kscalelabs/motor-controller/README.md

# K-Scale Motor Controller

## `archive/`
Old motor driver designs

## `pcb/`
New designs, focused on EtherCAT compatibility

No documentation yet (oops) but will show up soon<sup>TM</sup> once I can get some of the motor functions validated
