kscalelabs/motor-controller/pcb/high-power/EtherCATControllerHP/EtherCATControllerHP.kicad_pcb

## KiCad design pcb/high-power/EtherCATControllerHP/EtherCATControllerHP.kicad_pcb (2024-08-08)

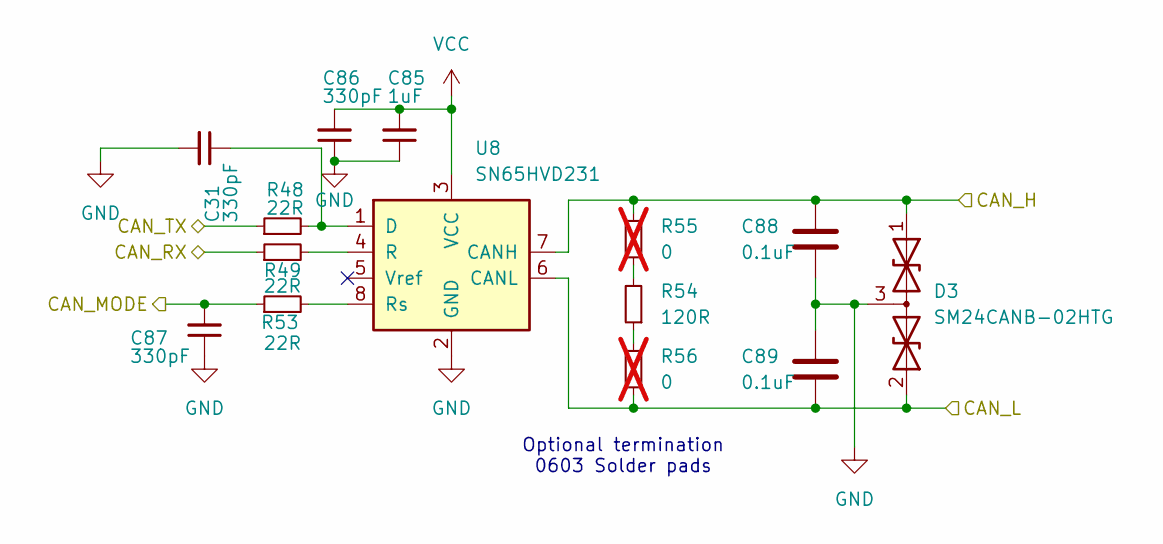
[picture p12: schematic CAN.kicad_sch]

Parts:
C31, C86, C87: 330pF; C_0402_1005Metric; LCSC Part # C526998
C85: 1uF; C_0603_1608Metric; LCSC Part # C106858
C88, C89: 0.1uF; C_0603_1608Metric; TOLERANCE ±10%; VOLTAGE - RATED 50V; MANUFACTURER PART NUMBER GRM188R71H104KA93D; LCSC Part # C77055
D3: SM24CANB-02HTG; SOT-23; LCSC Part # C2937019
R48, R49, R53: 22R; R_0603_1608Metric; LCSC Part # C107701
R54: 120R; R_0402_1005Metric; LCSC Part # C409666
R55, R56: 0; R_0603_1608Metric_Pad0.98x0.95mm_HandSolder; not fitted
U8: SN65HVD231; SOIC-8_3.9x4.9mm_P1.27mm; LCSC Part # C129257

Connections:
/CAN_H: C88.1, D3.1 (A1), R55.1, U8.7 (CANH); also elsewhere on the board
/CAN_L: C89.2, D3.2 (A2), R56.2, U8.6 (CANL); also elsewhere on the board
/CAN_MODE: C87.2, R53.1; also elsewhere on the board
/CAN_RX: R49.1; also elsewhere on the board
/CAN_TX: R48.1; also elsewhere on the board
GND: C31.2, C85.1, C86.1, C87.1, C88.2, C89.1, D3.3 (common), U8.2 (GND); also elsewhere on the board
unnamed: R54.1, R56.1
unnamed: R54.2, R55.2
unnamed: C31.1, R48.2, U8.1 (D)
unnamed: R49.2, U8.4 (R)
unnamed: R53.2, U8.8 (Rs)
VCC: C85.2, C86.2, U8.3 (VCC); also elsewhere on the board

Notes on the sheet:
Optional termination 0603 Solder pads

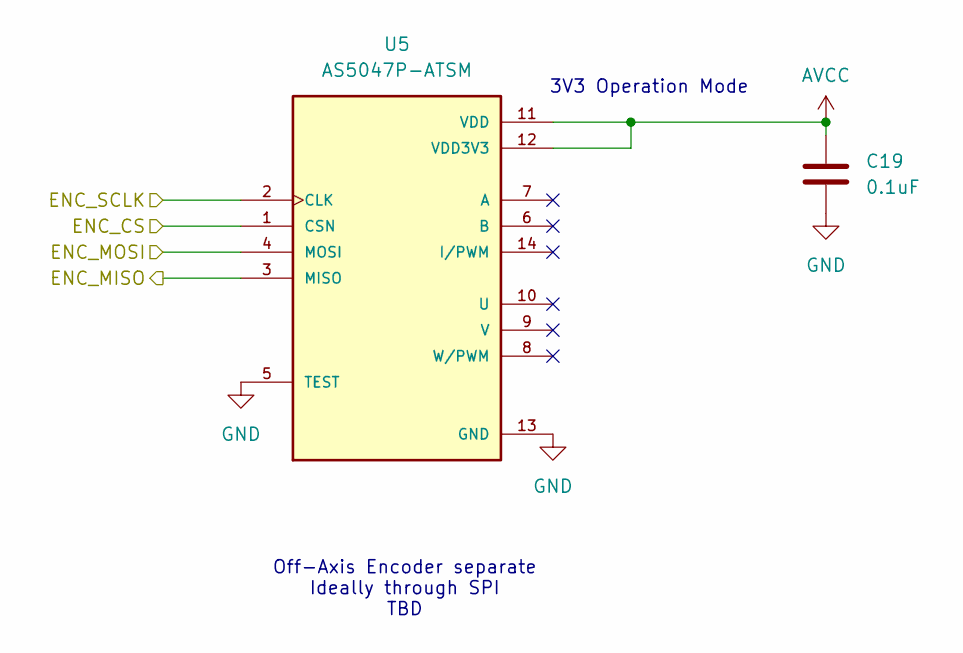
[picture p13: schematic Encoders.kicad_sch]

Parts:
C19: 0.1uF; C_0402_1005Metric; LCSC Part # C77055
U5: AS5047P-ATSM; SOP65P640X120-14N; PARTREV 1-01; LCSC Part # C962063

Connections:
/SPI1_CS: U5.1 (CSN); also elsewhere on the board
/SPI1_MISO: U5.3 (MISO); also elsewhere on the board
/SPI1_MOSI: U5.4 (MOSI); also elsewhere on the board
/SPI1_SCK: U5.2 (CLK); also elsewhere on the board
AVCC: C19.1, U5.11 (VDD), U5.12 (VDD3V3); also elsewhere on the board
GND: C19.2, U5.5 (TEST), U5.13 (GND); also elsewhere on the board

Notes on the sheet:
Off-Axis Encoder separate Ideally through SPI TBD
3V3 Operation Mode

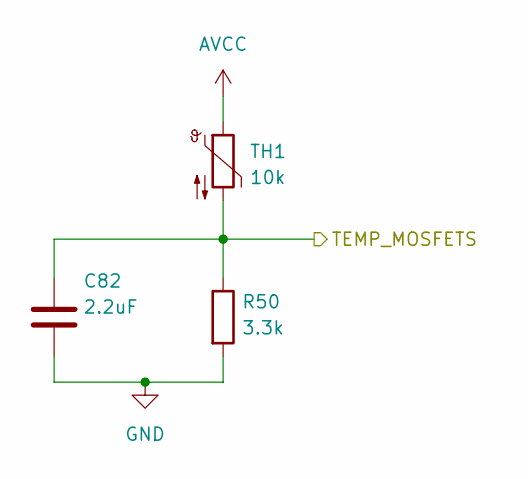
[picture p14: schematic Temperature.kicad_sch]

Parts:
C82: 2.2uF; C_0603_1608Metric; TOLERANCE ±10%; VOLTAGE - RATED 16V; MANUFACTURER PART NUMBER GRM188R61C225KE15D; LCSC Part # C77183
R50: 3.3k; R_0603_1608Metric; TOLERANCE ±1%; MANUFACTURER PART NUMBER RC0603FR-073K3L; LCSC Part # C108078
TH1: 10k; R_0402_1005Metric; LCSC Part # C77131

Connections:
/TEMP_MOSFETS: C82.1, R50.1, TH1.2; also elsewhere on the board
AVCC: TH1.1; also elsewhere on the board
GND: C82.2, R50.2; also elsewhere on the board

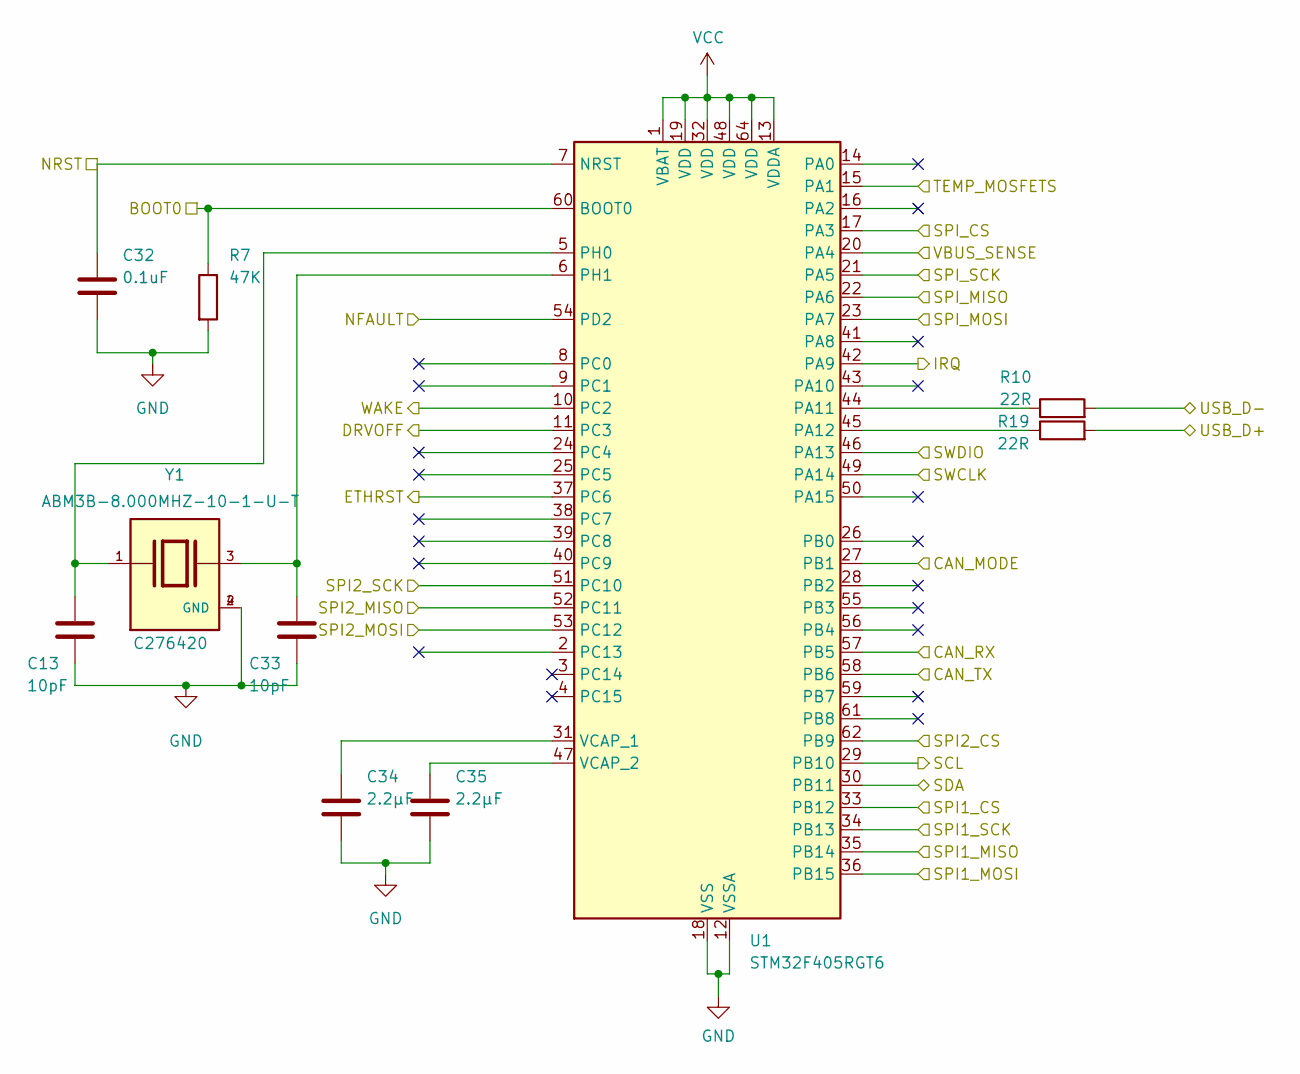
[picture p15: schematic MCU.kicad_sch]

Parts:
C13, C33: 10pF; C_0402_1005Metric; TOLERANCE ±5%; VOLTAGE - RATED 50V; MANUFACTURER PART NUMBER GRM1885C1H100JA01D; LCSC Part # C115606
C32: 0.1uF; C_0603_1608Metric; TOLERANCE ±10%; VOLTAGE - RATED 50V; MANUFACTURER PART NUMBER GRM188R71H104KA93D; LCSC Part # C77055
C34, C35: 2.2µF; C_0603_1608Metric; TOLERANCE ±10%; VOLTAGE - RATED 16V; MANUFACTURER PART NUMBER GRM188R61C225KE15D; LCSC Part # C77183
R7: 47K; R_0603_1608Metric; TOLERANCE ±1%; MANUFACTURER PART NUMBER RC0603FR-0747KL; LCSC Part # C105579
R10, R19: 22R; R_0402_1005Metric; LCSC Part # C107701
U1: STM32F405RGT6; LQFP-64_10x10mm_P0.5mm; LCSC Part # C15742
Y1: ABM3B-8.000MHZ-10-1-U-T; Crystal_SMD_5032-4Pin_5.0x3.2mm; PARTREV 08.25.15; LCSC Part # C276420

Connections:
/BOOT0: R7.1, U1.60 (BOOT0); also elsewhere on the board
/CAN_MODE: U1.27 (PB1); also elsewhere on the board
/CAN_RX: U1.57 (PB5); also elsewhere on the board
/CAN_TX: U1.58 (PB6); also elsewhere on the board
/DRVOFF: U1.11 (PC3); also elsewhere on the board
/ETHRST: U1.37 (PC6); also elsewhere on the board
/I2C_SCL: U1.29 (PB10); also elsewhere on the board
/I2C_SDA: U1.30 (PB11); also elsewhere on the board
/IRQ: U1.42 (PA9); also elsewhere on the board
/NFAULT: U1.54 (PD2); also elsewhere on the board
/NRST: C32.1, U1.7 (NRST)
/SPI1_CS: U1.33 (PB12); also elsewhere on the board
/SPI1_MISO: U1.35 (PB14); also elsewhere on the board
/SPI1_MOSI: U1.36 (PB15); also elsewhere on the board
/SPI1_SCK: U1.34 (PB13); also elsewhere on the board
/SPI2_CS: U1.62 (PB9); also elsewhere on the board
/SPI2_MISO: U1.52 (PC11); also elsewhere on the board
/SPI2_MOSI: U1.53 (PC12); also elsewhere on the board
/SPI2_SCK: U1.51 (PC10); also elsewhere on the board
/SPI_CS: U1.17 (PA3); also elsewhere on the board
/SPI_MISO: U1.22 (PA6); also elsewhere on the board
/SPI_MOSI: U1.23 (PA7); also elsewhere on the board
/SPI_SCK: U1.21 (PA5); also elsewhere on the board
/SWCLK: U1.49 (PA14); also elsewhere on the board
/SWDIO: U1.46 (PA13); also elsewhere on the board
/TEMP_MOSFETS: U1.15 (PA1); also elsewhere on the board
/USB_D+: R19.2; also elsewhere on the board
/USB_D-: R10.2; also elsewhere on the board
/VBUS_SENSE: U1.20 (PA4); also elsewhere on the board
/WAKE: U1.10 (PC2); also elsewhere on the board
GND: C13.2, C32.2, C33.2, C34.2, C35.2, R7.2, U1.12 (VSSA), U1.18 (VSS), U1.63 (VSS), Y1.2 (GND), Y1.4 (GND); also elsewhere on the board
unnamed: R10.1, U1.44 (PA11)
unnamed: R19.1, U1.45 (PA12)
unnamed: C13.1, U1.5 (PH0), Y1.1
unnamed: C33.1, U1.6 (PH1), Y1.3
unnamed: C34.1, U1.31 (VCAP_1)
unnamed: C35.1, U1.47 (VCAP_2)
VCC: U1.1 (VBAT), U1.13 (VDDA), U1.19 (VDD), U1.32 (VDD), U1.48 (VDD), U1.64 (VDD); also elsewhere on the board

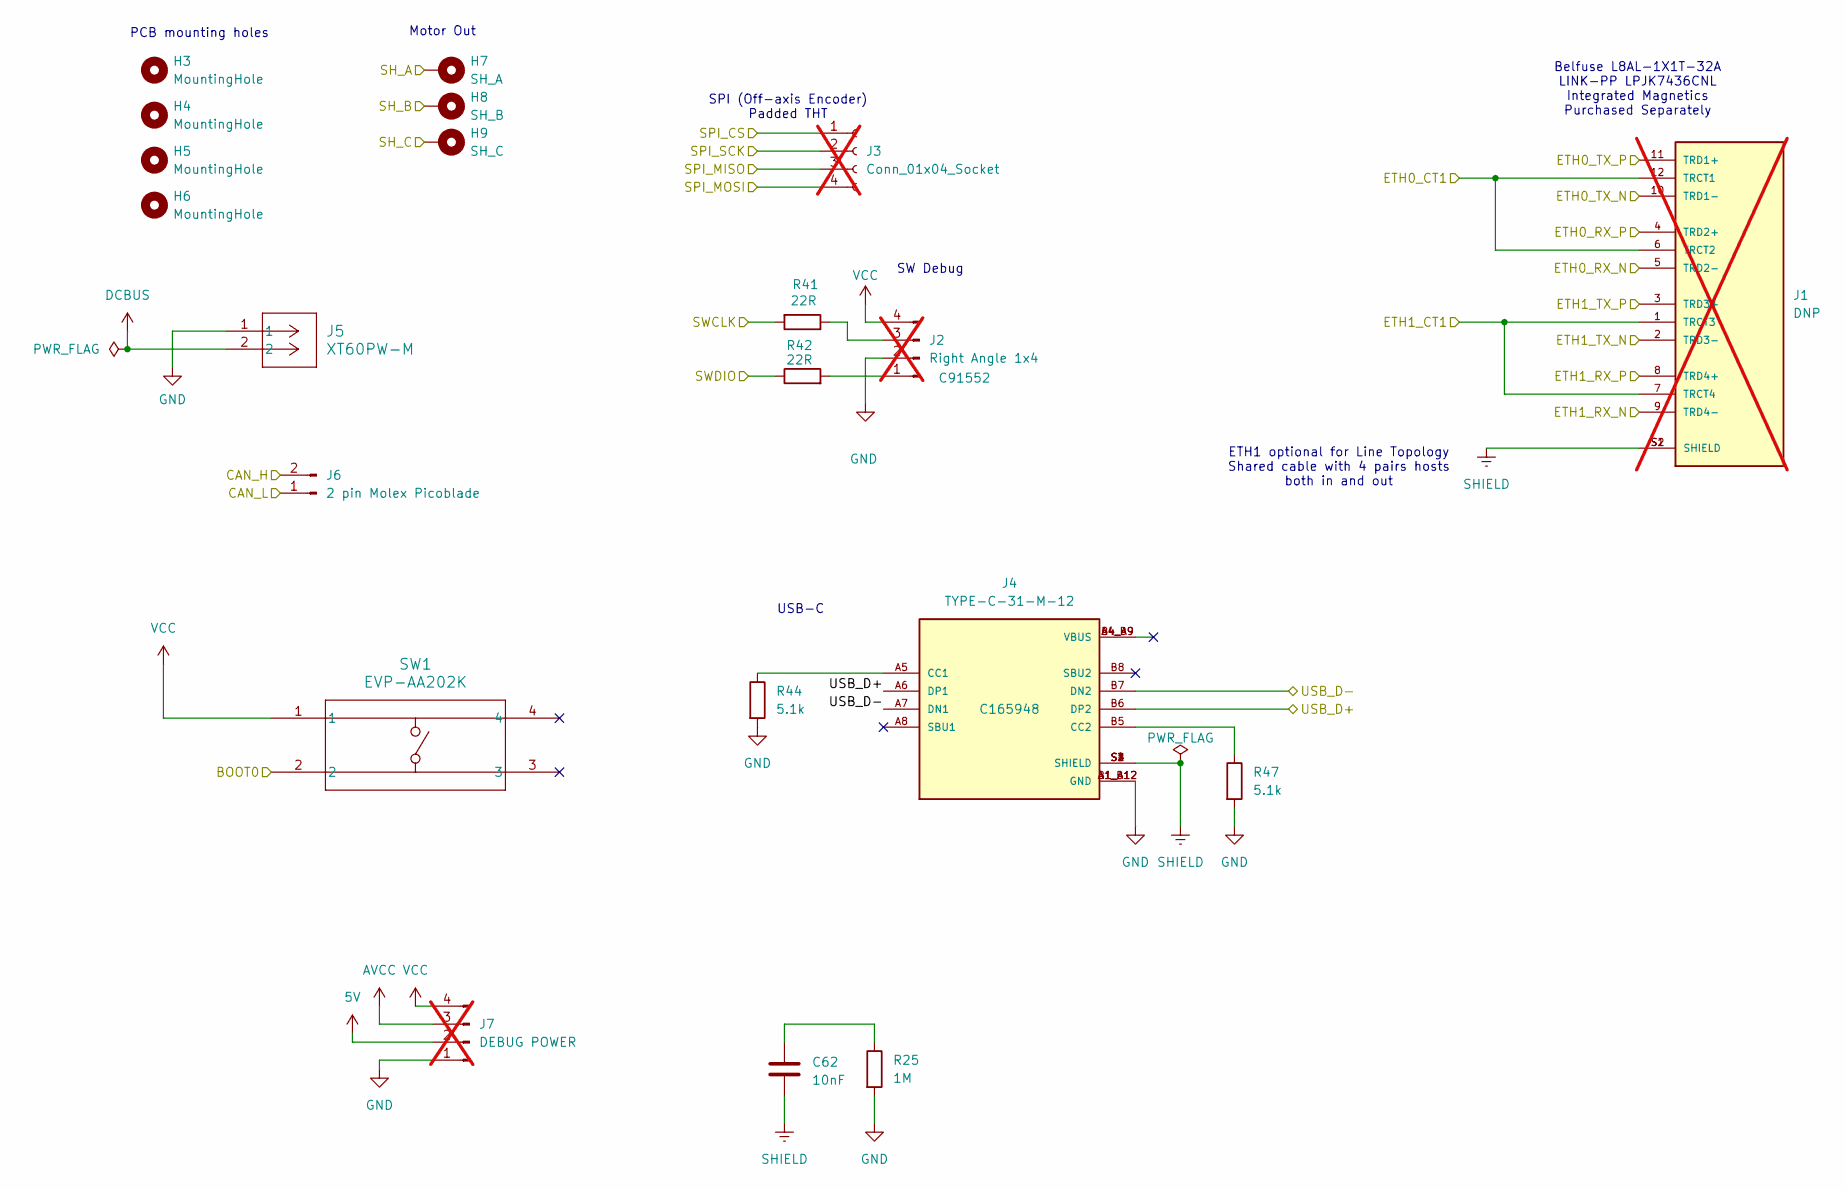
[picture p16: schematic Connectors.kicad_sch]

Parts:
C62: 10nF; C_1812_4532Metric; TOLERANCE ±10%; VOLTAGE - RATED 50V; MANUFACTURER PART NUMBER GRM188R71H104KA93D; LCSC Part # C574051
H3, H4, H5, H6: MountingHole; MountingHole_3.2mm_M3_Pad_Via
H7: SH_A; MountingHole_2.2mm_M2_Pad
H8: SH_B; MountingHole_2.2mm_M2_Pad
H9: SH_C; MountingHole_2.2mm_M2_Pad
J1: DNP; BEL_L8AL-1X1T-32A; PARTREV A; not fitted
J2: Right Angle 1x4; PinHeader_1x04_P1.00mm_Vertical; LCSC Part # C91552; not fitted
J3: Conn_01x04_Socket; PinHeader_1x04_P1.00mm_Vertical; not fitted
J4: TYPE-C-31-M-12; HRO_TYPE-C-31-M-12; PARTREV 2020.12.08; LCSC Part # C165948
J5: XT60PW-M; AMASS_XT60PW-M_1x02_P7.20mm_Horizontal; LCSC Part # C98732
J6: 2 pin Molex Picoblade; Molex_PicoBlade_53048-0210_1x02_P1.25mm_Horizontal; LCSC Part # C505099
J7: DEBUG POWER; PinHeader_1x04_P1.00mm_Vertical; not fitted
R25: 1M; R_0402_1005Metric; LCSC Part # C279988
R41, R42: 22R; R_0603_1608Metric; TOLERANCE ±1%; MANUFACTURER PART NUMBER RC0603FR-0722RL; LCSC Part # C107701
R44, R47: 5.1k; R_0603_1608Metric; LCSC Part # C706184
SW1: EVP-AA202K; SW_EVP-AA102K_PAN; LCSC Part # C79147

Connections:
5V: J7.2; also elsewhere on the board
/BOOT0: SW1.2; also elsewhere on the board
/CAN_H: J6.2; also elsewhere on the board
/CAN_L: J6.1; also elsewhere on the board
/ETH0_CT1: J1.6 (TRCT2), J1.12 (TRCT1); also elsewhere on the board
/ETH0_RXN: J1.5 (TRD2-); also elsewhere on the board
/ETH0_RXP: J1.4 (TRD2+); also elsewhere on the board
/ETH0_TXN: J1.10 (TRD1-); also elsewhere on the board
/ETH0_TXP: J1.11 (TRD1+); also elsewhere on the board
/ETH1_CT1: J1.1 (TRCT3), J1.7 (TRCT4); also elsewhere on the board
/ETH1_RXN: J1.9 (TRD4-); also elsewhere on the board
/ETH1_RXP: J1.8 (TRD4+); also elsewhere on the board
/ETH1_TXN: J1.2 (TRD3-); also elsewhere on the board
/ETH1_TXP: J1.3 (TRD3+); also elsewhere on the board
/SPI_CS: J3.1; also elsewhere on the board
/SPI_MISO: J3.3; also elsewhere on the board
/SPI_MOSI: J3.4; also elsewhere on the board
/SPI_SCK: J3.2; also elsewhere on the board
/SWCLK: R41.2; also elsewhere on the board
/SWDIO: R42.1; also elsewhere on the board
/USB_D+: J4.A6 (DP1), J4.B6 (DP2); also elsewhere on the board
/USB_D-: J4.A7 (DN1), J4.B7 (DN2); also elsewhere on the board
AVCC: J7.3; also elsewhere on the board
DCBUS: J5.2; also elsewhere on the board
GND: J2.2, J4.A1_B12 (GND), J4.B1_A12 (GND), J5.1, J7.1, R25.2, R44.2, R47.2; also elsewhere on the board
unnamed: C62.1, R25.1
unnamed: J2.1, R42.2
unnamed: J2.3, R41.1
unnamed: J4.A5 (CC1), R44.1
unnamed: J4.B5 (CC2), R47.1
SHIELD: C62.2, J1.S1 (SHIELD), J1.S2 (SHIELD), J4.S1 (SHIELD), J4.S2 (SHIELD), J4.S3 (SHIELD), J4.S4 (SHIELD)
VCC: J2.4, J7.4, SW1.1; also elsewhere on the board

Notes on the sheet:
SPI (Off-axis Encoder) Padded THT
Motor Out
Belfuse L8AL-1X1T-32A LINK-PP LPJK7436CNL Integrated Magnetics Purchased Separately
ETH1 optional for Line Topology Shared cable with 4 pairs hosts both in and out
USB-C
PCB mounting holes
SW Debug

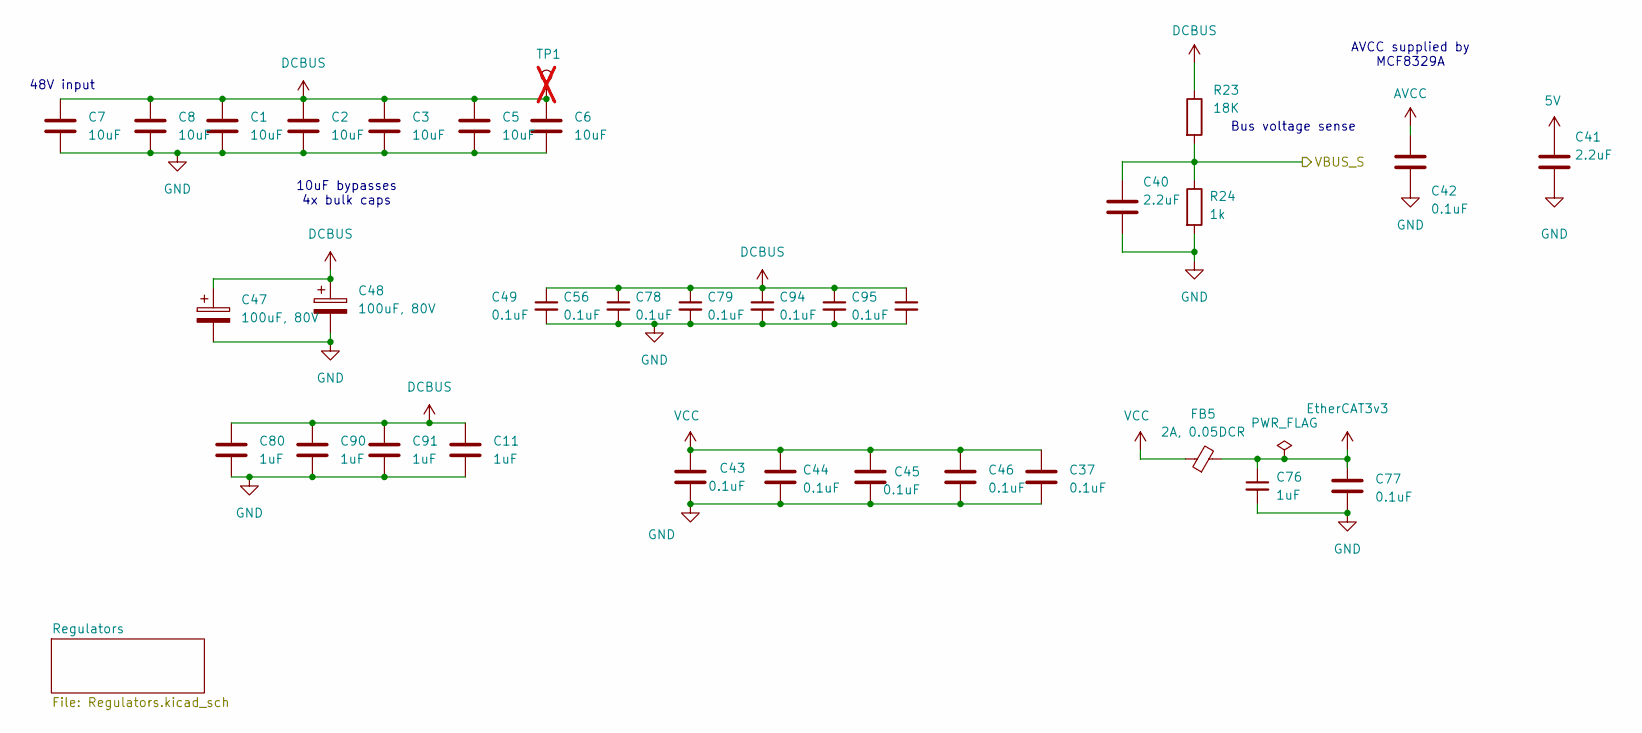
[picture p17: schematic Power.kicad_sch]

Parts:
C1, C2, C3, C5, C6, C7, C8: 10uF; C_1210_3225Metric; LCSC Part # C5156756
C11, C80, C90, C91: 1uF; C_1206_3216Metric; LCSC Part # C13832
C37, C43, C44, C45, C46, C77: 0.1uF; C_0603_1608Metric; TOLERANCE ±10%; VOLTAGE - RATED 50V; MANUFACTURER PART NUMBER GRM188R71H104KA93D; LCSC Part # C77055
C40, C41: 2.2uF; C_0603_1608Metric; TOLERANCE ±10%; VOLTAGE - RATED 16V; MANUFACTURER PART NUMBER GRM188R61C225KE15D; LCSC Part # C77183
C42: 0.1uF; C_0603_1608Metric; TOLERANCE ±10%; VOLTAGE - RATED 50V; MANUFACTURER PART NUMBER GRM188R71H104KA93D; LCSC Part # C14663
C47, C48: 100uF, 80V; CP_Elec_10x10; LCSC Part # C487410
C49, C56, C78, C79, C94, C95: 0.1uF; C_0805_2012Metric; LCSC Part # C28233
C76: 1uF; C_0603_1608Metric; LCSC Part # C106858
FB5: 2A, 0.05DCR; L_1206_3216Metric; LCSC Part # C380287
R23: 18K; R_0603_1608Metric; TOLERANCE ±1%; MANUFACTURER PART NUMBER RC0603FR-0710KL; LCSC Part # C98220
R24: 1k; R_0603_1608Metric; TOLERANCE ±1%; MANUFACTURER PART NUMBER RC0603FR-071KL; LCSC Part # C22548
TP1: TESTPOINT; TestPoint_Pad_1.0x1.0mm; not fitted

Connections:
5V: C41.1; also elsewhere on the board
/VBUS_SENSE: C40.1, R23.2, R24.1; also elsewhere on the board
AVCC: C42.1; also elsewhere on the board
DCBUS: C1.1, C2.1, C3.1, C5.1, C6.1, C7.1, C8.1, C11.1, C47.1, C48.1, C49.1, C56.1, C78.1, C79.1, C80.1, C90.1, C91.1, C94.1, C95.1, R23.1, TP1.1; also elsewhere on the board
EtherCAT3v3: C76.1, C77.1, FB5.2; also elsewhere on the board
GND: C1.2, C2.2, C3.2, C5.2, C6.2, C7.2, C8.2, C11.2, C37.2, C40.2, C41.2, C42.2, C43.2, C44.2, C45.2, C46.2, C47.2, C48.2, C49.2, C56.2, C76.2, C77.2, C78.2, C79.2, C80.2, C90.2, C91.2, C94.2, C95.2, R24.2; also elsewhere on the board
VCC: C37.1, C43.1, C44.1, C45.1, C46.1, FB5.1; also elsewhere on the board

Notes on the sheet:
10uF bypasses 4x bulk caps
48V input
Bus voltage sense
AVCC supplied by MCF8329A

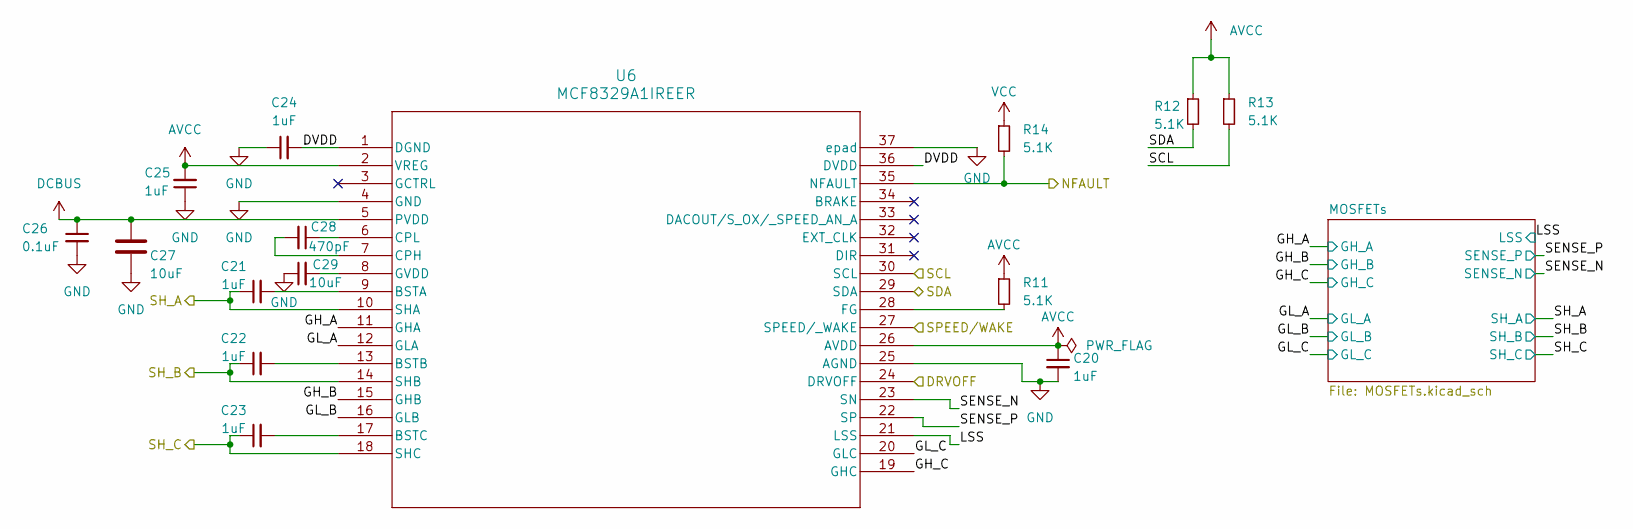
[picture p18: schematic Motor.kicad_sch]

Parts:
C20, C24, C25: 1uF; C_0603_1608Metric; LCSC Part # C106858
C21, C22, C23: 1uF; C_0603_1608Metric; LCSC Part # C105174
C26: 0.1uF; C_0805_2012Metric; LCSC Part # C28233
C27: 10uF; C_1210_3225Metric; LCSC Part # C5156756
C28: 470pF; C_0603_1608Metric; LCSC Part # C107062
C29: 10uF; C_0603_1608Metric; LCSC Part # C194427
R11, R12, R13, R14: 5.1K; R_0402_1005Metric; LCSC Part # C105872
U6: MCF8329A1IREER; WQFN36_REE_TEX; LCSC Part # C22399784

Connections:
/DRVOFF: U6.24 (DRVOFF); also elsewhere on the board
/I2C_SCL: R13.2, U6.30 (SCL); also elsewhere on the board
/I2C_SDA: R12.2, U6.29 (SDA); also elsewhere on the board
/Motor/DVDD: C24.2, U6.1 (DGND), U6.36 (DVDD)
/Motor/GH_A: U6.11 (GHA); also elsewhere on the board
/Motor/GH_B: U6.15 (GHB); also elsewhere on the board
/Motor/GH_C: U6.19 (GHC); also elsewhere on the board
/Motor/GL_A: U6.12 (GLA); also elsewhere on the board
/Motor/GL_B: U6.16 (GLB); also elsewhere on the board
/Motor/GL_C: U6.20 (GLC); also elsewhere on the board
/Motor/LSS: U6.21 (LSS); also elsewhere on the board
/Motor/SENSE_N: U6.23 (SN); also elsewhere on the board
/Motor/SENSE_P: U6.22 (SP); also elsewhere on the board
/NFAULT: R14.2, U6.35 (NFAULT); also elsewhere on the board
/SH_A: C21.1, U6.10 (SHA); also elsewhere on the board
/SH_B: C22.1, U6.14 (SHB); also elsewhere on the board
/SH_C: C23.1, U6.18 (SHC); also elsewhere on the board
/WAKE: U6.27 (SPEED/_WAKE); also elsewhere on the board
AVCC: C20.1, C25.2, R11.1, R12.1, R13.1, U6.2 (VREG), U6.26 (AVDD); also elsewhere on the board
DCBUS: C26.1, C27.1, U6.5 (PVDD); also elsewhere on the board
GND: C20.2, C24.1, C25.1, C26.2, C27.2, C29.1, U6.4 (GND), U6.25 (AGND), U6.37 (epad); also elsewhere on the board
unnamed: C21.2, U6.9 (BSTA)
unnamed: C22.2, U6.13 (BSTB)
unnamed: C23.2, U6.17 (BSTC)
unnamed: C28.2, U6.7 (CPH)
unnamed: C28.1, U6.6 (CPL)
unnamed: R11.2, U6.28 (FG)
unnamed: C29.2, U6.8 (GVDD)
VCC: R14.1; also elsewhere on the board

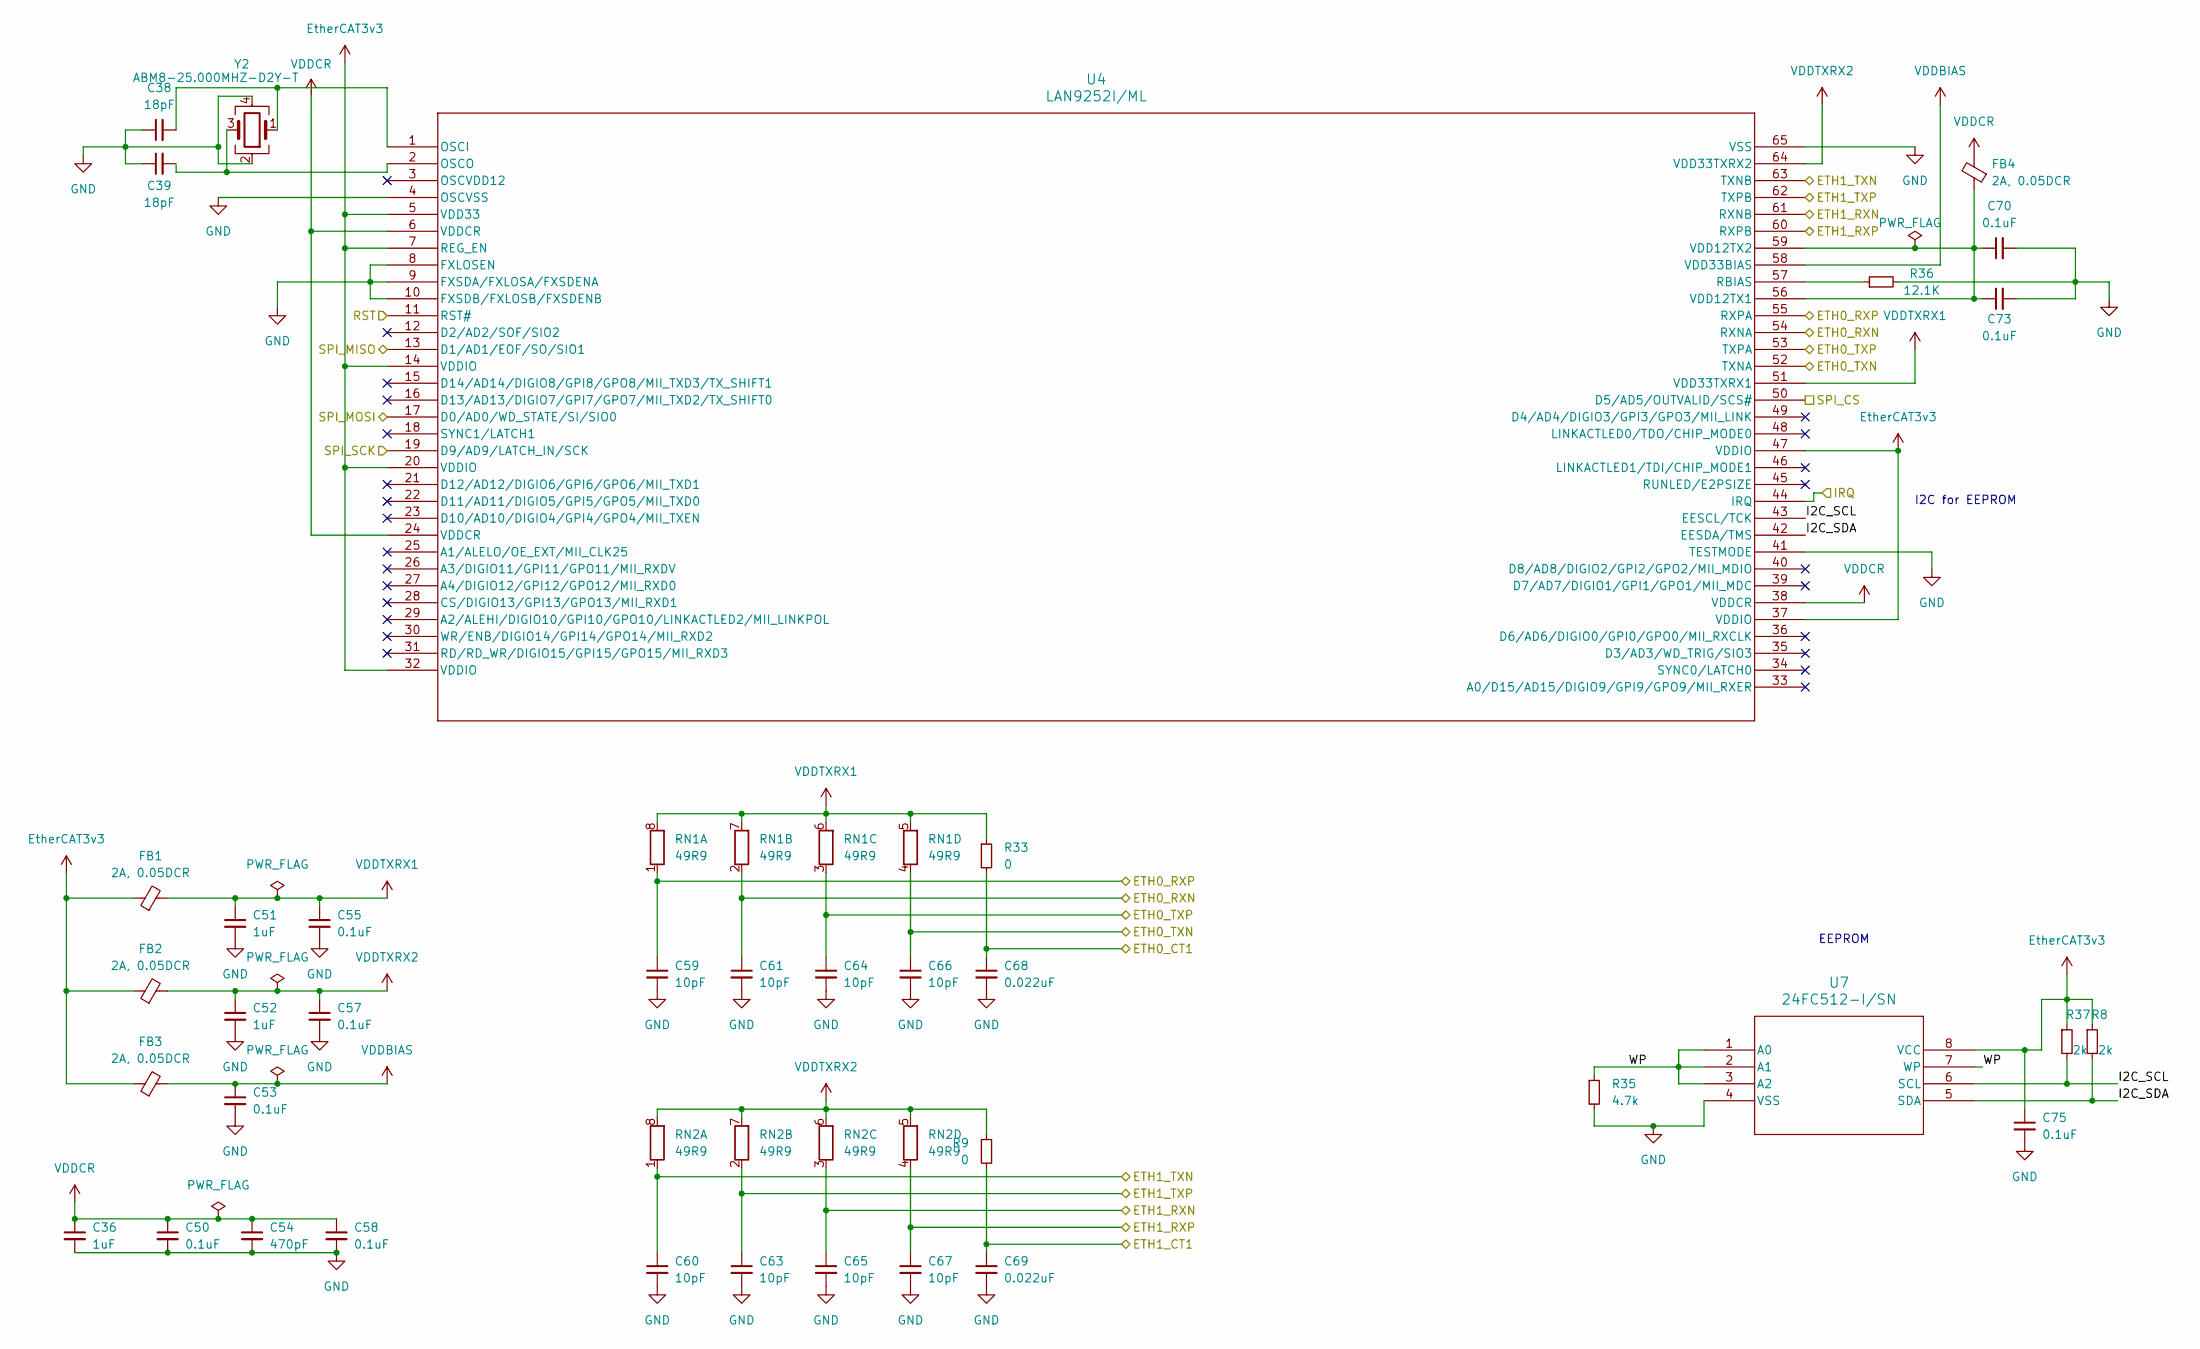
[picture p19: schematic EtherCAT.kicad_sch]

Parts:
C36, C51, C52: 1uF; C_0603_1608Metric; LCSC Part # C106858
C38, C39: 18pF; C_0402_1005Metric; LCSC Part # C76701
C50, C53, C55, C57, C58, C70, C73, C75: 0.1uF; C_0603_1608Metric; LCSC Part # C77055
C54: 470pF; C_0402_1005Metric; LCSC Part # C106207
C59, C60, C61, C63, C64, C65, C66, C67: 10pF; C_0402_1005Metric; LCSC Part # C115606
C68, C69: 0.022uF; C_0402_1005Metric; LCSC Part # C147616
FB1, FB2, FB3, FB4: 2A, 0.05DCR; L_1206_3216Metric; LCSC Part # C380287
R8, R37: 2k; R_0402_1005Metric; LCSC Part # C144035
R9, R33: 0; R_0402_1005Metric; LCSC Part # C106231
R35: 4.7k; R_0402_1005Metric; LCSC Part # C105871
R36: 12.1K; R_0402_1005Metric; LCSC Part # C281773
RN1, RN2: 49R9; R_Array_Convex_4x0402; LCSC Part # C136850
U4: LAN9252I/ML; QFN64_ML_MCH; LCSC Part # C2758355
U7: 24FC512-I/SN; SOP-8_3.9x4.9mm_P1.27mm; LCSC Part # C615159
Y2: ABM8-25.000MHZ-D2Y-T; Crystal_SMD_3225-4Pin_3.2x2.5mm; LCSC Part # C179643

Connections:
/ETH0_CT1: C68.1, R33.2; also elsewhere on the board
/ETH0_RXN: C61.1, RN1.2 (R2.1), U4.54 (RXNA); also elsewhere on the board
/ETH0_RXP: C59.1, RN1.1 (R1.1), U4.55 (RXPA); also elsewhere on the board
/ETH0_TXN: C66.1, RN1.4 (R4.1), U4.52 (TXNA); also elsewhere on the board
/ETH0_TXP: C64.1, RN1.3 (R3.1), U4.53 (TXPA); also elsewhere on the board
/ETH1_CT1: C69.1, R9.2; also elsewhere on the board
/ETH1_RXN: C65.1, RN2.3 (R3.1), U4.61 (RXNB); also elsewhere on the board
/ETH1_RXP: C67.1, RN2.4 (R4.1), U4.60 (RXPB); also elsewhere on the board
/ETH1_TXN: C60.1, RN2.1 (R1.1), U4.63 (TXNB); also elsewhere on the board
/ETH1_TXP: C63.1, RN2.2 (R2.1), U4.62 (TXPB); also elsewhere on the board
/ETHRST: U4.11 (RST#); also elsewhere on the board
/EtherCAT/I2C_SCL: R37.2, U4.43 (EESCL/TCK), U7.6 (SCL)
/EtherCAT/I2C_SDA: R8.2, U4.42 (EESDA/TMS), U7.5 (SDA)
/EtherCAT/WP: R35.1, U7.1 (A0), U7.2 (A1), U7.3 (A2), U7.7 (WP)
/IRQ: U4.44 (IRQ); also elsewhere on the board
/SPI2_CS: U4.50 (D5/AD5/OUTVALID/SCS#); also elsewhere on the board
/SPI2_MISO: U4.13 (D1/AD1/EOF/SO/SIO1); also elsewhere on the board
/SPI2_MOSI: U4.17 (D0/AD0/WD_STATE/SI/SIO0); also elsewhere on the board
/SPI2_SCK: U4.19 (D9/AD9/LATCH_IN/SCK); also elsewhere on the board
EtherCAT3v3: C75.1, FB1.1, FB2.1, FB3.1, R8.1, R37.1, U4.5 (VDD33), U4.7 (REG_EN), U4.14 (VDDIO), U4.20 (VDDIO), U4.32 (VDDIO), U4.37 (VDDIO), U4.47 (VDDIO), U7.8 (VCC); also elsewhere on the board
GND: C36.2, C38.1, C39.1, C50.2, C51.2, C52.2, C53.2, C54.2, C55.2, C57.2, C58.2, C59.2, C60.2, C61.2, C63.2, C64.2, C65.2, C66.2, C67.2, C68.2, C69.2, C70.2, C73.2, C75.2, R35.2, R36.2, U4.4 (OSCVSS), U4.8 (FXLOSEN), U4.9 (FXSDA/FXLOSA/FXSDENA), U4.10 (FXSDB/FXLOSB/FXSDENB), U4.41 (TESTMODE), U4.65 (VSS), U7.4 (VSS), Y2.2, Y2.4; also elsewhere on the board
unnamed: C38.2, U4.1 (OSCI), Y2.1
unnamed: C39.2, U4.2 (OSCO), Y2.3
unnamed: R36.1, U4.57 (RBIAS)
unnamed: C70.1, C73.1, FB4.1, U4.56 (VDD12TX1), U4.59 (VDD12TX2)
VDDBIAS: C53.1, FB3.2, U4.58 (VDD33BIAS)
VDDCR: C36.1, C50.1, C54.1, C58.1, FB4.2, U4.6 (VDDCR), U4.24 (VDDCR), U4.38 (VDDCR)
VDDTXRX1: C51.1, C55.1, FB1.2, R33.1, RN1.5 (R4.2), RN1.6 (R3.2), RN1.7 (R2.2), RN1.8 (R1.2), U4.51 (VDD33TXRX1)
VDDTXRX2: C52.1, C57.1, FB2.2, R9.1, RN2.5 (R4.2), RN2.6 (R3.2), RN2.7 (R2.2), RN2.8 (R1.2), U4.64 (VDD33TXRX2)

Notes on the sheet:
EEPROM
I2C for EEPROM

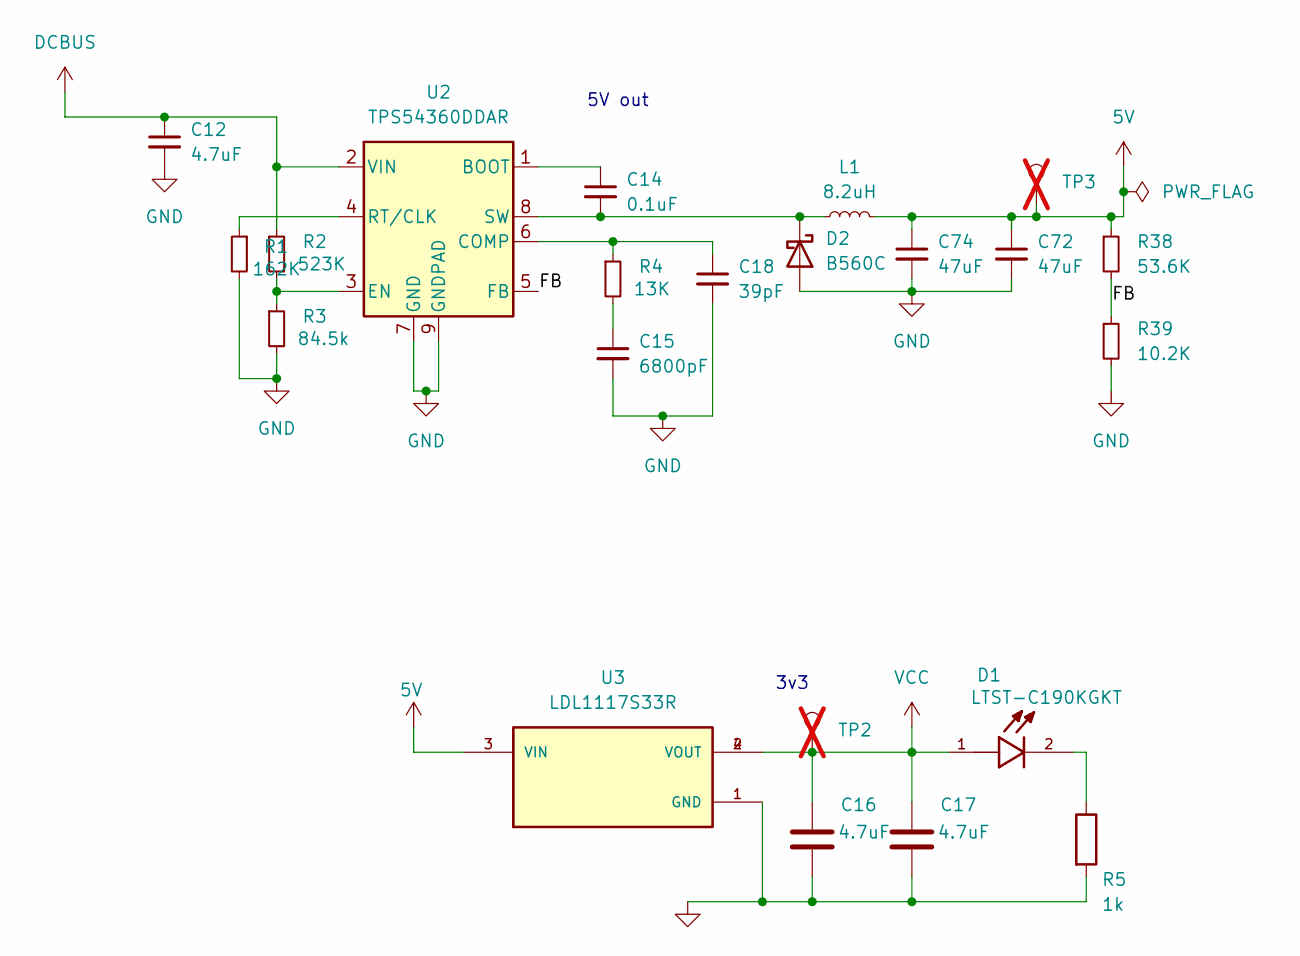
[picture p20: schematic Regulators.kicad_sch]

Parts:
C12: 4.7uF; C_1210_3225Metric; LCSC Part # C6120033
C14: 0.1uF; C_0402_1005Metric; LCSC Part # C105883
C15: 6800pF; C_0402_1005Metric; LCSC Part # C93654
C16, C17: 4.7uF; C_0805_2012Metric; TOLERANCE ±10%; VOLTAGE - RATED 35V; PART STATUS Active; LCSC Part # C913498
C18: 39pF; C_0402_1005Metric; LCSC Part # C147447
C72, C74: 47uF; C_0805_2012Metric; LCSC Part # C178332
D1: LTST-C190KGKT; D_0603_1608Metric; LCSC Part # C125094
D2: B560C; D_SMC; LCSC Part # C85100
L1: 8.2uH; L_Sunlord_MWSA0603S; LCSC Part # C408450
R1: 162K; R_0603_1608Metric; LCSC Part # C227450
R2: 523K; R_0603_1608Metric_Pad0.98x0.95mm_HandSolder; LCSC Part # C23076
R3: 84.5k; R_0603_1608Metric; LCSC Part # C706195
R4: 13K; R_0402_1005Metric; LCSC Part # C310197
R5: 1k; R_0603_1608Metric; TOLERANCE ±1%; MANUFACTURER PART NUMBER RC0603FR-071KL; LCSC Part # C22548
R38: 53.6K; R_0603_1608Metric; LCSC Part # C177851
R39: 10.2K; R_0402_1005Metric; LCSC Part # C321256
TP2, TP3: TESTPOINT; TestPoint_Pad_1.0x1.0mm; not fitted
U2: TPS54360DDAR; TI_SO-PowerPAD-8_ThermalVias; LCSC Part # C524806
U3: LDL1117S33R; SOT-223; PARTREV 7; LCSC Part # C435835

Connections:
5V: C72.1, C74.1, L1.2, R38.1, TP3.1, U3.3 (VIN); also elsewhere on the board
/Power/Regulators/FB: R38.2, R39.1, U2.5 (FB)
DCBUS: C12.1, R2.1, U2.2 (VIN); also elsewhere on the board
GND: C12.2, C15.2, C16.2, C17.2, C18.2, C72.2, C74.2, D2.2 (A), R1.2, R3.2, R5.2, R39.2, U2.7 (GND), U2.9 (GNDPAD), U3.1 (GND); also elsewhere on the board
unnamed: C15.1, R4.2
unnamed: D1.2, R5.1
unnamed: C14.2, D2.1 (K), L1.1, U2.8 (SW)
unnamed: C14.1, U2.1 (BOOT)
unnamed: C18.1, R4.1, U2.6 (COMP)
unnamed: R2.2, R3.1, U2.3 (EN)
unnamed: R1.1, U2.4 (RT/CLK)
VCC: C16.1, C17.1, D1.1, TP2.1, U3.2 (VOUT), U3.4 (VOUT); also elsewhere on the board

Notes on the sheet:
3v3
5V out
