kscalelabs/motor-controller/pcb/high-power/EtherCATControllerHP/EtherCATControllerHP.kicad_pcb

## KiCad design pcb/high-power/EtherCATControllerHP/EtherCATControllerHP.kicad_pcb (continued)

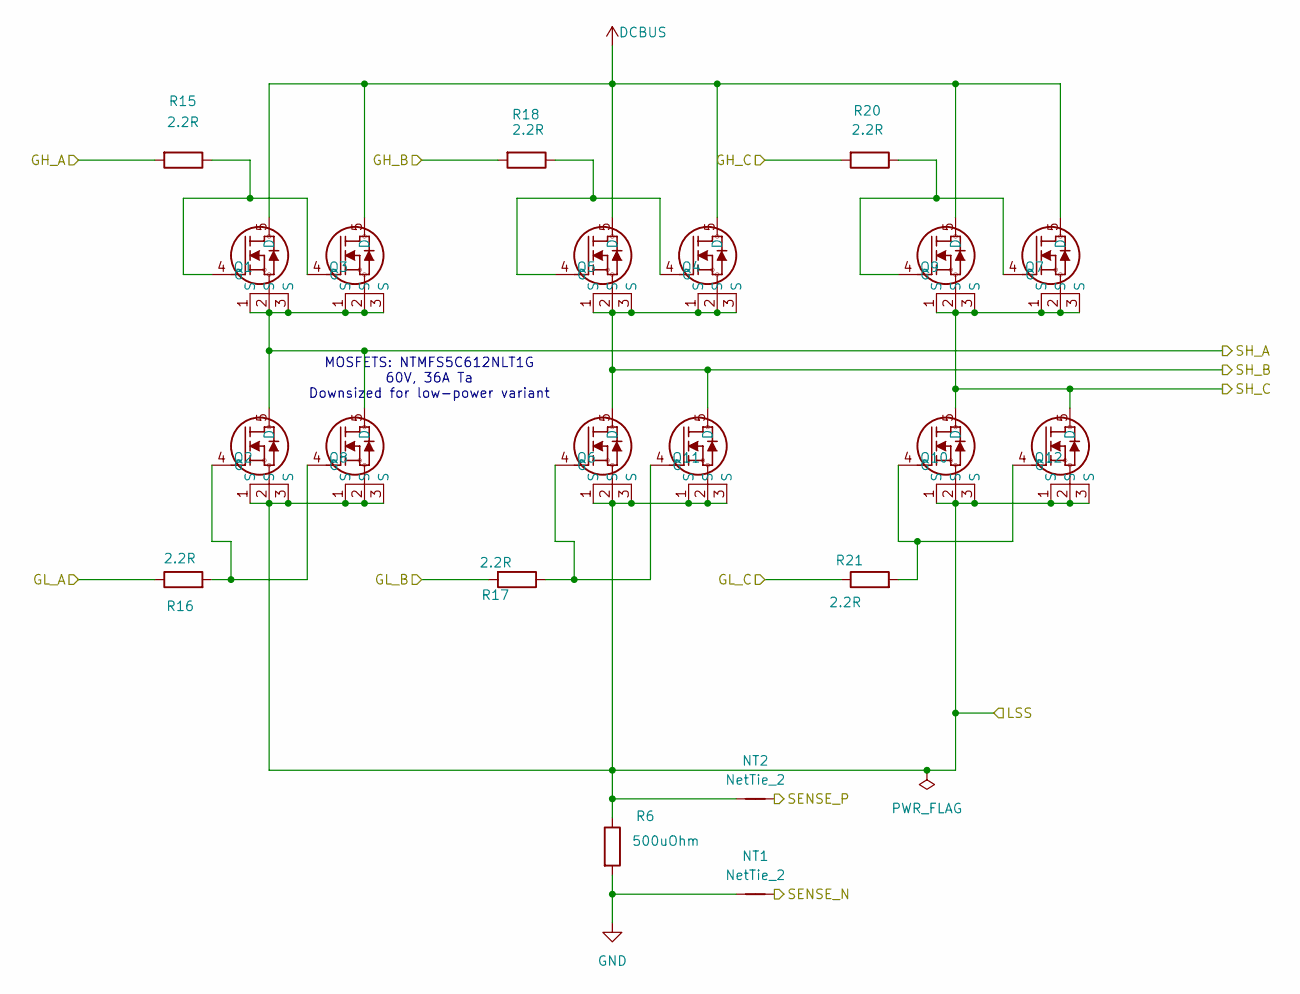
[picture p21: schematic MOSFETs.kicad_sch]

Parts:
NT1, NT2: NetTie_2; NetTie-2_SMD_Pad2.0mm
Q1, Q2, Q3, Q4, Q5, Q6, Q7, Q8, Q9, Q10, Q11, Q12: ONSemi_SO-8FL_488AA; DRIVE VOLTAGE (MAX RDS 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 4.5V, 10V; PART STATUS Active; LCSC Part # C348543
R6: 500uOhm; R_2512_6332Metric; TOLERANCE ±1%; PART STATUS Active; LCSC Part # C500733
R15, R16, R17, R18, R20, R21: 2.2R; R_0603_1608Metric; TOLERANCE ±1%; MANUFACTURER PART NUMBER RC0603FR-072R2L; LCSC Part # C112307

Connections:
/Motor/GH_A: R15.2; also elsewhere on the board
/Motor/GH_B: R18.2; also elsewhere on the board
/Motor/GH_C: R20.2; also elsewhere on the board
/Motor/GL_A: R16.1; also elsewhere on the board
/Motor/GL_B: R17.2; also elsewhere on the board
/Motor/GL_C: R21.1; also elsewhere on the board
/Motor/LSS: NT2.1, Q2.1 (S), Q2.2 (S), Q2.3 (S), Q6.1 (S), Q6.2 (S), Q6.3 (S), Q8.1 (S), Q8.2 (S), Q8.3 (S), Q10.1 (S), Q10.2 (S), Q10.3 (S), Q11.1 (S), Q11.2 (S), Q11.3 (S), Q12.1 (S), Q12.2 (S), Q12.3 (S), R6.1; also elsewhere on the board
/Motor/SENSE_N: NT1.2; also elsewhere on the board
/Motor/SENSE_P: NT2.2; also elsewhere on the board
/SH_A: Q1.1 (S), Q1.2 (S), Q1.3 (S), Q2.5 (D), Q3.1 (S), Q3.2 (S), Q3.3 (S), Q8.5 (D); also elsewhere on the board
/SH_B: Q4.1 (S), Q4.2 (S), Q4.3 (S), Q5.1 (S), Q5.2 (S), Q5.3 (S), Q6.5 (D), Q11.5 (D); also elsewhere on the board
/SH_C: Q7.1 (S), Q7.2 (S), Q7.3 (S), Q9.1 (S), Q9.2 (S), Q9.3 (S), Q10.5 (D), Q12.5 (D); also elsewhere on the board
DCBUS: Q1.5 (D), Q3.5 (D), Q4.5 (D), Q5.5 (D), Q7.5 (D), Q9.5 (D); also elsewhere on the board
GND: NT1.1, R6.2; also elsewhere on the board
unnamed: Q1.4 (G), Q3.4 (G), R15.1
unnamed: Q2.4 (G), Q8.4 (G), R16.2
unnamed: Q4.4 (G), Q5.4 (G), R18.1
unnamed: Q7.4 (G), Q9.4 (G), R20.1
unnamed: Q10.4 (G), Q12.4 (G), R21.2
unnamed: Q6.4 (G), Q11.4 (G), R17.1

Notes on the sheet:
MOSFETS: NTMFS5C612NLT1G 60V, 36A Ta Downsized for low-power variant

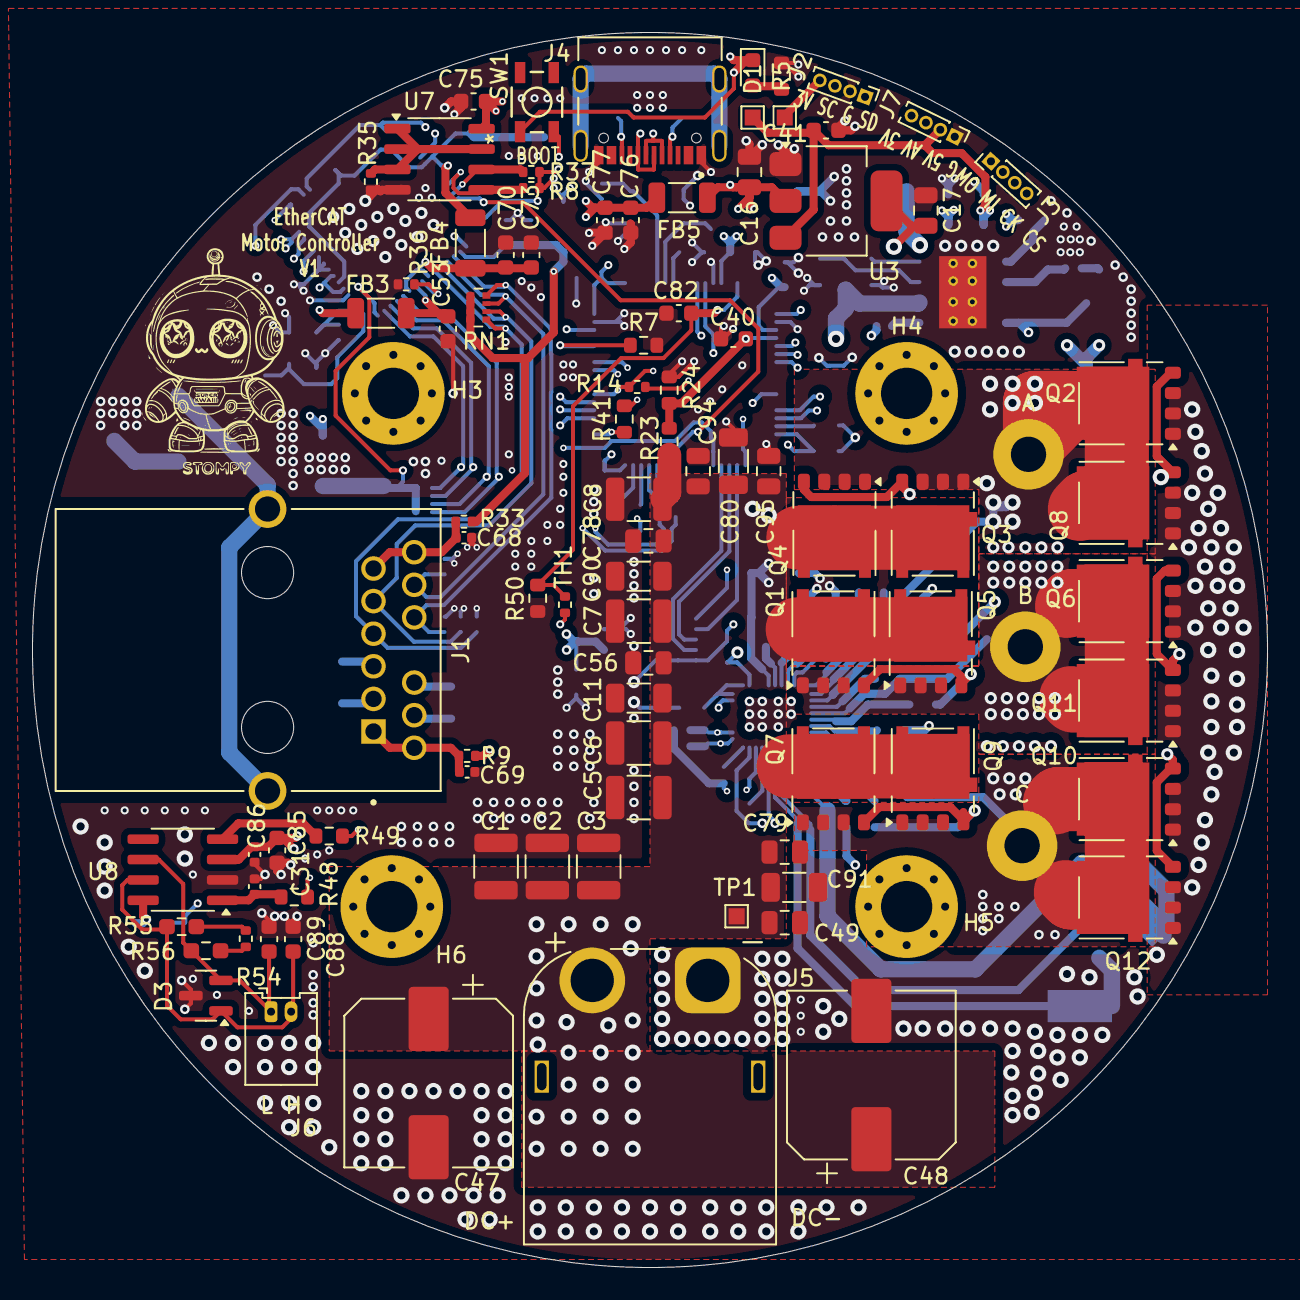
[picture p22: board EtherCATControllerHP.kicad_pcb from above]

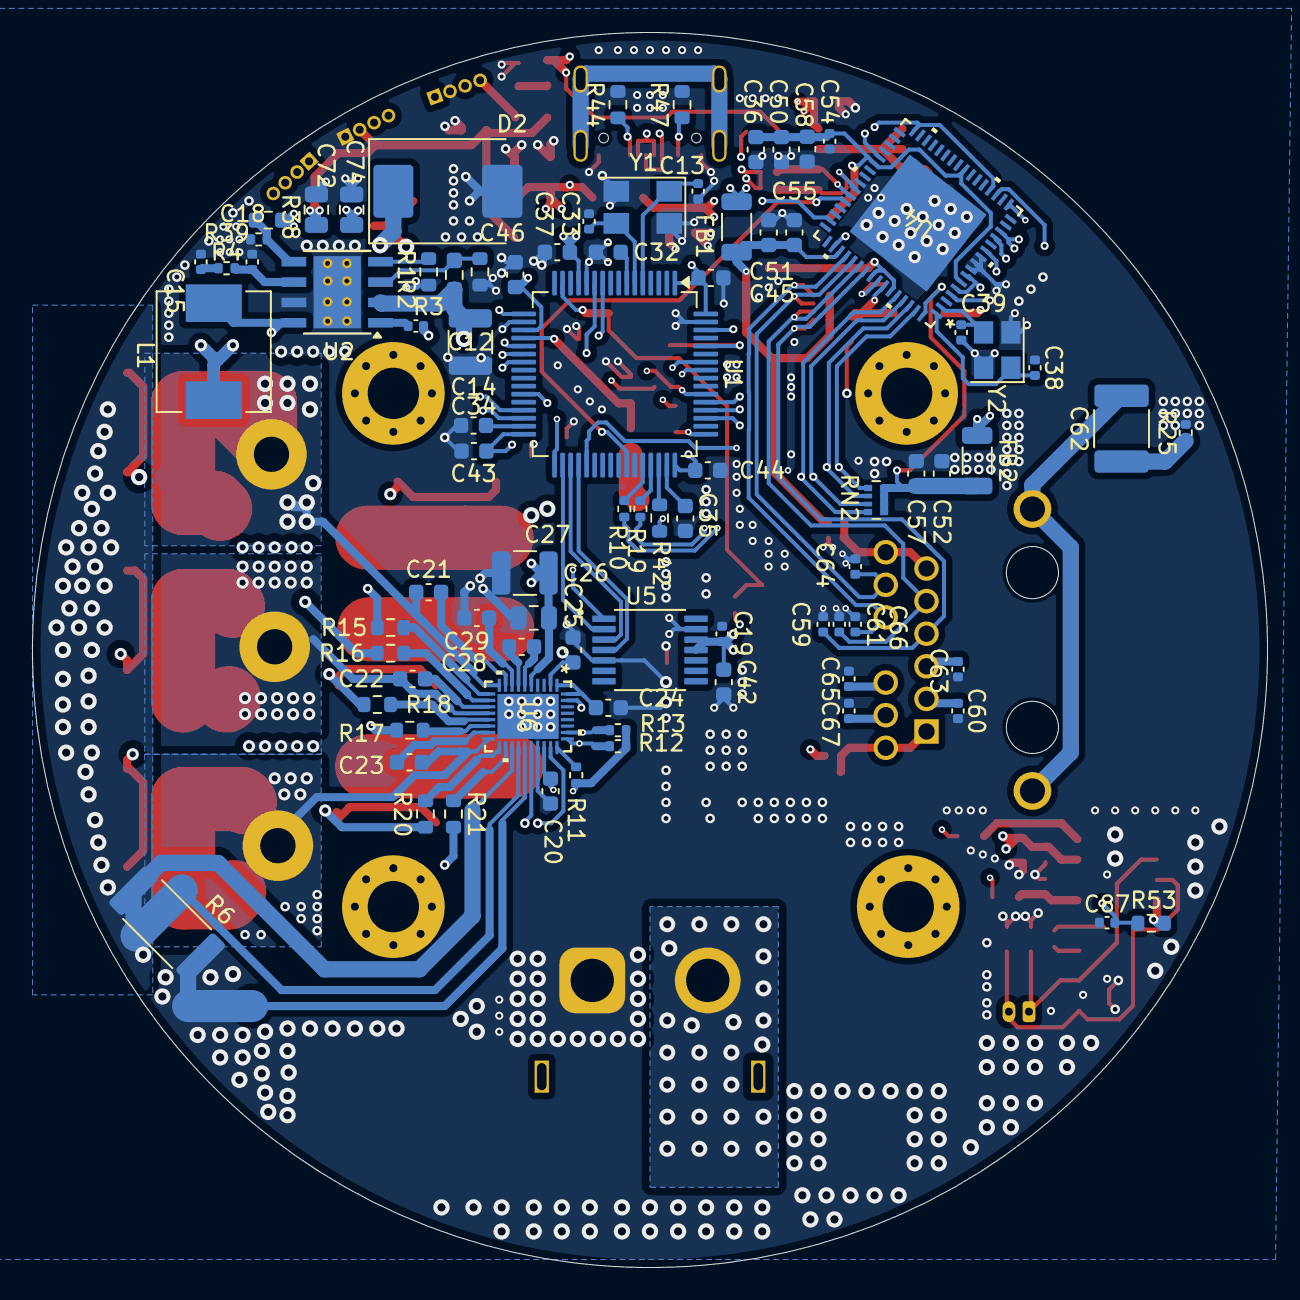
[picture p23: board EtherCATControllerHP.kicad_pcb from below]

Board: 6 copper layers, 77.0 x 77.0 mm, 180 parts (85 on the bottom side), 110 nets.

Other parts of the board:
A: SH_A; MountingHole_2.2mm_M2_Pad
B: SH_B; MountingHole_2.2mm_M2_Pad
C: SH_C; MountingHole_2.2mm_M2_Pad

Their connections:
/SH_A: A.1; also elsewhere on the board
/SH_B: B.1; also elsewhere on the board
/SH_C: C.1; also elsewhere on the board
