kscalelabs/motor-controller/pcb/low-power/IOBoard/IOBoard.kicad_pcb

## KiCad design pcb/low-power/IOBoard/IOBoard.kicad_pcb (2024-08-02)

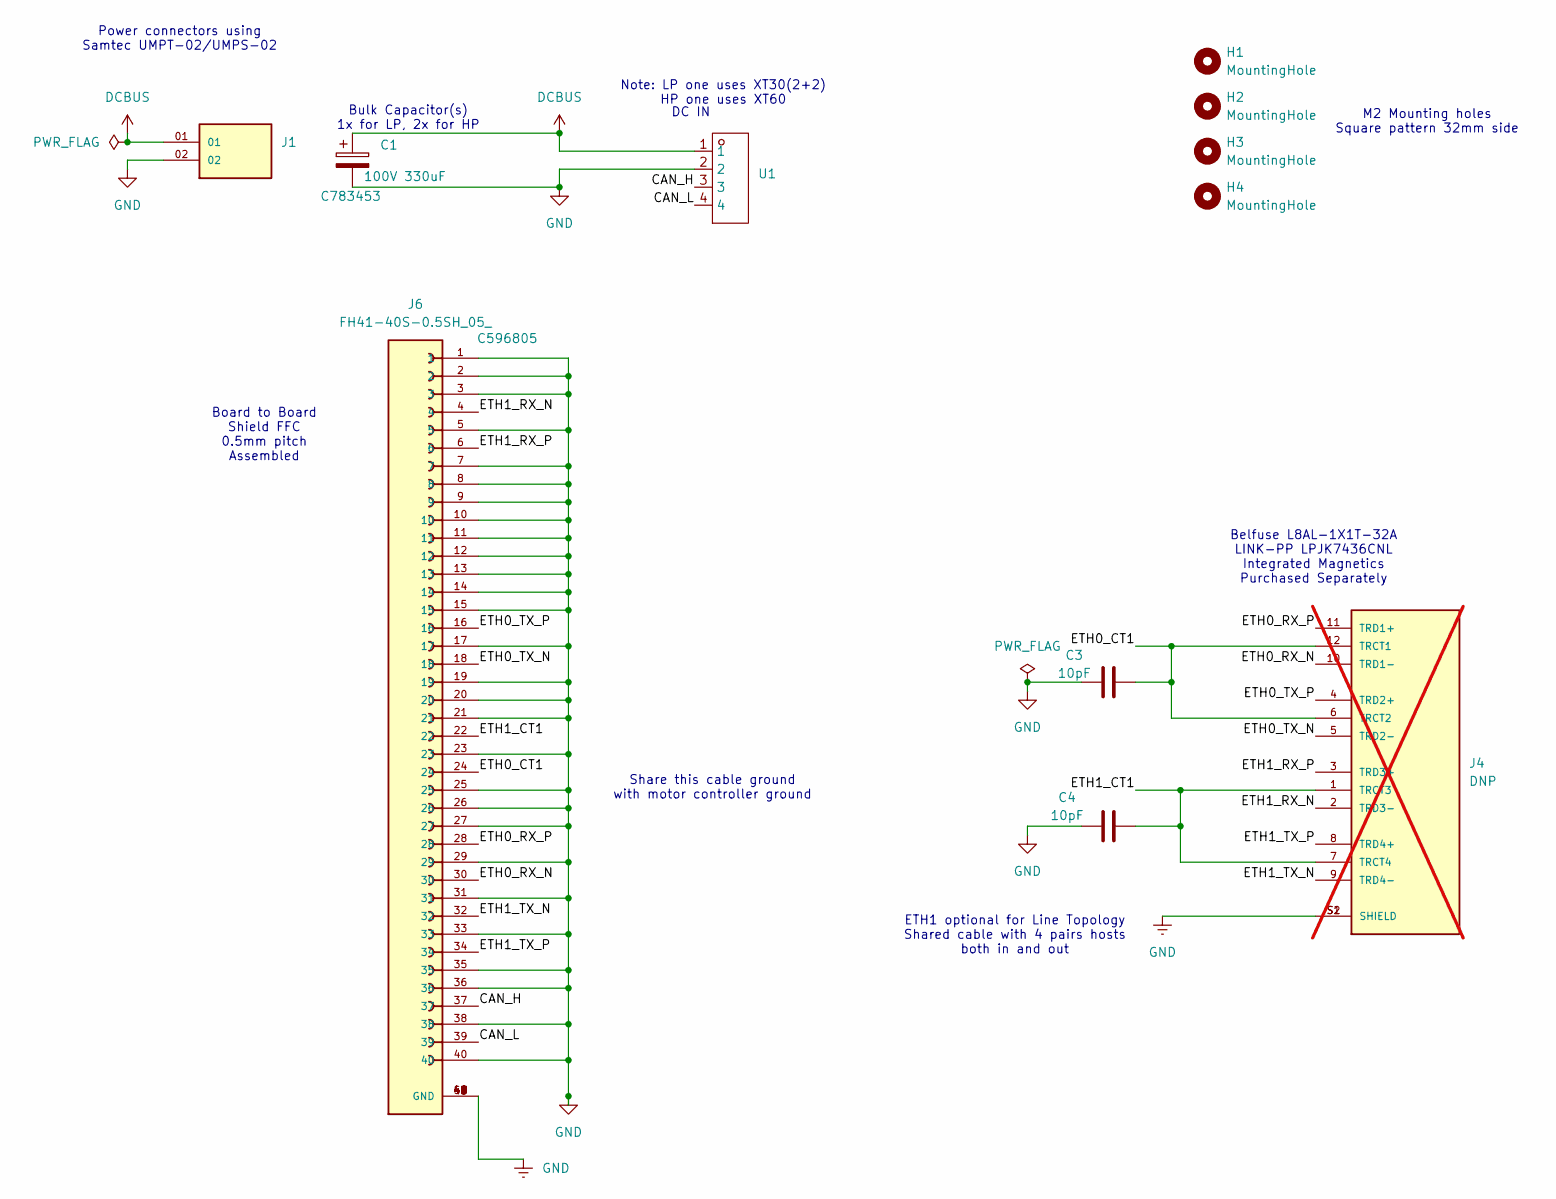
[picture p24: schematic IOBoard.kicad_sch]

Parts:
C1: 100V 330uF; CP_Radial_D13.0mm_P5.00mm-Horizontal; LCSC Part # C783453
C3, C4: 10pF; C_0402_1005Metric; LCSC Part # C650948
H1, H2, H3, H4: MountingHole; MountingHole_2.2mm_M2
J1: UMPS-02-03.5-G-V-S-W-TR; SAMTEC_UMPS-02-03.5-G-V-S-W-TR; PARTREV F
J4: DNP; BEL_L8AL-1X1T-32A; PARTREV A; not fitted
J6: FH41-40S-0.5SH_05_; HRS_FH41-40S-0.5SH_05_; PARTREV 18.03.19; LCSC Part # C596805
U1: CONN-TH_4P-XT30PW-M; Manufacturer Part XT30(2+2)PW-M.G.B; LCSC Part Name XT30PW(2+2)功率数据混合插头公金黑PCB弯插

Connections:
/CAN_H: J6.37, U1.3
/CAN_L: J6.39, U1.4
/ETH0_CT1: C3.2, J4.6 (TRCT2), J4.12 (TRCT1), J6.24
/ETH0_RX_N: J4.10 (TRD1-), J6.30
/ETH0_RX_P: J4.11 (TRD1+), J6.28
/ETH0_TX_N: J4.5 (TRD2-), J6.18
/ETH0_TX_P: J4.4 (TRD2+), J6.16
/ETH1_CT1: C4.2, J4.1 (TRCT3), J4.7 (TRCT4), J6.22
/ETH1_RX_N: J4.2 (TRD3-), J6.4
/ETH1_RX_P: J4.3 (TRD3+), J6.6
/ETH1_TX_N: J4.9 (TRD4-), J6.32
/ETH1_TX_P: J4.8 (TRD4+), J6.34
DCBUS: C1.1, J1.01, U1.1
GND: C1.2, C3.1, C4.1, J1.02, J4.S1 (SHIELD), J4.S2 (SHIELD), J6.1, J6.2, J6.3, J6.5, J6.7, J6.8, J6.9, J6.10, J6.11, J6.12, J6.13, J6.14, J6.15, J6.17, J6.19, J6.20, J6.21, J6.23, J6.25, J6.26, J6.27, J6.29, J6.31, J6.33, J6.35, J6.36, J6.38, J6.40, J6.41 (GND), J6.42 (GND), J6.43 (GND), J6.44 (GND), J6.45 (GND), J6.46 (GND), J6.47 (GND), J6.48 (GND), J6.49 (GND), J6.50 (GND), U1.2

Notes on the sheet:
Belfuse L8AL-1X1T-32A LINK-PP LPJK7436CNL Integrated Magnetics Purchased Separately
ETH1 optional for Line Topology Shared cable with 4 pairs hosts both in and out
M2 Mounting holes Square pattern 32mm side
Board to Board Shield FFC 0.5mm pitch Assembled
Share this cable ground with motor controller ground
DC IN
Power connectors using Samtec UMPT-02/UMPS-02
Note: LP one uses XT30(2+2) HP one uses XT60
Bulk Capacitor(s) 1x for LP, 2x for HP

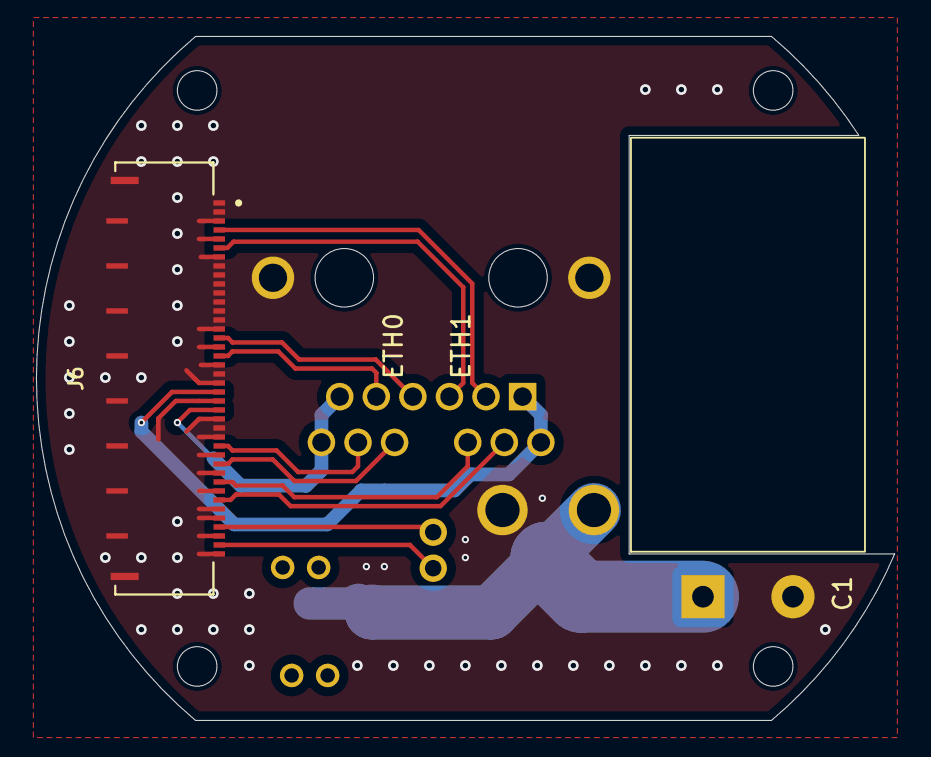
[picture p25: board IOBoard.kicad_pcb from above]

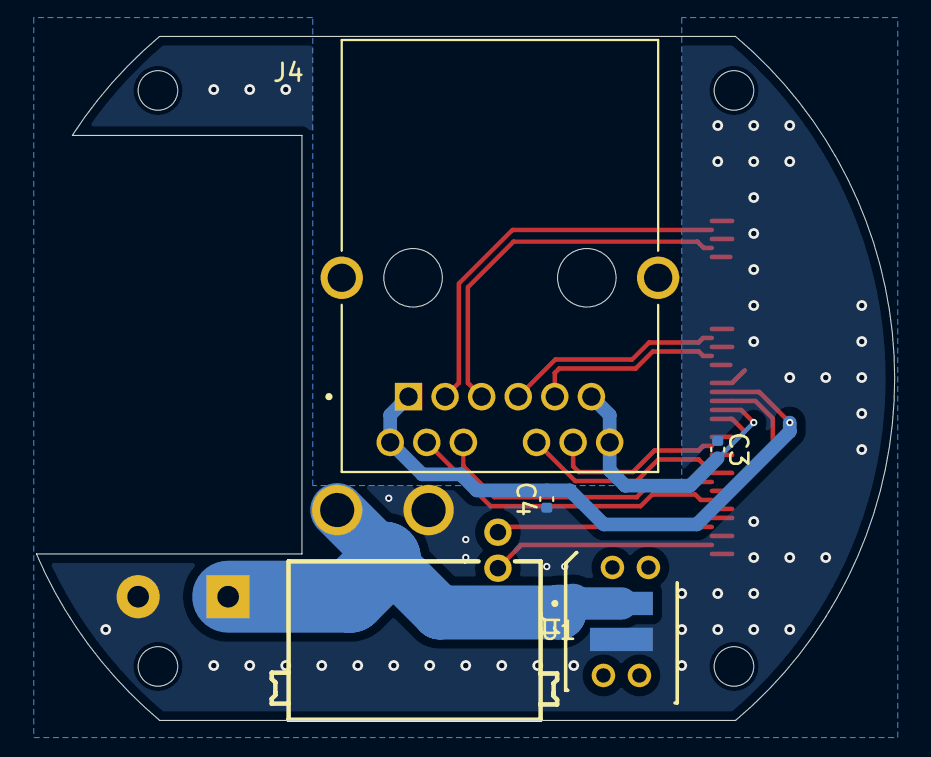
[picture p26: board IOBoard.kicad_pcb from below]

Board: 2 copper layers, 47.7 x 38.0 mm, 11 parts (5 on the bottom side), 14 nets.
