kscalelabs/motor-controller/pcb/low-power/EtherCATControllerLP/EtherCATControllerLP.kicad_pcb

## KiCad design pcb/low-power/EtherCATControllerLP/EtherCATControllerLP.kicad_pcb (2024-08-02)

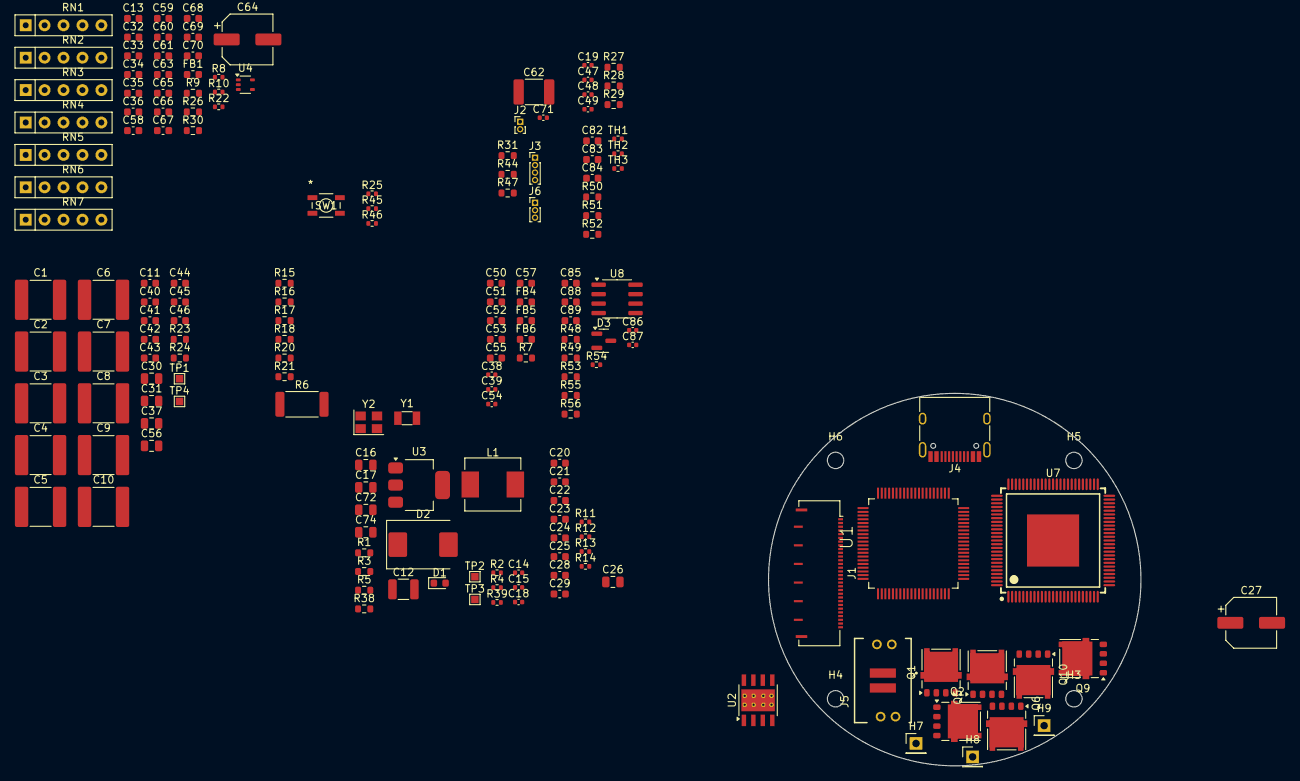
[picture p27: board EtherCATControllerLP.kicad_pcb from above]

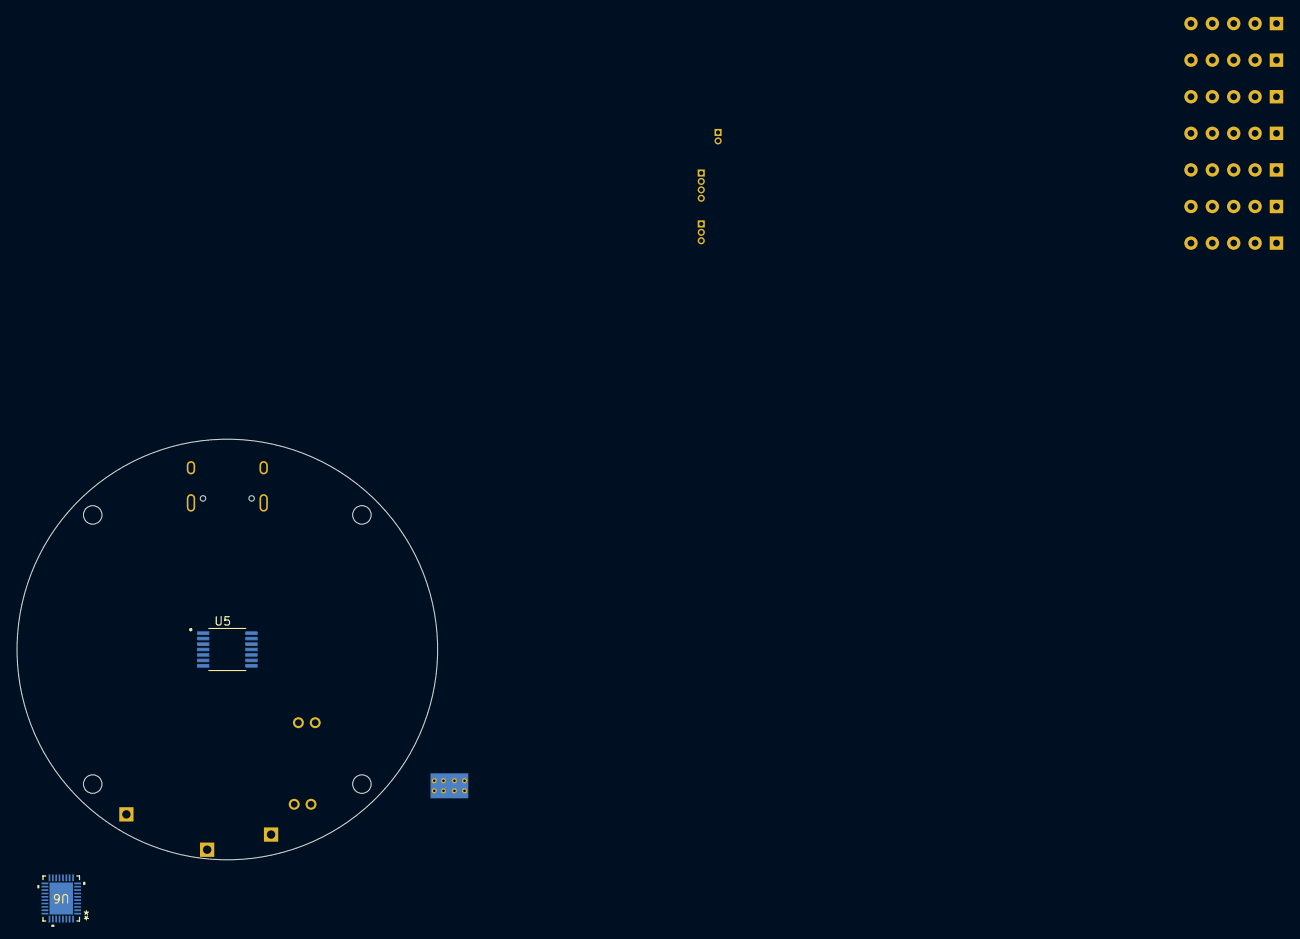
[picture p28: board EtherCATControllerLP.kicad_pcb from below]

Board: 6 copper layers, 178 parts (2 on the bottom side), 144 nets, no tracks yet.

Parts:
C1, C2, C3, C4, C5, C6, C9, C10: 10uF; C_2220_5750Metric
C7, C8: 22uF; C_2220_5750Metric
C11, C13, C32, C33, C34, C35, C36, C42, C43, C44, C45, C46, C50, C51, C52, C53, C55, C57, C58, C59, C60, C61, C63, C65, C66, C67, C68, C69, C70, C88, C89: 0.1uF; C_0603_1608Metric
C12: 4.7uF; C_1210_3225Metric
C14, C19: 0.1uF; C_0402_1005Metric
C15: 6800pF; C_0402_1005Metric
C16, C17: 4.7uF; C_0805_2012Metric
C18: 39pF; C_0402_1005Metric
C20, C21, C22, C23, C24, C25, C85: 1uF; C_0603_1608Metric
C26: 0.1uF; C_0805_2012Metric
C27, C64: 10uF; CP_Elec_6.3x5.4
C28: 470pF; C_0603_1608Metric
C29: 10uF; C_0603_1608Metric
C30, C31, C37, C56: 10uF; C_0805_2012Metric
C38, C39: 15pF; C_0402_1005Metric
C40, C41, C82, C83, C84: 2.2uF; C_0603_1608Metric
C47, C48, C49: 22nF; C_0402_1005Metric
C54: 10uF; C_0402_1005Metric
C62: 10nF; C_1812_4532Metric
C71: 10nF; C_0402_1005Metric
C72, C74: 47uF; C_0805_2012Metric
C86, C87: 330pF; C_0402_1005Metric
D1: LTST-C190KGKT; D_0603_1608Metric
D2: B560C; D_SMC
D3: SM24CANB-02HTG; SOT-23
FB1, FB4, FB5, FB6: BLM18PG600; L_0603_1608Metric
H3, H4, H5, H6: MountingHole; MountingHole_2.2mm_M2
H7: SH_A; PinHeader_1x01_P2.54mm_Vertical
H8: SH_B; PinHeader_1x01_P2.54mm_Vertical
H9: SH_C; PinHeader_1x01_P2.54mm_Vertical
J1: FH41-40S-0.5SH_05_; Hirose_FH41-30S-0.5SH_1x30_1MP_1SH_P0.5mm_Horizontal
J2: Conn_01x02_Socket; PinHeader_1x02_P1.00mm_Vertical
J3: Conn_01x04_Socket; PinHeader_1x04_P1.00mm_Vertical
J4: TYPE-C-31-M-12; USB_C_Receptacle_HRO_TYPE-C-31-M-12
J5: Mounting holes; SAMTEC_UMPT-02-12.5-X-V-S-W-X
J6: Conn_01x03_Pin; PinHeader_1x03_P1.00mm_Vertical
L1: 8.2uH; L_Sunlord_MWSA0603S
Q1, Q2, Q5, Q6, Q9, Q10: ONSemi_SO-8FL_488AA
R1: 162K; R_0603_1608Metric
R2: 523K; R_0402_1005Metric
R3: 84R5; R_0603_1608Metric
R4: 13K; R_0402_1005Metric
R5, R24: 1k; R_0603_1608Metric
R6: 500uOhm; R_2512_6332Metric
R7: 510R; R_0603_1608Metric
R8: 1.5K; R_0402_1005Metric
R9: 4.87k, 1%; R_0603_1608Metric
R10, R22: 2.2K; R_0402_1005Metric
R11, R12, R13, R14: 5.1K; R_0402_1005Metric
R15, R16, R17, R18, R20, R21: 2.2R; R_0603_1608Metric
R23: 18K; R_0603_1608Metric
R25: 1M; R_0402_1005Metric
R26, R30, R31: 10k; R_0603_1608Metric
R27, R28, R29, R50, R51, R52: 3.3k; R_0603_1608Metric
R38: 53.6K; R_0603_1608Metric
R39: 10.2K; R_0402_1005Metric
R44, R47: 5.1k; R_0603_1608Metric
R45, R46: 22R; R_0402_1005Metric
R48, R49, R53: 22R; R_0603_1608Metric
R54: 120R; R_0402_1005Metric
R55, R56: 0; R_0603_1608Metric
RN1, RN2, RN3, RN4, RN5, RN6, RN7: 49R9; R_Array_SIP5
SW1: EVP-AA202K; SW_EVP-AA102K_PAN
TH1, TH2, TH3: 10k; R_0402_1005Metric
TP1, TP2, TP3, TP4: TESTPOINT; TestPoint_Pad_1.0x1.0mm
U1: DP83849IFVS_NOPB; QFP50P1400X1400X120-80N
U2: TPS54360DDAR; TI_SO-PowerPAD-8_ThermalVias
U3: LDL1117S33R; SOT-223
U4: NC7SZ125P5X; SOT-353_SC-70-5
U5: AS5047P-ATSM; SOP65P640X120-14N
U6: MCF8329A1IREER; WQFN36_REE_TEX
U7: LQFP-100-XMC4800
U8: SN65HVD231; SOIC-8_3.9x4.9mm_P1.27mm
Y1: 32.768 KHZ; Crystal_SMD_3215-2Pin_3.2x1.5mm
Y2: 12 MHz; Crystal_SMD_3225-4Pin_3.2x2.5mm

Connections:
5V: C41.1, C72.1, C74.1, L1.2, R38.1, TP3.1, U3.3 (VIN)
/BRAKE: U6.34 (BRAKE), U7.89 (P0.7)
/CAN_H: C88.1, D3.1 (A1), R55.1, U8.7 (CANH)
/CAN_L: C89.2, D3.2 (A2), R56.2, U8.6 (CANL)
/CAN_MODE: C87.2, R53.1, U7.69 (P1.14)
/CAN_RX: R49.1, U7.70 (P1.13)
/CAN_TX: R48.1, U7.71 (P1.12)
/DIR: U6.31 (DIR), U7.88 (P0.8)
/DRVOFF: U6.24 (DRVOFF), U7.72 (P1.11)
/ECAT0.P0_RXD3: RN3.5 (R4.2), U7.55 (P5.7)
/ECAT0.P0_RXDO: R10.2, U7.58 (P5.0)
/ECAT0.P0_TXD3: RN1.5 (R4.2), U7.77 (P1.2)
/ECAT0.P0_TX_ENA: U1.13 (TX_EN_A), U7.76 (P1.3)
/ECAT0.P1_RXD3: RN4.5 (R4.2), U7.21 (P14.14)
/ECAT0.P1_RX_DVA: U1.62 (RX_DV_B/MII_MODE_B), U7.20 (P14.15)
/ECAT0.P1_RX_ERRB: U1.60 (RX_ER_B/MDIX_EN_B), U7.19 (P15.2)
/ECAT0.P1_TXD1: RN2.5 (R4.2), U7.5 (P3.2)
/ECAT0.P1_TX_ENA: U1.49 (TX_EN_B), U7.7 (P3.0)
/ECAT0.PO_RX_DVA: U1.80 (RX_DV_A/MII_MODE_A), U7.80 (P1.9)
/ECAT0.PO__RX_CLK: RN5.5 (R4.2), U7.78 (P1.1)
/ECAT0_P0_RX_ERRB: U1.2 (RX_ER_A/MDIX_EN_A), U7.54 (P2.6)
/ECAT_RST: R26.1, U4.2 (A), U7.2 (P0.0)
/ETH0_CT1: C69.1, J1.24
/ETH0_RXN: J1.30, U1.23 (TPRDM_A)
/ETH0_RXP: J1.28, RN7.2 (R2.1), U1.24 (TPRDP_A)
/ETH0_TXN: J1.18, RN6.3 (R3.1), U1.26 (TPTDM_A), U1.36 (TPTDM_B)
/ETH0_TXP: J1.16, RN7.5 (R4.2), U1.27 (TPTDP_A)
/ETH1_CT1: C70.1, J1.22
/ETH1_RXN: J1.4, RN6.1 (R1.1), U1.39 (TPRDM_B)
/ETH1_RXP: J1.6, U1.38 (TPRDP_B)
/ETH1_TXP: RN6.4 (R4.1), U1.35 (TPTDP_B)
/ETH_PHY_CLK: U1.70 (X1), U7.85 (P4.0)
/Encoders/ENC_A: C47.1, R27.2
/Encoders/ENC_B: C48.1, R28.2
/Encoders/ENC_Z: C49.1, R29.2
/EtherCAT/COL_PHYAD0_A: R22.1, U1.3 (COL_A)
/EtherCAT/PFBOUT: C58.1, C59.1, C60.1, C61.1, C63.1, C64.1, U1.7 (PFBIN1), U1.28 (PFBIN2), U1.31 (PFBOUT), U1.34 (PFBIN3), U1.54 (PFBIN4)
/EtherCAT/PHY_RST: R30.1, U1.71 (RESET_N), U4.4 (Y)
/EtherCAT/VCCTXRX: C66.1, C67.1, C68.1, FB1.1, RN6.2 (R2.1), RN6.5 (R4.2), RN7.1 (R1.1), RN7.3 (R3.1), RN7.4 (R4.1)
/I2C_SCL: R13.2, U6.30 (SCL), U7.48 (P2.4)
/I2C_SDA: R12.2, U6.29 (SDA), U7.47 (P2.5)
/MCU/RTC_XTAL1: C39.1, U7.16 (RTC_XTAL1), Y1.2
/MCU/RTC_XTAL2: C38.1, U7.15 (RTC_XTAL2), Y1.1
/MCU/VAREF: C57.1, FB5.1, U7.33 (VAREF)
/MCU/VDDA: C55.1, FB6.1, U7.35 (VDDA)
/MCU/XTAL1: U7.61 (XTAL1), Y2.1
/MCU/XTAL2: R7.2, U7.62 (XTAL2)
/MDC: U1.67 (MDC), U7.93 (P3.3)
/MDIO: R8.2, U1.66 (MDIO), U7.94 (P0.12)
/Motor/DVDD: C24.2, U6.1 (DGND), U6.36 (DVDD)
/Motor/GH_A: R15.2, U6.11 (GHA)
/Motor/GH_B: R18.2, U6.15 (GHB)
/Motor/GH_C: R20.2, U6.19 (GHC)
/Motor/GL_A: R16.1, U6.12 (GLA)
/Motor/GL_B: R17.2, U6.16 (GLB)
/Motor/GL_C: R21.1, U6.20 (GLC)
/Motor/SENSE_P: Q2.1 (S), Q2.2 (S), Q2.3 (S), Q6.1 (S), Q6.2 (S), Q6.3 (S), Q10.1 (S), Q10.2 (S), Q10.3 (S), R6.1, U6.21 (LSS), U6.22 (SP)
/NFAULT: R14.2, U6.35 (NFAULT), U7.30 (P14.1)
/POWERDOWN_A: U1.18 (PWRDOWN_INT_A), U7.46 (P2.8)
/POWERDOWN_B: U1.44 (PWRDOWN_INT_B), U7.45 (P2.9)
/Power/Regulators/FB: R38.2, R39.1, U2.5 (FB)
/RESET: C71.1, R31.2, SW1.1, U7.65 (PORST#)
/SH_A: C21.1, H7.1, Q1.1 (S), Q1.2 (S), Q1.3 (S), Q2.5 (D), U6.10 (SHA)
/SH_B: C22.1, H9.1, Q5.1 (S), Q5.2 (S), Q5.3 (S), Q6.5 (D), U6.14 (SHB)
/SH_C: C23.1, H8.1, Q9.1 (S), Q9.2 (S), Q9.3 (S), Q10.5 (D), U6.18 (SHC)
/SPI1_CS: U5.1 (CSN), U7.84 (P4.1)
/SPI1_MISO: U5.3 (MISO), U7.92 (P3.4)
/SPI1_MOSI: U5.4 (MOSI), U7.91 (P3.5)
/SPI1_SCK: U5.2 (CLK), U7.90 (P3.6)
/SPI_CS: J3.1, U7.96 (P0.6)
/SPI_MISO: J3.3, U7.98 (P0.4)
/SPI_MOSI: J3.4, U7.97 (P0.5)
/SPI_SCK: J3.2, U7.95 (P0.11)
/SWV: J6.3, U7.51 (P2.1)
/TCK: J6.2, U7.67 (TCK)
/TEMP_BACKSIDE: C84.1, R52.1, TH3.2, U7.28 (P14.3)
/TEMP_ICS: C83.1, R51.1, TH2.2, U7.27 (P14.4)
/TEMP_MOSFETS: C82.1, R50.1, TH1.2, U7.29 (P14.2)
/TMS: J6.1, U7.66 (TMS)
/UART_RX: J2.2, U7.40 (P2.15)
/UART_TX: J2.1, U7.41 (P2.14)
/USB_D+: J4.A6 (DP1), R46.2, U7.9 (USB_DP)
/USB_D-: J4.A7 (DN1), R45.2, U7.8 (USB_DM)
/VBUS_SENSE: C40.1, R23.2, R24.1, TP4.1, U7.31 (P14.0)
/WAKE: U6.27 (SPEED/_WAKE), U7.73 (P1.10)
AVCC: C19.1, C20.1, C25.2, C42.1, R11.1, R12.1, R13.1, R14.1, R27.1, R28.1, R29.1, TH1.1, TH2.1, TH3.1, U5.11 (VDD), U5.12 (VDD3V3), U6.2 (VREG), U6.26 (AVDD)
DCBUS: C1.1, C2.1, C3.1, C4.1, C5.1, C6.1, C7.1, C8.1, C9.1, C10.1, C12.1, C26.1, C27.1, Q1.5 (D), Q5.5 (D), Q9.5 (D), R2.1, R23.1, TP1.1, U2.2 (VIN), U6.5 (PVDD)
GND: C1.2, C2.2, C3.2, C4.2, C5.2, C6.2, C7.2, C8.2, C9.2, C10.2, C11.2, C12.2, C13.2, C15.2, C16.2, C17.2, C18.2, C19.2, C20.2, C24.1, C25.1, C26.2, C27.2, C29.1, C30.2, C31.2, C32.2, C33.2, C34.2, C35.2, C36.2, C37.2, C38.2, C39.2, C40.2, C41.2, C42.2, C43.2, C44.2, C45.2, C46.2, C47.2, C48.2, C49.2, C50.2, C51.2, C52.2, C53.2, C54.2, C55.2, C56.2, C57.2, C58.2, C59.2, C60.2, C61.2, C63.2, C64.2, C65.2, C66.2, C67.2, C68.2, C69.2, C70.2, C71.2, C72.2, C74.2, C82.2, C83.2, C84.2, C85.1, C86.1, C87.1, C88.2, C89.1, D2.2 (A), D3.3 (common), J1.1, J1.2, J1.3, J1.5, J1.7, J1.8, J1.9, J1.10, J1.11, J1.12, J1.13, J1.14, J1.15, J1.17, J1.19, J1.20, J1.21, J1.23, J1.25, J1.26, J1.27, J1.29, R1.2, R3.2, R5.2, R6.2, R9.1, R22.2, R24.2, R25.2, R26.2, R30.2, R39.2, R44.2, R47.2, R50.2, R51.2, R52.2, SW1.3, U1.6 (COREGND1), U1.10 (IOGND1), U1.22 (ANAGND1), U1.25 (CDGND1), U1.29 (ANAGND2), U1.33 (ANAGND3), U1.37 (CDGND2), U1.40 (ANAGND4), U1.52 (IOGND2), U1.55 (COREGND2), U1.64 (IOGND3), U1.77 (IOGND4), U2.3 (EN), U2.7 (GND), U2.9 (GNDPAD), U3.1 (GND), U4.1 (~OE), U4.3 (GND), U5.5 (TEST), U5.13 (GND), U6.4 (GND), U6.23 (SN), U6.25 (AGND), U6.37 (epad), U7.32 (VAGND), U7.34 (VSSA), U7.59 (VSS), U7.63 (VSSO), U7.101 (EP), U8.2 (GND), Y2.2, Y2.4
unnamed: C15.1, R4.2
unnamed: C62.1, R25.1
unnamed: D1.2, R5.1, TP2.1
unnamed: C14.2, D2.1 (K), L1.1, U2.8 (SW)
unnamed: J4.A5 (CC1), R44.1
unnamed: J4.B5 (CC2), R47.1
unnamed: J4.B7 (DN2), R45.1
unnamed: J4.B6 (DP2), R46.1
unnamed: Q1.4 (G), R15.1
unnamed: Q2.4 (G), R16.2
unnamed: Q5.4 (G), R18.1
unnamed: Q6.4 (G), R17.1
unnamed: Q9.4 (G), R20.1
unnamed: Q10.4 (G), R21.2
unnamed: R2.2, R3.1
unnamed: R7.1, Y2.3
unnamed: R54.1, R56.1
unnamed: R54.2, R55.2
unnamed: RN1.1 (R1.1), U1.14 (TXD0_A)
unnamed: RN1.2 (R2.1), U1.15 (TXD1_A)
unnamed: RN1.3 (R3.1), U1.16 (TXD2_A)
unnamed: RN1.4 (R4.1), U1.17 (TXD3_A/SNI_MODE_A)
unnamed: RN2.1 (R1.1), U1.45 (TXD3_B/SNI_MODE_B)
unnamed: RN2.2 (R2.1), U1.46 (TXD2_B)
unnamed: RN2.3 (R3.1), U1.48 (TXD0_B)
unnamed: RN2.4 (R4.1), U1.47 (TXD1_B)
unnamed: RN3.1 (R1.1), U1.4 (RXD0_A/PHYAD1)
unnamed: RN3.2 (R2.1), U1.5 (RXD1_A/PHYAD2)
unnamed: RN3.3 (R3.1), U1.8 (RXD2_A/CLK2MAC_DIS)
unnamed: RN3.4 (R4.1), U1.9 (RXD3_A/ED_EN_A)
unnamed: RN4.1 (R1.1), U1.58 (RXD0_B/PHYAD3)
unnamed: RN4.2 (R2.1), U1.57 (RXD1_B/PHYAD4)
unnamed: RN4.3 (R3.1), U1.56 (RXD2_B)
unnamed: RN4.4 (R4.1), U1.53 (RXD3_B/ED_EN_B)
unnamed: RN5.1 (R1.1), U1.12 (TX_CLK_A)
unnamed: RN5.2 (R2.1), U1.50 (TX_CLK_B)
unnamed: RN5.3 (R3.1), U1.63 (RX_CLK_B)
unnamed: RN5.4 (R4.1), U1.79 (RX_CLK_A)
unnamed: R9.2, U1.32 (RBIAS)
unnamed: C14.1, U2.1 (BOOT)
unnamed: C18.1, R4.1, U2.6 (COMP)
unnamed: R1.1, U2.4 (RT/CLK)
unnamed: C21.2, U6.9 (BSTA)
unnamed: C22.2, U6.13 (BSTB)
unnamed: C23.2, U6.17 (BSTC)
unnamed: C28.2, U6.7 (CPH)
unnamed: C28.1, U6.6 (CPL)
unnamed: R11.2, U6.28 (FG)
unnamed: C29.2, U6.8 (GVDD)
unnamed: FB4.2, U7.10 (VBUS)
unnamed: R48.2, U8.1 (D)
unnamed: R49.2, U8.4 (R)
unnamed: R53.2, U8.8 (Rs)
SHIELD: C62.2, J4.S1 (SHIELD)
VCC: C11.1, C13.1, C16.1, C17.1, C30.1, C31.1, C32.1, C33.1, C34.1, C35.1, C36.1, C37.1, C43.1, C44.1, C45.1, C46.1, C56.1, C65.1, C85.2, C86.2, D1.1, FB1.2, FB5.2, FB6.2, R8.1, R10.1, R31.1, U1.11 (IOVDD1), U1.30 (ANA33VDD), U1.51 (IOVDD2), U1.65 (IOVDD3), U1.78 (IOVDD4), U3.2 (VOUT), U3.4 (VOUT), U4.5 (VCC), U7.11 (VDDP), U7.12 (VDDC), U7.17 (VBAT), U7.43 (VDDP), U7.60 (VDDP), U7.87 (VDDP), U8.3 (VCC)
VDDC: C50.1, C51.1, C52.1, C53.1, C54.1, U7.42 (VDDC), U7.64 (VDDC), U7.86 (VDDC)
