kscalelabs/motor-controller/ControllerV4/ControllerV4.kicad_pcb

## KiCad design ControllerV4/ControllerV4.kicad_pcb (2024-06-26)

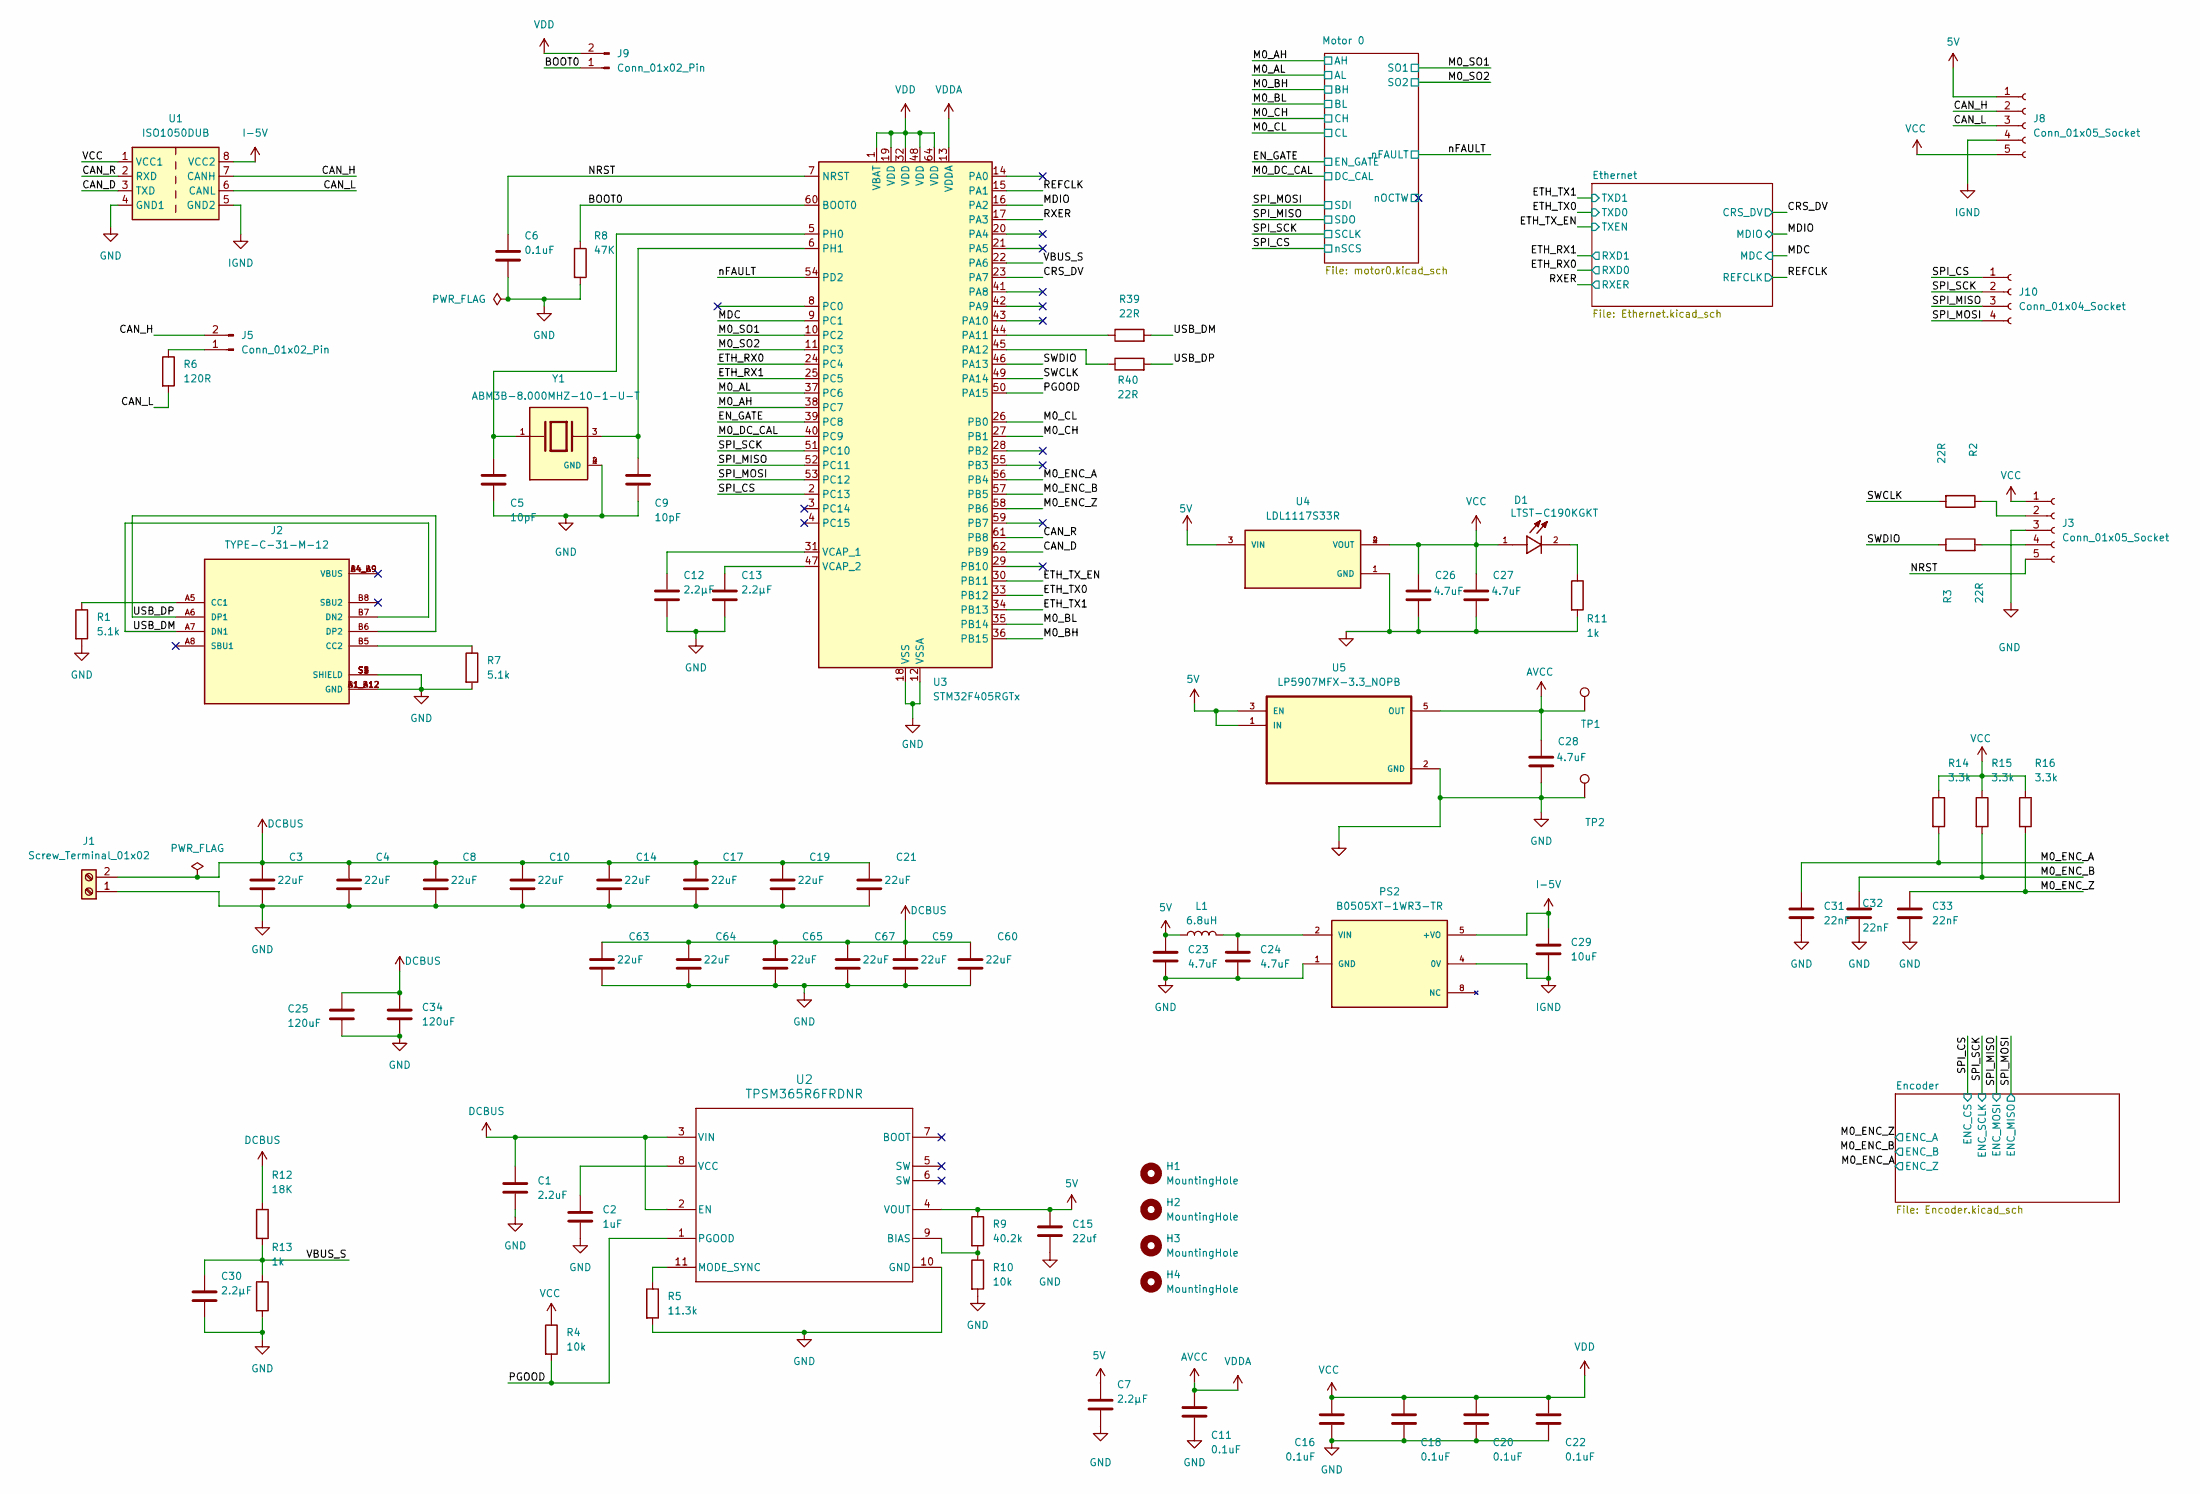
[picture p29: schematic ControllerV4.kicad_sch]

Parts:
C1: 2.2uF; C_1210_3225Metric
C2: 1uF; C_0603_1608Metric
C3, C4, C8, C10, C14, C17, C19, C21, C59, C60, C63, C64, C65, C67: 470uF; C_2220_5750Metric; TOLERANCE ±20%; PART STATUS Active
C5, C9: 10pF; C_0603_1608Metric; TOLERANCE ±5%; VOLTAGE - RATED 50V; MANUFACTURER PART NUMBER GRM1885C1H100JA01D
C6, C11, C16, C18, C20, C22: 0.1uF; C_0603_1608Metric; TOLERANCE ±10%; VOLTAGE - RATED 50V; MANUFACTURER PART NUMBER GRM188R71H104KA93D
C7, C12, C13, C30: 2.2µF; C_0603_1608Metric; TOLERANCE ±10%; VOLTAGE - RATED 16V; MANUFACTURER PART NUMBER GRM188R61C225KE15D
C15: 22uf; C_2225_5664Metric
C23, C24: 4.7uF; C_0402_1005Metric
C25, C34: 120uF; CP_Elec_10x10.5
C26, C27, C28: 4.7uF; C_0805_2012Metric; TOLERANCE ±10%; VOLTAGE - RATED 35V; PART STATUS Active
C29: 10uF; C_0402_1005Metric
C31, C32, C33: 22nF; C_0402_1005Metric
D1: LTST-C190KGKT; D_0603_1608Metric
H1, H2, H3, H4: MountingHole; MountingHole_2.2mm_M2
J1: Screw_Terminal_01x02; Two-Hole
J2: TYPE-C-31-M-12; HRO_TYPE-C-31-M-12; PARTREV 2020.12.08
J3, J8: Conn_01x05_Socket; Five-Hole
J5, J9: Conn_01x02_Pin; PinHeader_1x02_P2.54mm_Vertical
J10: Conn_01x04_Socket; Nine-Hole
L1: 6.8uH; L_0805_2012Metric
PS2: B0505XT-1WR3-TR; CONV_B0505XT-1WR3-TR; PARTREV 2019.10.18-A/4
R1, R7: 5.1k; R_0603_1608Metric
R2, R3: 22R; R_0603_1608Metric; TOLERANCE ±1%; MANUFACTURER PART NUMBER RC0603FR-0722RL
R4, R10: 10k; R_0603_1608Metric
R5: 11.3k; R_0603_1608Metric
R6: 120R; R_0603_1608Metric
R8: 47K; R_0603_1608Metric; TOLERANCE ±1%; MANUFACTURER PART NUMBER RC0603FR-0747KL
R9: 40.2k; R_0603_1608Metric
R11, R13: 1k; R_0603_1608Metric; TOLERANCE ±1%; MANUFACTURER PART NUMBER RC0603FR-071KL
R12: 18K; R_0603_1608Metric; TOLERANCE ±1%; MANUFACTURER PART NUMBER RC0603FR-0710KL
R14, R15, R16: 3.3k; R_0603_1608Metric; TOLERANCE ±1%; MANUFACTURER PART NUMBER RC0603FR-073K3L
R39, R40: 22R; R_0402_1005Metric
TP1, TP2: TESTPOINT; TestPoint_Pad_1.0x1.0mm
U1: ISO1050DUB; SOP-8_6.62x9.15mm_P2.54mm
U2: TPSM365R6FRDNR; RDN0011A-MFG
U3: STM32F405RGTx; LQFP-64_10x10mm_P0.5mm
U4: LDL1117S33R; SOT-223; PARTREV 7
U5: LP5907MFX-3.3_NOPB; SOT-23-5
Y1: ABM3B-8.000MHZ-10-1-U-T; Crystal_SMD_5032-4Pin_5.0x3.2mm; PARTREV 08.25.15

Connections:
5V: C7.1, C15.1, C23.1, J8.1, L1.1, R9.1, U2.4 (VOUT), U4.3 (VIN), U5.1 (IN), U5.3 (EN); also elsewhere on the board
/BOOT0: J9.1, R8.1, U3.60 (BOOT0)
/CAN_D: U1.3 (TXD), U3.62 (PB9)
/CAN_H: J5.2, J8.2, U1.7 (CANH)
/CAN_L: J8.3, R6.2, U1.6 (CANL)
/CAN_R: U1.2 (RXD), U3.61 (PB8)
/CRS_DV: U3.23 (PA7); also elsewhere on the board
/EN_GATE: U3.39 (PC8); also elsewhere on the board
/ETH_RX0: U3.24 (PC4); also elsewhere on the board
/ETH_RX1: U3.25 (PC5); also elsewhere on the board
/ETH_TX0: U3.33 (PB12); also elsewhere on the board
/ETH_TX1: U3.34 (PB13); also elsewhere on the board
/ETH_TX_EN: U3.30 (PB11); also elsewhere on the board
/M0_AH: U3.38 (PC7); also elsewhere on the board
/M0_AL: U3.37 (PC6); also elsewhere on the board
/M0_BH: U3.36 (PB15); also elsewhere on the board
/M0_BL: U3.35 (PB14); also elsewhere on the board
/M0_CH: U3.27 (PB1); also elsewhere on the board
/M0_CL: U3.26 (PB0); also elsewhere on the board
/M0_DC_CAL: U3.40 (PC9); also elsewhere on the board
/M0_ENC_A: C31.1, R14.2, U3.56 (PB4); also elsewhere on the board
/M0_ENC_B: C32.1, R15.2, U3.57 (PB5); also elsewhere on the board
/M0_ENC_Z: C33.1, R16.2, U3.58 (PB6); also elsewhere on the board
/M0_SO1: U3.10 (PC2); also elsewhere on the board
/M0_SO2: U3.11 (PC3); also elsewhere on the board
/MDC: U3.9 (PC1); also elsewhere on the board
/MDIO: U3.16 (PA2); also elsewhere on the board
/NRST: C6.1, J3.5, U3.7 (NRST)
/PGOOD: R4.2, U2.1 (PGOOD), U3.50 (PA15)
/REFCLK: U3.15 (PA1); also elsewhere on the board
/RXER: U3.17 (PA3); also elsewhere on the board
/SPI_CS: J10.1, U3.2 (PC13); also elsewhere on the board
/SPI_MISO: J10.3, U3.52 (PC11); also elsewhere on the board
/SPI_MOSI: J10.4, U3.53 (PC12); also elsewhere on the board
/SPI_SCK: J10.2, U3.51 (PC10); also elsewhere on the board
/SWCLK: R2.2, U3.49 (PA14)
/SWDIO: R3.1, U3.46 (PA13)
/USB_DM: J2.A7 (DN1), J2.B7 (DN2), R39.2
/USB_DP: J2.A6 (DP1), J2.B6 (DP2), R40.2
/VBUS_S: C30.1, R12.2, R13.1, U3.22 (PA6)
/nFAULT: U3.54 (PD2); also elsewhere on the board
AVCC: C11.1, C28.1, TP1.1, U3.13 (VDDA), U5.5 (OUT); also elsewhere on the board
DCBUS: C1.1, C3.1, C4.1, C8.1, C10.1, C14.1, C17.1, C19.1, C21.1, C25.1, C34.1, C59.1, C60.1, C63.1, C64.1, C65.1, C67.1, J1.2, R12.1, U2.2 (EN), U2.3 (VIN); also elsewhere on the board
GND: C1.2, C2.2, C3.2, C4.2, C5.2, C6.2, C7.2, C8.2, C9.2, C10.2, C11.2, C12.2, C13.2, C14.2, C15.2, C16.2, C17.2, C18.2, C19.2, C20.2, C21.2, C22.2, C23.2, C24.2, C25.2, C26.2, C27.2, C28.2, C30.2, C31.2, C32.2, C33.2, C34.2, C59.2, C60.2, C63.2, C64.2, C65.2, C67.2, J1.1, J2.A1_B12 (GND), J2.B1_A12 (GND), J2.S1 (SHIELD), J2.S2 (SHIELD), J2.S3 (SHIELD), J2.S4 (SHIELD), J3.3, PS2.1 (GND), R1.2, R5.2, R7.2, R8.2, R10.2, R11.2, R13.2, TP2.1, U1.4 (GND1), U2.10 (GND), U3.12 (VSSA), U3.18 (VSS), U3.63 (VSS), U4.1 (GND), U5.2 (GND), Y1.2 (GND), Y1.4 (GND); also elsewhere on the board
I-5V: C29.1, PS2.5 (+VO), U1.8 (VCC2)
IGND: C29.2, J8.4, PS2.4 (0V), U1.5 (GND2)
unnamed: D1.2, R11.1
unnamed: J2.A5 (CC1), R1.1
unnamed: J2.B5 (CC2), R7.1
unnamed: J3.2, R2.1
unnamed: J3.4, R3.2
unnamed: J5.1, R6.1
unnamed: C24.1, L1.2, PS2.2 (VIN)
unnamed: R9.2, R10.1, U2.9 (BIAS)
unnamed: R5.1, U2.11 (MODE_SYNC)
unnamed: C2.1, U2.8 (VCC)
unnamed: R39.1, U3.44 (PA11)
unnamed: R40.1, U3.45 (PA12)
unnamed: C5.1, U3.5 (PH0), Y1.1
unnamed: C9.1, U3.6 (PH1), Y1.3
unnamed: C12.1, U3.31 (VCAP_1)
unnamed: C13.1, U3.47 (VCAP_2)
VCC: C16.1, C18.1, C20.1, C22.1, C26.1, C27.1, D1.1, J3.1, J8.5, J9.2, R4.1, R14.1, R15.1, R16.1, U1.1 (VCC1), U3.1 (VBAT), U3.19 (VDD), U3.32 (VDD), U3.48 (VDD), U3.64 (VDD), U4.2 (VOUT), U4.4 (VOUT); also elsewhere on the board

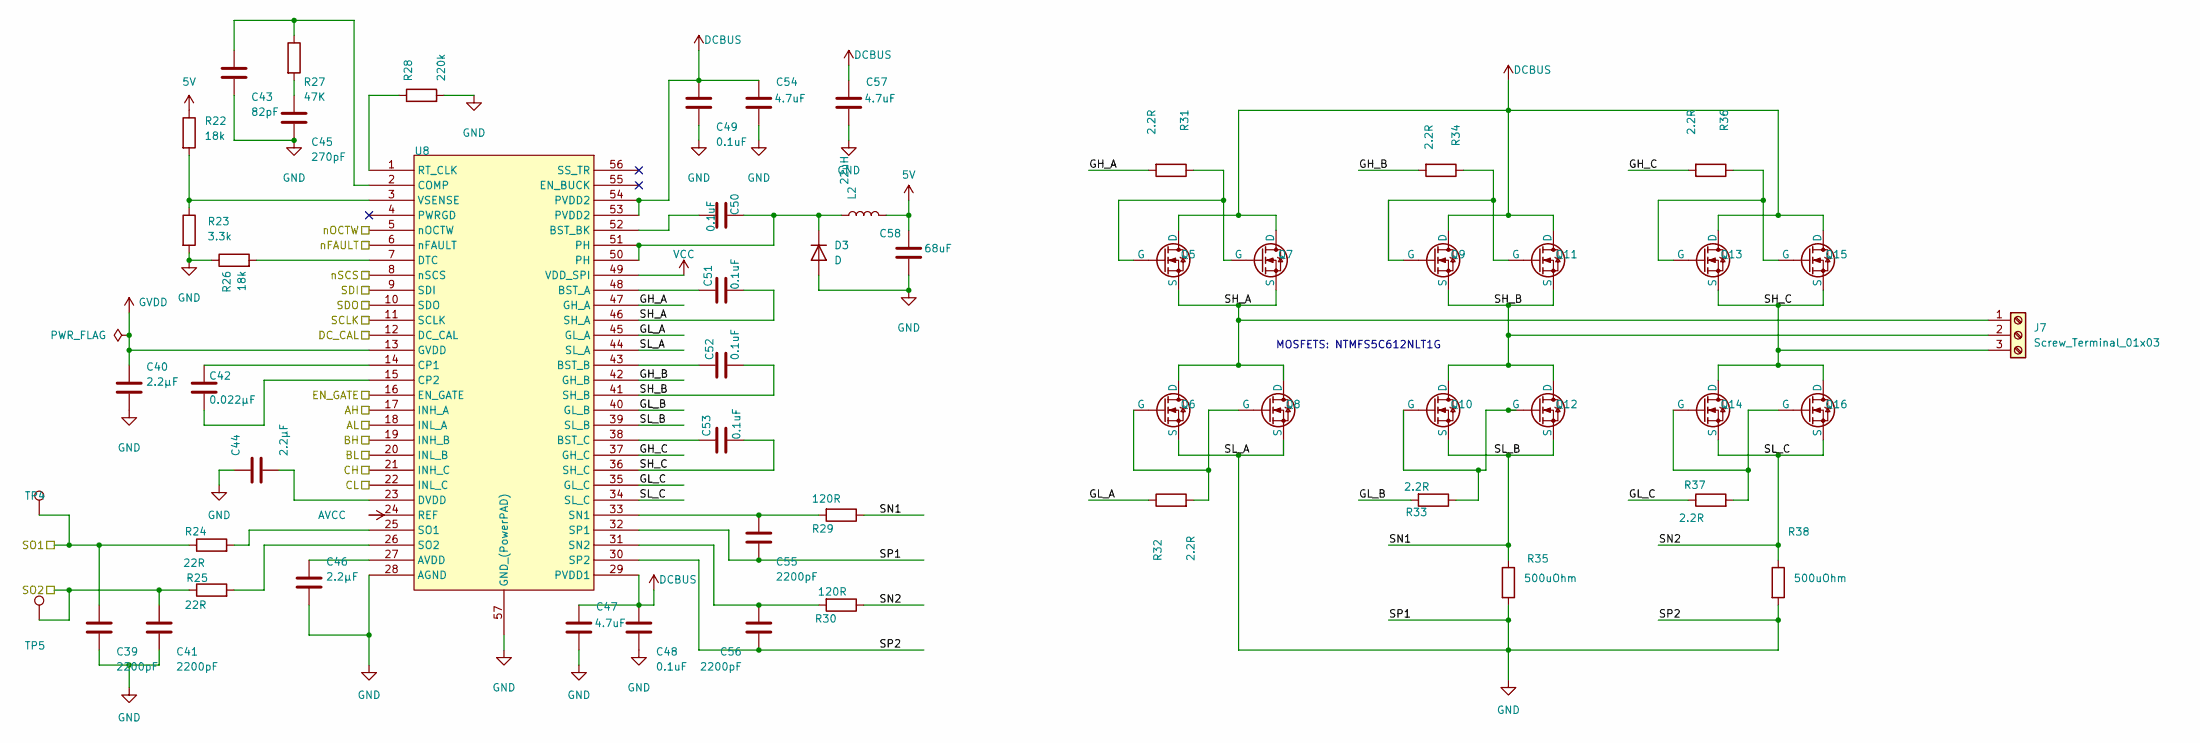
[picture p30: schematic motor0.kicad_sch]

Parts:
C39, C41, C55, C56: 2200pF; C_0603_1608Metric; TOLERANCE ±5%; VOLTAGE - RATED 50V; PART STATUS Active
C40, C44, C46: 2.2µF; C_0603_1608Metric; TOLERANCE ±10%; VOLTAGE - RATED 16V; MANUFACTURER PART NUMBER GRM188R61C225KE15D
C42: 0.022µF; C_0603_1608Metric; TOLERANCE ±10%; VOLTAGE - RATED 50V; MANUFACTURER PART NUMBER GRM188R71H223KA01D
C43: 82pF; C_0603_1608Metric; TOLERANCE ±5%; VOLTAGE - RATED 100V; MANUFACTURER PART NUMBER GRM1885C2A820JA01D
C45: 270pF; C_0603_1608Metric; TOLERANCE ±5%; VOLTAGE - RATED 50V; MANUFACTURER PART NUMBER GRM1885C1H271JA01D
C47, C54, C57: 4.7uF; C_0805_2012Metric; TOLERANCE ±10%; VOLTAGE - RATED 35V; PART STATUS Active
C48, C49, C50, C51, C52, C53: 0.1uF; C_0603_1608Metric; TOLERANCE ±10%; VOLTAGE - RATED 50V; MANUFACTURER PART NUMBER GRM188R71H104KA93D
C58: 68uF; CP_EIA-6032-28_Kemet-C; TOLERANCE ±20%; PART STATUS Active
D3: D; D_SOD-123F
J7: Screw_Terminal_01x03; Three-Hole
L2: 22uH; L_Taiyo-Yuden_NR-60xx
Q5, Q6, Q7, Q8, Q9, Q10, Q11, Q12, Q13, Q14, Q15, Q16: ONSemi_SO-8FL_488AA; DRIVE VOLTAGE (MAX RDS 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 4.5V, 10V; PART STATUS Active
R22, R26: 18k; R_0603_1608Metric; TOLERANCE ±1%; MANUFACTURER PART NUMBER RC0603FR-0718KL
R23: 3.3k; R_0603_1608Metric; TOLERANCE ±1%; MANUFACTURER PART NUMBER RC0603FR-073K3L
R24, R25: 22R; R_0603_1608Metric; TOLERANCE ±1%; MANUFACTURER PART NUMBER RC0603FR-0722RL
R27: 47K; R_0603_1608Metric; TOLERANCE ±1%; MANUFACTURER PART NUMBER RC0603FR-0747KL
R28: 220k; R_0603_1608Metric; TOLERANCE ±1%; MANUFACTURER PART NUMBER RC0603FR-07220KL
R29, R30: 120R; R_0603_1608Metric; TOLERANCE ±1%; MANUFACTURER PART NUMBER RC0603FR-07120RL
R31, R32, R33, R34, R36, R37: 2.2R; R_0603_1608Metric; TOLERANCE ±1%; MANUFACTURER PART NUMBER RC0603FR-072R2L
R35, R38: 500uOhm; R_2512_6332Metric; TOLERANCE ±1%; PART STATUS Active
TP4, TP5: TESTPOINT; TestPoint_Pad_1.0x1.0mm
U8: HTSSOP-56-1EP_6.1x14mm_P0.5mm_EP3.61x6.35mm

Connections:
5V: C58.1, L2.2, R22.1; also elsewhere on the board
/EN_GATE: U8.16 (EN_GATE); also elsewhere on the board
/M0_AH: U8.17 (INH_A); also elsewhere on the board
/M0_AL: U8.18 (INL_A); also elsewhere on the board
/M0_BH: U8.19 (INH_B); also elsewhere on the board
/M0_BL: U8.20 (INL_B); also elsewhere on the board
/M0_CH: U8.21 (INH_C); also elsewhere on the board
/M0_CL: U8.22 (INL_C); also elsewhere on the board
/M0_DC_CAL: U8.12 (DC_CAL); also elsewhere on the board
/M0_SO1: C39.1, R24.1, TP4.1; also elsewhere on the board
/M0_SO2: C41.1, R25.1, TP5.1; also elsewhere on the board
/Motor 0/GH_A: R31.2, U8.47 (GH_A)
/Motor 0/GH_B: R34.2, U8.42 (GH_B)
/Motor 0/GH_C: R36.2, U8.37 (GH_C)
/Motor 0/GL_A: R32.1, U8.45 (GL_A)
/Motor 0/GL_B: R33.2, U8.40 (GL_B)
/Motor 0/GL_C: R37.1, U8.35 (GL_C)
/Motor 0/SH_A: C51.2, J7.1, Q5.1 (S), Q6.5 (D), Q7.1 (S), Q8.5 (D), U8.46 (SH_A)
/Motor 0/SH_B: C52.2, J7.2, Q9.1 (S), Q10.5 (D), Q11.1 (S), Q12.5 (D), U8.41 (SH_B)
/Motor 0/SH_C: C53.2, J7.3, Q13.1 (S), Q14.5 (D), Q15.1 (S), Q16.5 (D), U8.36 (SH_C)
/Motor 0/SL_B: Q10.1 (S), Q12.1 (S), R29.1, R35.1, U8.39 (SL_B)
/Motor 0/SL_C: Q14.1 (S), Q16.1 (S), R30.1, R38.1, U8.34 (SL_C)
/Motor 0/nOCTW: U8.5 (nOCTW)
/SPI_CS: U8.8 (nSCS); also elsewhere on the board
/SPI_MISO: U8.10 (SDO); also elsewhere on the board
/SPI_MOSI: U8.9 (SDI); also elsewhere on the board
/SPI_SCK: U8.11 (SCLK); also elsewhere on the board
/nFAULT: U8.6 (nFAULT); also elsewhere on the board
AVCC: U8.24 (REF); also elsewhere on the board
DCBUS: C47.1, C48.1, C49.1, C54.1, C57.1, Q5.5 (D), Q7.5 (D), Q9.5 (D), Q11.5 (D), Q13.5 (D), Q15.5 (D), U8.29 (PVDD1), U8.53 (PVDD2), U8.54 (PVDD2); also elsewhere on the board
GND: C39.2, C40.2, C41.2, C43.2, C44.1, C45.2, C46.2, C47.2, C48.2, C49.2, C54.2, C55.2, C56.2, C57.2, C58.2, D3.2 (A), Q6.1 (S), Q8.1 (S), R23.2, R26.1, R28.2, R35.2, R38.2, U8.28 (AGND), U8.30 (SP2), U8.32 (SP1), U8.44 (SL_A), U8.57 (GND_(PowerPAD)); also elsewhere on the board
GVDD: C40.1, U8.13 (GVDD)
unnamed: C45.1, R27.2
unnamed: C50.1, D3.1 (K), L2.1, U8.50 (PH), U8.51 (PH)
unnamed: Q5.4 (G), Q7.4 (G), R31.1
unnamed: Q6.4 (G), Q8.4 (G), R32.2
unnamed: Q10.4 (G), Q12.4 (G), R33.1
unnamed: Q9.4 (G), Q11.4 (G), R34.1
unnamed: Q13.4 (G), Q15.4 (G), R36.1
unnamed: Q14.4 (G), Q16.4 (G), R37.2
unnamed: C46.1, U8.27 (AVDD)
unnamed: C51.1, U8.48 (BST_A)
unnamed: C52.1, U8.43 (BST_B)
unnamed: C50.2, U8.52 (BST_BK)
unnamed: C53.1, U8.38 (BST_C)
unnamed: C43.1, R27.1, U8.2 (COMP)
unnamed: C42.1, U8.14 (CP1)
unnamed: C42.2, U8.15 (CP2)
unnamed: R26.2, U8.7 (DTC)
unnamed: C44.2, U8.23 (DVDD)
unnamed: R28.1, U8.1 (RT_CLK)
unnamed: C55.1, R29.2, U8.33 (SN1)
unnamed: C56.1, R30.2, U8.31 (SN2)
unnamed: R24.2, U8.25 (SO1)
unnamed: R25.2, U8.26 (SO2)
unnamed: R22.2, R23.1, U8.3 (VSENSE)
VCC: U8.49 (VDD_SPI); also elsewhere on the board

Notes on the sheet:
MOSFETS: NTMFS5C612NLT1G

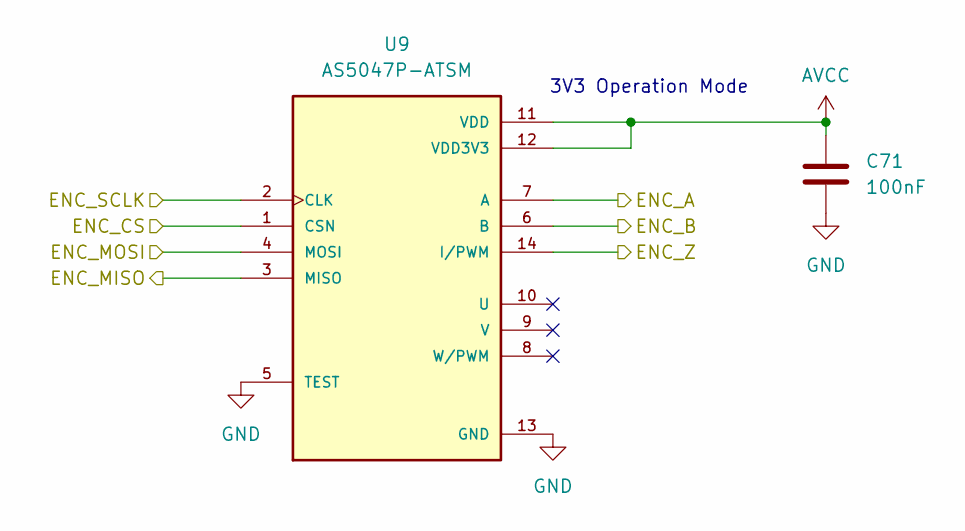
[picture p31: schematic Encoder.kicad_sch]

Parts:
C71: 100nF; C_0402_1005Metric
U9: AS5047P-ATSM; SOP65P640X120-14N; PARTREV 1-01

Connections:
/M0_ENC_A: U9.14 (I/PWM); also elsewhere on the board
/M0_ENC_B: U9.6 (B); also elsewhere on the board
/M0_ENC_Z: U9.7 (A); also elsewhere on the board
/SPI_CS: U9.1 (CSN); also elsewhere on the board
/SPI_MISO: U9.4 (MOSI); also elsewhere on the board
/SPI_MOSI: U9.3 (MISO); also elsewhere on the board
/SPI_SCK: U9.2 (CLK); also elsewhere on the board
AVCC: C71.1, U9.11 (VDD), U9.12 (VDD3V3); also elsewhere on the board
GND: C71.2, U9.5 (TEST), U9.13 (GND); also elsewhere on the board

Notes on the sheet:
3V3 Operation Mode

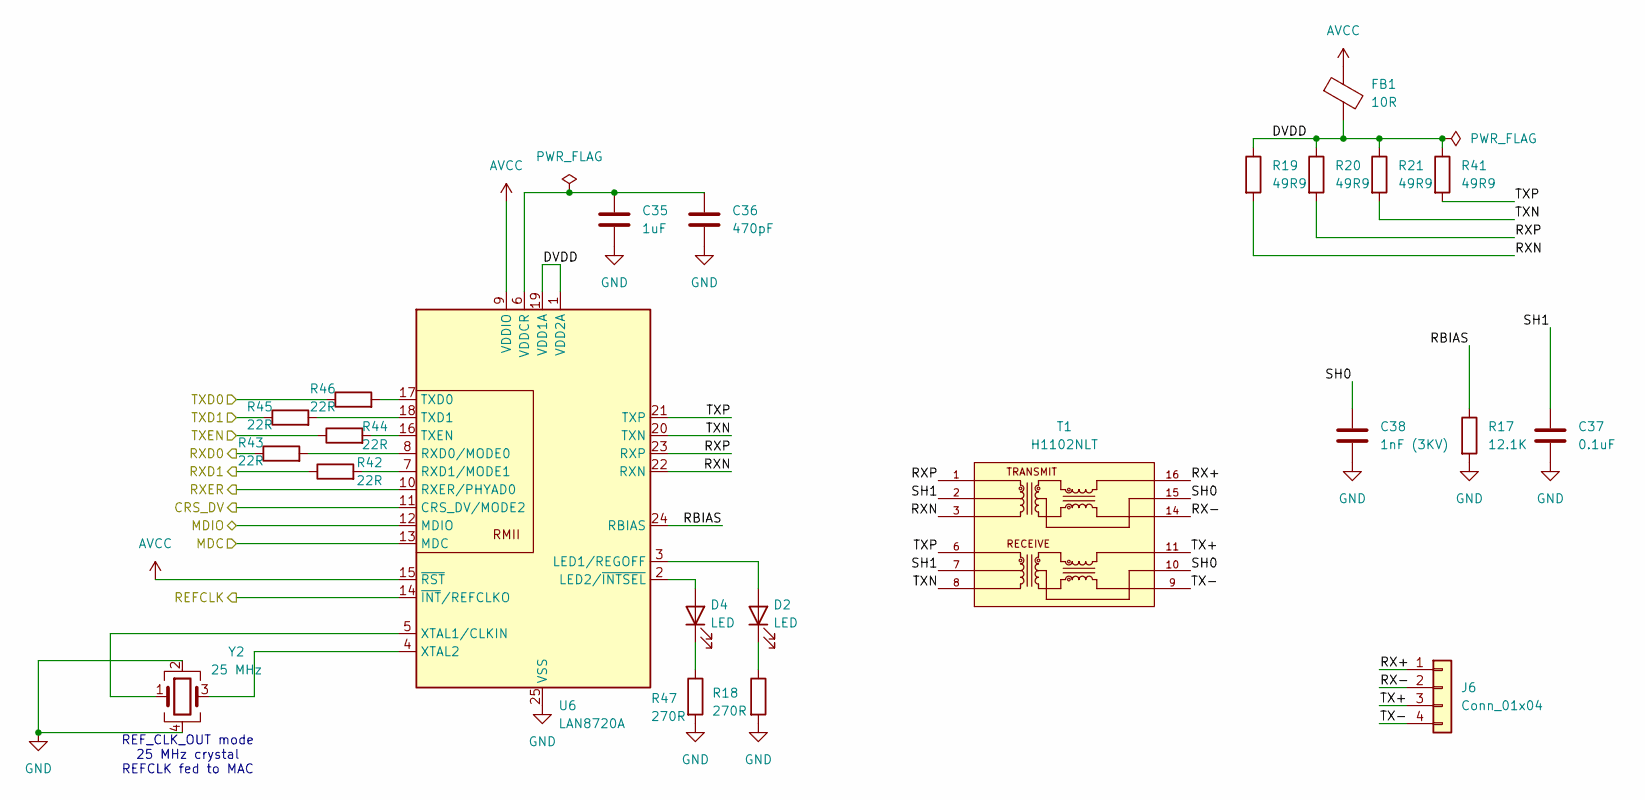
[picture p32: schematic Ethernet.kicad_sch]

Parts:
C35: 1uF; C_0402_1005Metric
C36: 470pF; C_0402_1005Metric
C37: 0.1uF; C_0402_1005Metric
C38: 1nF (3KV); C_1206_3216Metric
D2, D4: LED; D_0603_1608Metric
FB1: 10R; L_0402_1005Metric
J6: Conn_01x04; Molex_PicoBlade_53048-0410_1x04_P1.25mm_Horizontal
R17: 12.1K; R_0402_1005Metric
R18, R47: 270R; R_0402_1005Metric
R19, R20, R21, R41: 49R9; R_0402_1005Metric
R42, R43, R44, R45, R46: 22R; R_0402_1005Metric
T1: H1102NLT; XFMR_H1102NLT; PARTREV NA
U6: LAN8720A; VQFN-24-1EP_4x4mm_P0.5mm_EP2.5x2.5mm_ThermalVias
Y2: 25 MHz; Crystal_SMD_3225-4Pin_3.2x2.5mm

Connections:
/CRS_DV: U6.11 (CRS_DV/MODE2); also elsewhere on the board
/ETH_RX0: R43.1; also elsewhere on the board
/ETH_RX1: R42.1; also elsewhere on the board
/ETH_TX0: R46.1; also elsewhere on the board
/ETH_TX1: R45.1; also elsewhere on the board
/ETH_TX_EN: R44.1; also elsewhere on the board
/Ethernet/DVDD: FB1.2, R19.1, R20.1, R21.1, R41.1, U6.1 (VDD2A), U6.19 (VDD1A)
/Ethernet/RBIAS: R17.1, U6.24 (RBIAS)
/Ethernet/RX+: J6.1, T1.16
/Ethernet/RX-: J6.2, T1.14
/Ethernet/RXN: R19.2, T1.3, U6.22 (RXN)
/Ethernet/RXP: R20.2, T1.1, U6.23 (RXP)
/Ethernet/SH0: C38.1, T1.10, T1.15
/Ethernet/SH1: C37.1, T1.2, T1.7
/Ethernet/TX+: J6.3, T1.11
/Ethernet/TX-: J6.4, T1.9
/Ethernet/TXN: R21.2, T1.8, U6.20 (TXN)
/Ethernet/TXP: R41.2, T1.6, U6.21 (TXP)
/MDC: U6.13 (MDC); also elsewhere on the board
/MDIO: U6.12 (MDIO); also elsewhere on the board
/REFCLK: U6.14 (~INT/REFCLKO); also elsewhere on the board
/RXER: U6.10 (RXER/PHYAD0); also elsewhere on the board
AVCC: FB1.1, U6.9 (VDDIO), U6.15 (~RST); also elsewhere on the board
GND: C35.2, C36.2, C37.2, C38.2, R17.2, R18.2, R47.2, U6.25 (VSS), Y2.2, Y2.4; also elsewhere on the board
unnamed: D2.2 (A), U6.3 (LED1/REGOFF)
unnamed: D2.1 (K), R18.1
unnamed: D4.2 (A), U6.2 (LED2/~INTSEL)
unnamed: D4.1 (K), R47.1
unnamed: R43.2, U6.8 (RXD0/MODE0)
unnamed: R42.2, U6.7 (RXD1/MODE1)
unnamed: R46.2, U6.17 (TXD0)
unnamed: R45.2, U6.18 (TXD1)
unnamed: R44.2, U6.16 (TXEN)
unnamed: C35.1, C36.1, U6.6 (VDDCR)
unnamed: U6.5 (XTAL1/CLKIN), Y2.1
unnamed: U6.4 (XTAL2), Y2.3

Notes on the sheet:
REF_CLK_OUT mode 25 MHz crystal REFCLK fed to MAC

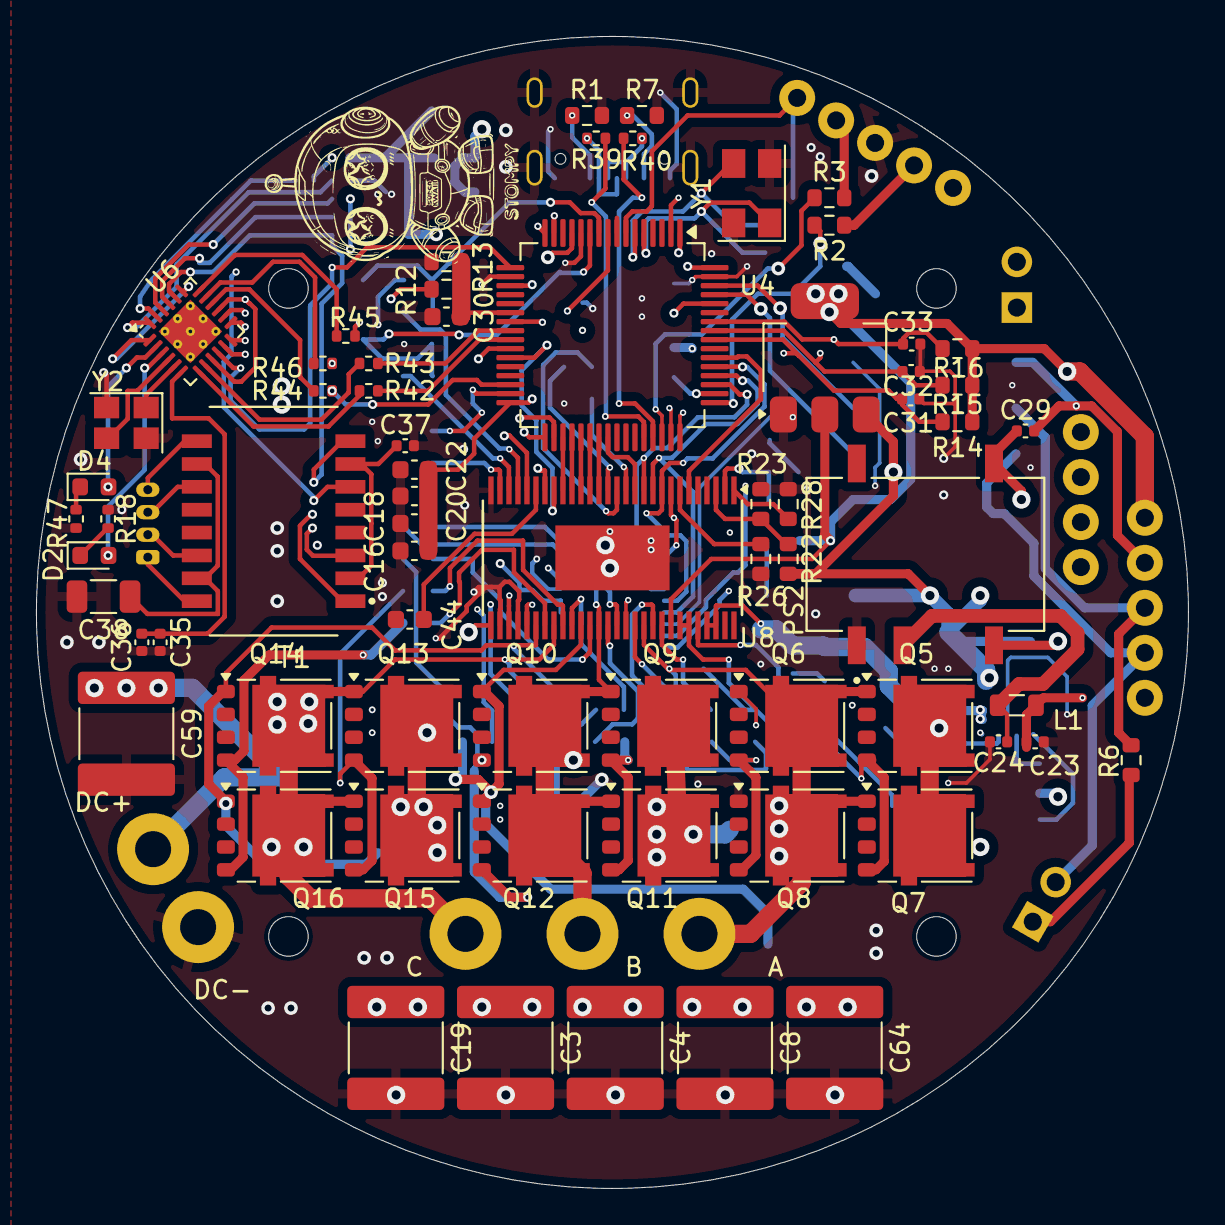
[picture p33: board ControllerV4.kicad_pcb from above]

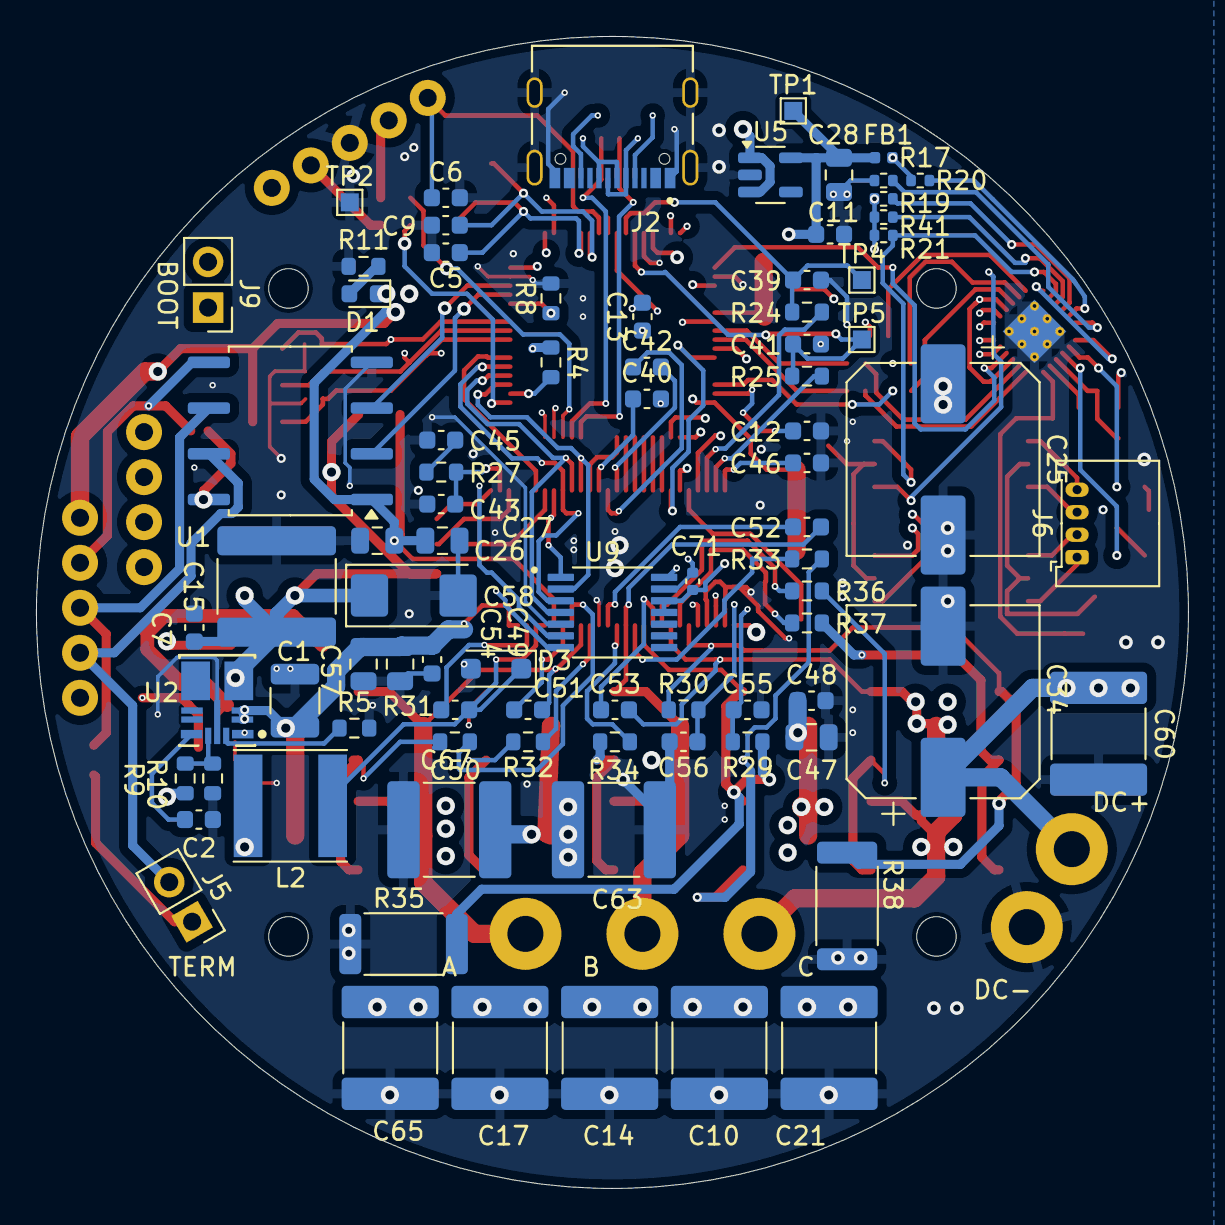
[picture p34: board ControllerV4.kicad_pcb from below]

Board: 4 copper layers, 64.0 x 64.0 mm, 160 parts (83 on the bottom side), 123 nets.
