kscalelabs/motor-controller/ControllerV2/ControllerV2Kicad.kicad_pcb

## KiCad design ControllerV2/ControllerV2Kicad.kicad_pcb (2024-06-18, an earlier design)

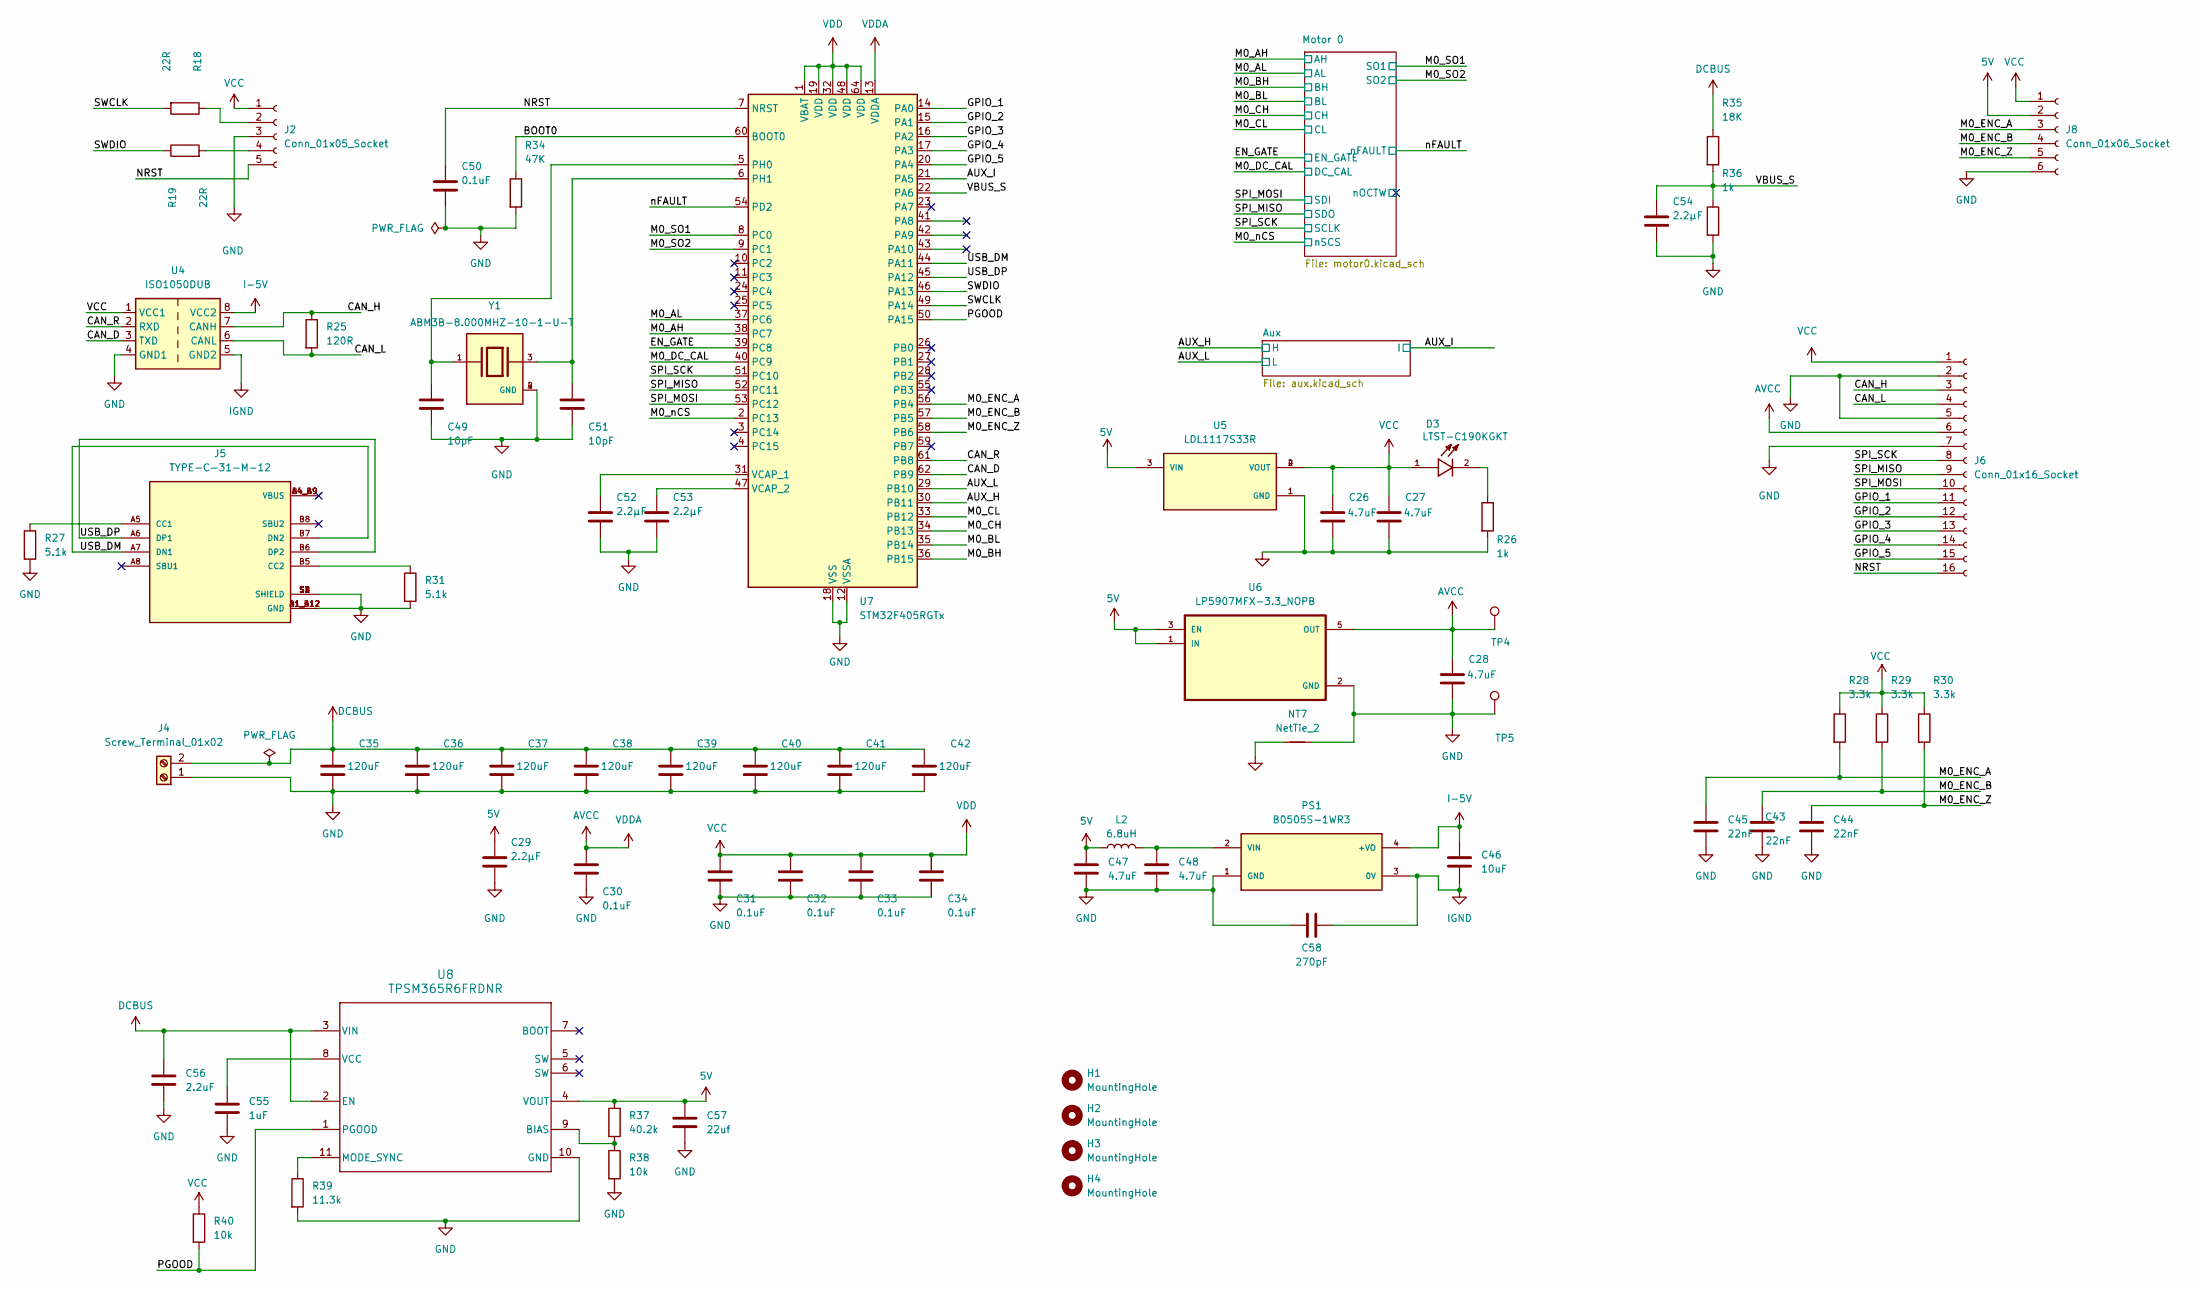
[picture p35: schematic ControllerV2Kicad.kicad_sch]

Parts:
C26, C27, C28: 4.7uF; C_0805_2012Metric; TOLERANCE ±10%; VOLTAGE - RATED 35V; PART STATUS Active
C29, C52, C53, C54: 2.2µF; C_0603_1608Metric; TOLERANCE ±10%; VOLTAGE - RATED 16V; MANUFACTURER PART NUMBER GRM188R61C225KE15D
C30, C31, C32, C33, C34, C50: 0.1uF; C_0603_1608Metric; TOLERANCE ±10%; VOLTAGE - RATED 50V; MANUFACTURER PART NUMBER GRM188R71H104KA93D
C35, C36, C37, C38, C39, C40, C41, C42: 470uF; C_Elec_10x10.2; TOLERANCE ±20%; PART STATUS Active
C43, C44, C45: 22nF; C_0402_1005Metric
C46: 10uF; C_0402_1005Metric
C47, C48: 4.7uF; C_0402_1005Metric
C49, C51: 10pF; C_0603_1608Metric; TOLERANCE ±5%; VOLTAGE - RATED 50V; MANUFACTURER PART NUMBER GRM1885C1H100JA01D
C55: 1uF; C_0603_1608Metric
C56: 2.2uF; C_1210_3225Metric
C57: 22uf; C_2225_5664Metric
C58: 270pF; C_0402_1005Metric
D3: LTST-C190KGKT; D_0603_1608Metric
H1, H2, H3, H4: MountingHole; MountingHole_2.2mm_M2
J2: Conn_01x05_Socket; PinSocket_1x05_P2.54mm_Vertical
J4: Screw_Terminal_01x02; TerminalBlock_MetzConnect_Type011_RT05502HBWC_1x02_P5.00mm_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
J5: TYPE-C-31-M-12; HRO_TYPE-C-31-M-12; PARTREV 2020.12.08
J6: Conn_01x16_Socket; PinSocket_1x16_P2.54mm_Vertical
J8: Conn_01x06_Socket; PinSocket_1x06_P2.54mm_Vertical
L2: 6.8uH; L_0805_2012Metric
NT7: NetTie_2; NetTie-2_SMD_Pad0.5mm
PS1: B0505S-1WR3; R_Array_SIP4; PARTREV 2018.06.29-A/2
R18, R19: 22R; R_0603_1608Metric; TOLERANCE ±1%; MANUFACTURER PART NUMBER RC0603FR-0722RL
R25: 120R; R_0603_1608Metric
R26, R36: 1k; R_0603_1608Metric; TOLERANCE ±1%; MANUFACTURER PART NUMBER RC0603FR-071KL
R27, R31: 5.1k; R_0603_1608Metric
R28, R29, R30: 3.3k; R_0603_1608Metric; TOLERANCE ±1%; MANUFACTURER PART NUMBER RC0603FR-073K3L
R34: 47K; R_0603_1608Metric; TOLERANCE ±1%; MANUFACTURER PART NUMBER RC0603FR-0747KL
R35: 18K; R_0603_1608Metric; TOLERANCE ±1%; MANUFACTURER PART NUMBER RC0603FR-0710KL
R37: 40.2k; R_0603_1608Metric
R38, R40: 10k; R_0603_1608Metric
R39: 11.3k; R_0603_1608Metric
TP4, TP5: TESTPOINT; TestPoint_Pad_1.0x1.0mm
U4: ISO1050DUB; SOP-8_6.62x9.15mm_P2.54mm
U5: LDL1117S33R; SOT-223; PARTREV 7
U6: LP5907MFX-3.3_NOPB; SOT-23-5
U7: STM32F405RGTx; LQFP-64_10x10mm_P0.5mm
U8: TPSM365R6FRDNR; RDN0011A-MFG
Y1: ABM3B-8.000MHZ-10-1-U-T; Crystal_SMD_5032-4Pin_5.0x3.2mm; PARTREV 08.25.15

Connections:
5V: C29.1, C47.1, C57.1, J8.2, L2.1, R37.1, U5.3 (VIN), U6.1 (IN), U6.3 (EN), U8.4 (VOUT); also elsewhere on the board
/AUX_H: U7.30 (PB11); also elsewhere on the board
/AUX_I: U7.21 (PA5); also elsewhere on the board
/AUX_L: U7.29 (PB10); also elsewhere on the board
/BOOT0: R34.1, U7.60 (BOOT0)
/CAN_D: U4.3 (TXD), U7.62 (PB9)
/CAN_H: J6.3, R25.1, U4.7 (CANH)
/CAN_L: J6.4, R25.2, U4.6 (CANL)
/CAN_R: U4.2 (RXD), U7.61 (PB8)
/EN_GATE: U7.39 (PC8); also elsewhere on the board
/GPIO_1: J6.11, U7.14 (PA0)
/GPIO_2: J6.12, U7.15 (PA1)
/GPIO_3: J6.13, U7.16 (PA2)
/GPIO_4: J6.14, U7.17 (PA3)
/GPIO_5: J6.15, U7.20 (PA4)
/M0_AH: U7.38 (PC7); also elsewhere on the board
/M0_AL: U7.37 (PC6); also elsewhere on the board
/M0_BH: U7.36 (PB15); also elsewhere on the board
/M0_BL: U7.35 (PB14); also elsewhere on the board
/M0_CH: U7.34 (PB13); also elsewhere on the board
/M0_CL: U7.33 (PB12); also elsewhere on the board
/M0_DC_CAL: U7.40 (PC9); also elsewhere on the board
/M0_ENC_A: C45.1, J8.3, R28.2, U7.56 (PB4)
/M0_ENC_B: C43.1, J8.4, R29.2, U7.57 (PB5)
/M0_ENC_Z: C44.1, J8.5, R30.2, U7.58 (PB6)
/M0_SO1: U7.8 (PC0); also elsewhere on the board
/M0_SO2: U7.9 (PC1); also elsewhere on the board
/M0_nCS: U7.2 (PC13); also elsewhere on the board
/NRST: C50.1, J2.5, J6.16, U7.7 (NRST)
/PGOOD: R40.2, U7.50 (PA15), U8.1 (PGOOD)
/SPI_MISO: J6.9, U7.52 (PC11); also elsewhere on the board
/SPI_MOSI: J6.10, U7.53 (PC12); also elsewhere on the board
/SPI_SCK: J6.8, U7.51 (PC10); also elsewhere on the board
/SWCLK: R18.2, U7.49 (PA14)
/SWDIO: R19.1, U7.46 (PA13)
/USB_DM: J5.A7 (DN1), J5.B7 (DN2), U7.44 (PA11)
/USB_DP: J5.A6 (DP1), J5.B6 (DP2), U7.45 (PA12)
/VBUS_S: C54.1, R35.2, R36.1, U7.22 (PA6)
/nFAULT: U7.54 (PD2); also elsewhere on the board
AVCC: C28.1, C30.1, J6.6, TP4.1, U6.5 (OUT), U7.13 (VDDA); also elsewhere on the board
DCBUS: C35.1, C36.1, C37.1, C38.1, C39.1, C40.1, C41.1, C42.1, C56.1, J4.2, R35.1, U8.2 (EN), U8.3 (VIN); also elsewhere on the board
GND: C26.2, C27.2, C28.2, C29.2, C30.2, C31.2, C32.2, C33.2, C34.2, C35.2, C36.2, C37.2, C38.2, C39.2, C40.2, C41.2, C42.2, C43.2, C44.2, C45.2, C47.2, C48.2, C49.2, C50.2, C51.2, C52.2, C53.2, C54.2, C55.2, C56.2, C57.2, C58.2, J2.3, J4.1, J5.A1_B12 (GND), J5.B1_A12 (GND), J5.S1 (SHIELD), J5.S2 (SHIELD), J5.S3 (SHIELD), J5.S4 (SHIELD), J6.2, J6.5, J6.7, J8.6, NT7.1, NT7.2, PS1.1 (GND), R26.2, R27.2, R31.2, R34.2, R36.2, R38.2, R39.2, TP5.1, U4.4 (GND1), U5.1 (GND), U6.2 (GND), U7.12 (VSSA), U7.18 (VSS), U7.63 (VSS), U8.10 (GND), Y1.2 (GND), Y1.4 (GND); also elsewhere on the board
I-5V: C46.1, PS1.4 (+VO), U4.8 (VCC2)
IGND: C46.2, C58.1, PS1.3 (0V), U4.5 (GND2)
unnamed: D3.2, R26.1
unnamed: J2.2, R18.1
unnamed: J2.4, R19.2
unnamed: J5.A5 (CC1), R27.1
unnamed: J5.B5 (CC2), R31.1
unnamed: C48.1, L2.2, PS1.2 (VIN)
unnamed: C49.1, U7.5 (PH0), Y1.1
unnamed: C51.1, U7.6 (PH1), Y1.3
unnamed: C52.1, U7.31 (VCAP_1)
unnamed: C53.1, U7.47 (VCAP_2)
unnamed: R37.2, R38.1, U8.9 (BIAS)
unnamed: R39.1, U8.11 (MODE_SYNC)
unnamed: C55.1, U8.8 (VCC)
VCC: C26.1, C27.1, C31.1, C32.1, C33.1, C34.1, D3.1, J2.1, J6.1, J8.1, R28.1, R29.1, R30.1, R40.1, U4.1 (VCC1), U5.2 (VOUT), U5.4 (VOUT), U7.1 (VBAT), U7.19 (VDD), U7.32 (VDD), U7.48 (VDD), U7.64 (VDD); also elsewhere on the board

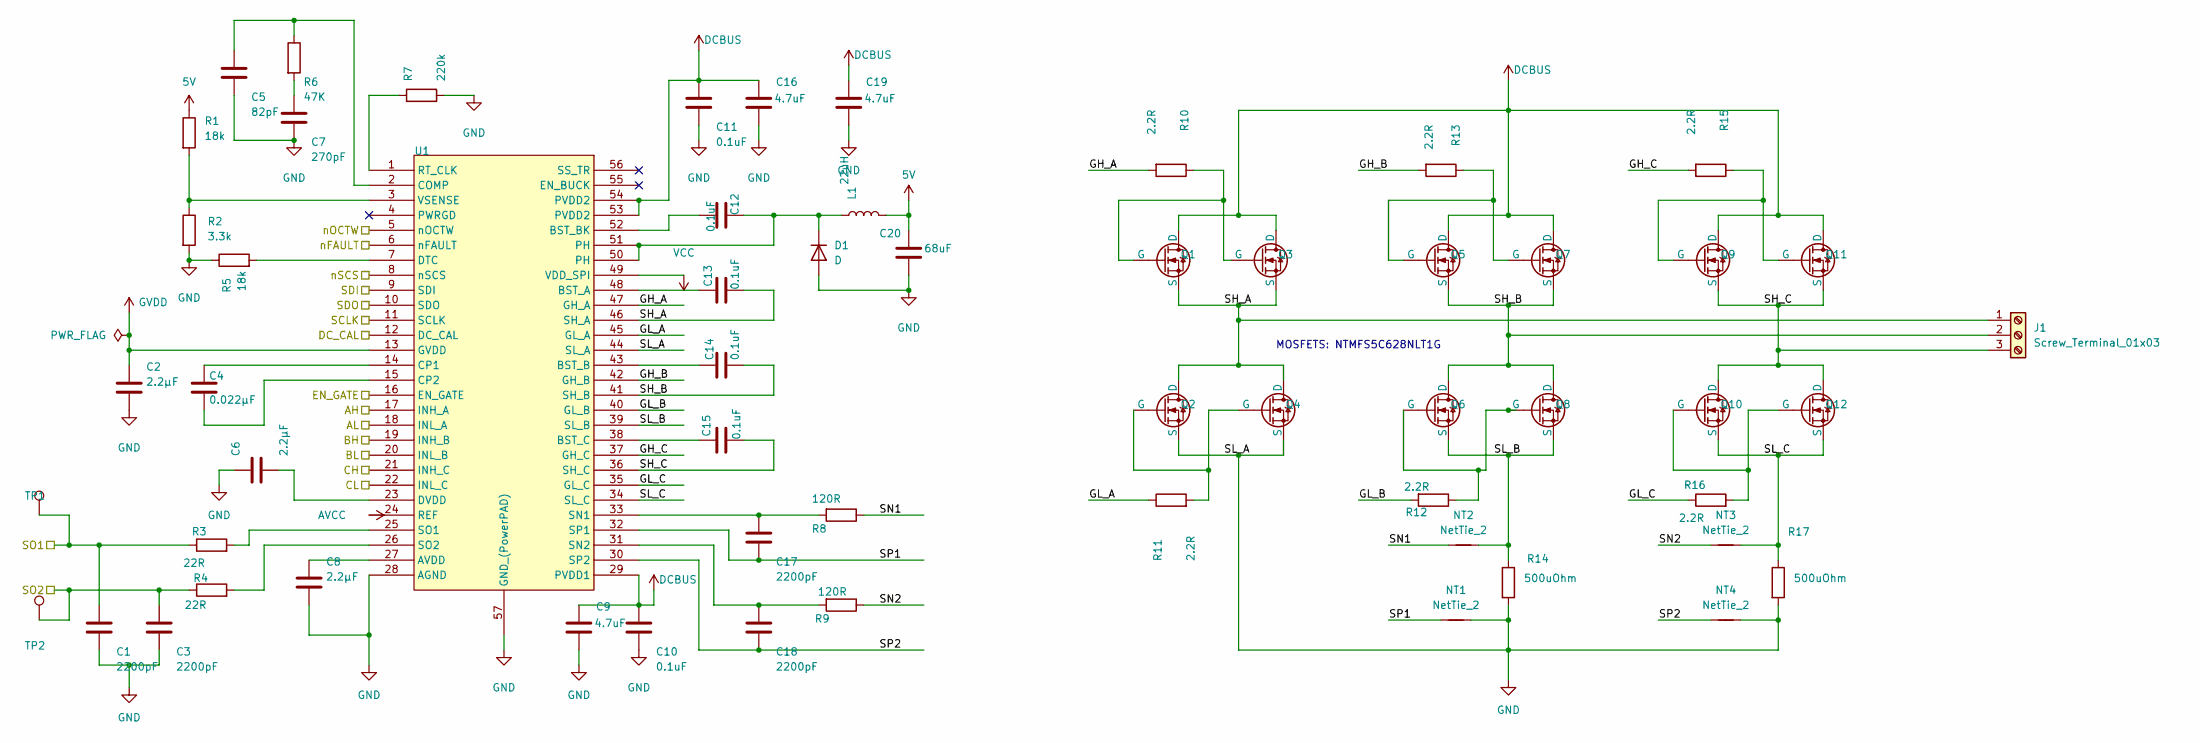
[picture p36: schematic motor0.kicad_sch]

Parts:
C1, C3, C17, C18: 2200pF; C_0603_1608Metric; TOLERANCE ±5%; VOLTAGE - RATED 50V; PART STATUS Active
C2, C6, C8: 2.2µF; C_0603_1608Metric; TOLERANCE ±10%; VOLTAGE - RATED 16V; MANUFACTURER PART NUMBER GRM188R61C225KE15D
C4: 0.022µF; C_0603_1608Metric; TOLERANCE ±10%; VOLTAGE - RATED 50V; MANUFACTURER PART NUMBER GRM188R71H223KA01D
C5: 82pF; C_0603_1608Metric; TOLERANCE ±5%; VOLTAGE - RATED 100V; MANUFACTURER PART NUMBER GRM1885C2A820JA01D
C7: 270pF; C_0603_1608Metric; TOLERANCE ±5%; VOLTAGE - RATED 50V; MANUFACTURER PART NUMBER GRM1885C1H271JA01D
C9, C16, C19: 4.7uF; C_0805_2012Metric; TOLERANCE ±10%; VOLTAGE - RATED 35V; PART STATUS Active
C10, C11, C12, C13, C14, C15: 0.1uF; C_0603_1608Metric; TOLERANCE ±10%; VOLTAGE - RATED 50V; MANUFACTURER PART NUMBER GRM188R71H104KA93D
C20: 68uF; CP_EIA-6032-28_Kemet-C; TOLERANCE ±20%; PART STATUS Active
D1: D; D_SOD-123F
J1: Screw_Terminal_01x03; TerminalBlock_MetzConnect_Type011_RT05503HBWC_1x03_P5.00mm_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
L1: 22uH; L_Taiyo-Yuden_NR-60xx
NT1, NT2, NT3, NT4: NetTie_2; NetTie-2_SMD_Pad0.5mm
Q1, Q2, Q3, Q4, Q5, Q6, Q8, Q9, Q10, Q12: ONSemi_SO-8FL_488AA; DRIVE VOLTAGE (MAX RDS 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 4.5V, 10V; PART STATUS Active
Q7, Q11: FILL_FOOTPRINT; ONSemi_SO-8FL_488AA; DRIVE VOLTAGE (MAX RDS 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 4.5V, 10V; PART STATUS Active
R1, R5: 18k; R_0603_1608Metric; TOLERANCE ±1%; MANUFACTURER PART NUMBER RC0603FR-0718KL
R2: 3.3k; R_0603_1608Metric; TOLERANCE ±1%; MANUFACTURER PART NUMBER RC0603FR-073K3L
R3, R4: 22R; R_0603_1608Metric; TOLERANCE ±1%; MANUFACTURER PART NUMBER RC0603FR-0722RL
R6: 47K; R_0603_1608Metric; TOLERANCE ±1%; MANUFACTURER PART NUMBER RC0603FR-0747KL
R7: 220k; R_0603_1608Metric; TOLERANCE ±1%; MANUFACTURER PART NUMBER RC0603FR-07220KL
R8, R9: 120R; R_0603_1608Metric; TOLERANCE ±1%; MANUFACTURER PART NUMBER RC0603FR-07120RL
R10, R11, R12, R13, R15, R16: 2.2R; R_0603_1608Metric; TOLERANCE ±1%; MANUFACTURER PART NUMBER RC0603FR-072R2L
R14, R17: 500uOhm; R_2512_6332Metric; TOLERANCE ±1%; PART STATUS Active
TP1, TP2: TESTPOINT; TestPoint_Pad_1.0x1.0mm
U1: HTSSOP-56-1EP_6.1x14mm_P0.5mm_EP3.61x6.35mm

Connections:
5V: C20.1, L1.2, R1.1; also elsewhere on the board
/EN_GATE: U1.16 (EN_GATE); also elsewhere on the board
/M0_AH: U1.17 (INH_A); also elsewhere on the board
/M0_AL: U1.18 (INL_A); also elsewhere on the board
/M0_BH: U1.19 (INH_B); also elsewhere on the board
/M0_BL: U1.20 (INL_B); also elsewhere on the board
/M0_CH: U1.21 (INH_C); also elsewhere on the board
/M0_CL: U1.22 (INL_C); also elsewhere on the board
/M0_DC_CAL: U1.12 (DC_CAL); also elsewhere on the board
/M0_SO1: C1.1, R3.1, TP1.1; also elsewhere on the board
/M0_SO2: C3.1, R4.1, TP2.1; also elsewhere on the board
/M0_nCS: U1.8 (nSCS); also elsewhere on the board
/Motor 0/GH_A: R10.2, U1.47 (GH_A)
/Motor 0/GH_B: R13.2, U1.42 (GH_B)
/Motor 0/GH_C: R15.2, U1.37 (GH_C)
/Motor 0/GL_A: R11.1, U1.45 (GL_A)
/Motor 0/GL_B: R12.2, U1.40 (GL_B)
/Motor 0/GL_C: R16.1, U1.35 (GL_C)
/Motor 0/SH_A: C13.2, J1.1, Q1.1 (S), Q2.5 (D), Q3.1 (S), Q4.5 (D), U1.46 (SH_A)
/Motor 0/SH_B: C14.2, J1.2, Q5.1 (S), Q6.5 (D), Q7.1 (S), Q8.5 (D), U1.41 (SH_B)
/Motor 0/SH_C: C15.2, J1.3, Q9.1 (S), Q10.5 (D), Q11.1 (S), Q12.5 (D), U1.36 (SH_C)
/Motor 0/SL_B: NT2.2, Q6.1 (S), Q8.1 (S), R14.1, U1.39 (SL_B)
/Motor 0/SL_C: NT3.2, Q10.1 (S), Q12.1 (S), R17.1, U1.34 (SL_C)
/Motor 0/SN1: NT2.1, R8.1
/Motor 0/SN2: NT3.1, R9.1
/Motor 0/SP1: C17.2, NT1.1, U1.32 (SP1)
/Motor 0/SP2: C18.2, NT4.1, U1.30 (SP2)
/Motor 0/nOCTW: U1.5 (nOCTW)
/SPI_MISO: U1.10 (SDO); also elsewhere on the board
/SPI_MOSI: U1.9 (SDI); also elsewhere on the board
/SPI_SCK: U1.11 (SCLK); also elsewhere on the board
/nFAULT: U1.6 (nFAULT); also elsewhere on the board
AVCC: U1.24 (REF); also elsewhere on the board
DCBUS: C9.1, C10.1, C11.1, C16.1, C19.1, Q1.5 (D), Q3.5 (D), Q5.5 (D), Q7.5 (D), Q9.5 (D), Q11.5 (D), U1.29 (PVDD1), U1.53 (PVDD2), U1.54 (PVDD2); also elsewhere on the board
GND: C1.2, C2.2, C3.2, C5.2, C6.1, C7.2, C8.2, C9.2, C10.2, C11.2, C16.2, C19.2, C20.2, D1.2 (A), NT1.2, NT4.2, Q2.1 (S), Q4.1 (S), R2.2, R5.1, R7.2, R14.2, R17.2, U1.28 (AGND), U1.44 (SL_A), U1.57 (GND_(PowerPAD)); also elsewhere on the board
GVDD: C2.1, U1.13 (GVDD); also elsewhere on the board
unnamed: C7.1, R6.2
unnamed: C12.1, D1.1 (K), L1.1, U1.50 (PH), U1.51 (PH)
unnamed: Q1.4 (G), Q3.4 (G), R10.1
unnamed: Q2.4 (G), Q4.4 (G), R11.2
unnamed: Q5.4 (G), Q7.4 (G), R13.1
unnamed: Q6.4 (G), Q8.4 (G), R12.1
unnamed: Q10.4 (G), Q12.4 (G), R16.2
unnamed: Q9.4 (G), Q11.4 (G), R15.1
unnamed: C8.1, U1.27 (AVDD)
unnamed: C13.1, U1.48 (BST_A)
unnamed: C14.1, U1.43 (BST_B)
unnamed: C12.2, U1.52 (BST_BK)
unnamed: C15.1, U1.38 (BST_C)
unnamed: C5.1, R6.1, U1.2 (COMP)
unnamed: C4.1, U1.14 (CP1)
unnamed: C4.2, U1.15 (CP2)
unnamed: R5.2, U1.7 (DTC)
unnamed: C6.2, U1.23 (DVDD)
unnamed: R7.1, U1.1 (RT_CLK)
unnamed: C17.1, R8.2, U1.33 (SN1)
unnamed: C18.1, R9.2, U1.31 (SN2)
unnamed: R3.2, U1.25 (SO1)
unnamed: R4.2, U1.26 (SO2)
unnamed: R1.2, R2.1, U1.3 (VSENSE)
VCC: U1.49 (VDD_SPI); also elsewhere on the board

Notes on the sheet:
MOSFETS: NTMFS5C628NLT1G

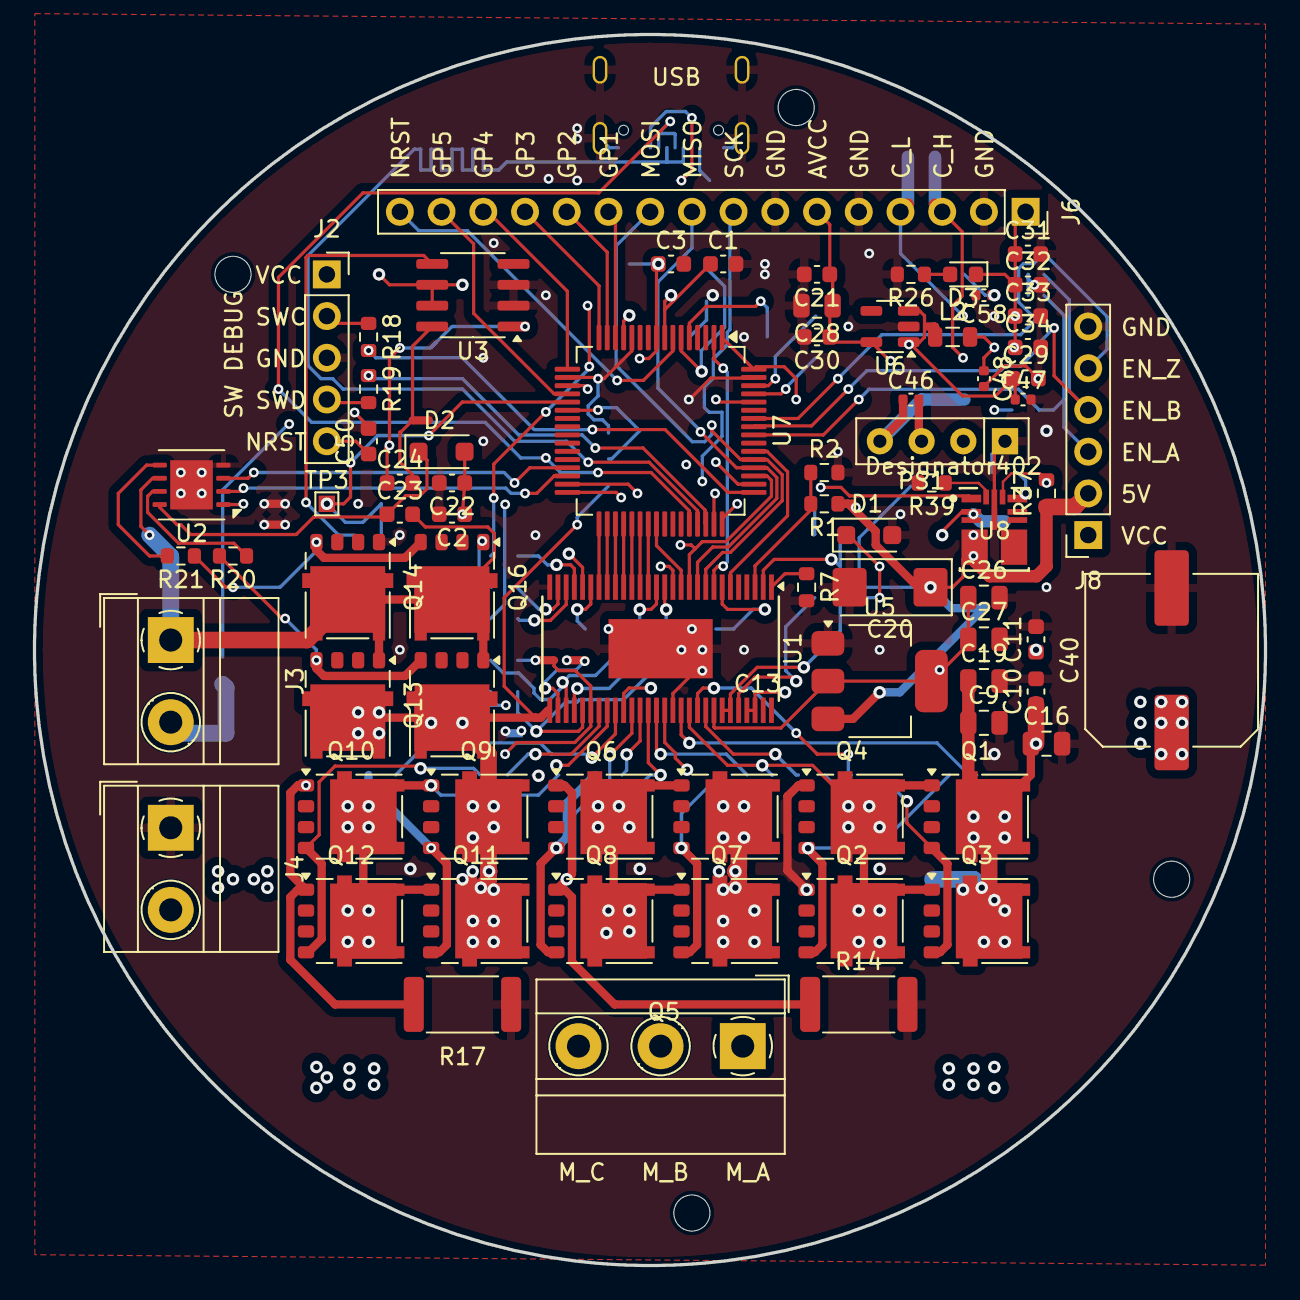
[picture p37: board ControllerV2Kicad.kicad_pcb from above]

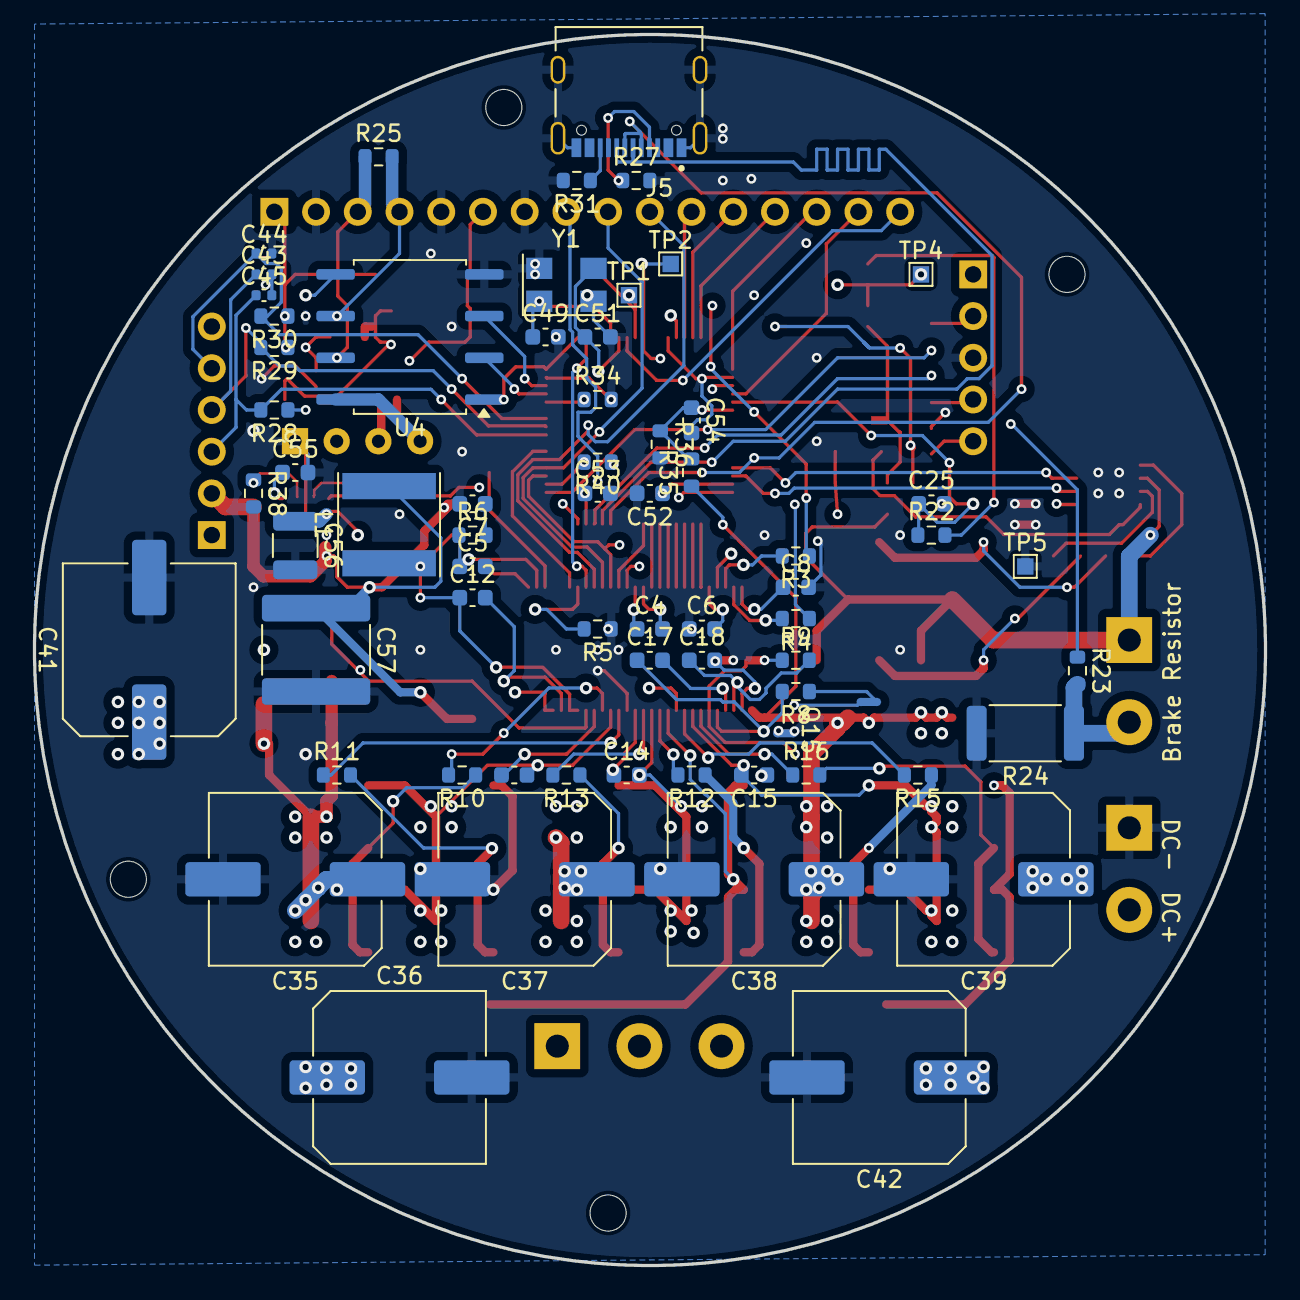
[picture p38: board ControllerV2Kicad.kicad_pcb from below]

Board: 4 copper layers, 75.0 x 75.0 mm, 150 parts (66 on the bottom side), 108 nets.

Other parts of the board:
C21, C23: 0.1uF; C_0603_1608Metric
C22: 2.2µF; C_0603_1608Metric
C24, C25: 2200pF; C_0603_1608Metric
D2: D; D_SOD-123F
J3: Screw_Terminal_01x02; TerminalBlock_MetzConnect_Type011_RT05502HBWC_1x02_P5.00mm_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
NT5, NT6: NetTie_2; NetTie-2_SMD_Pad0.5mm
Q13: FILL_FOOTPRINT; ONSemi_SO-8FL_488AA
Q14, Q15, Q16: ONSemi_SO-8FL_488AA
R20, R21: 2.2R; R_0603_1608Metric
R22, R23: 120R; R_0603_1608Metric
R24: 500uOhm; R_2512_6332Metric
TP3: TESTPOINT; TestPoint_Pad_1.0x1.0mm
U2: WSON-8-1EP_4x4mm_P0.8mm_EP2.6x3mm
U3: SOIC-8_3.9x4.9mm_P1.27mm

Their connections:
/AUX_H: U2.2 (HI); also elsewhere on the board
/AUX_I: C25.1, R22.1, TP3.1; also elsewhere on the board
/AUX_L: U2.3 (LI); also elsewhere on the board
AVCC: C21.1, U3.6 (Vs), U3.7 (Vref_1); also elsewhere on the board
DCBUS: Q13.5 (D), Q15.5 (D); also elsewhere on the board
GND: C21.2, C22.2, C25.2, NT5.1, NT5.2, NT6.2, Q14.1 (S), Q16.1 (S), R24.2, U2.4 (VSS), U2.9 (Thermal_Pad), U3.2 (GND), U3.3 (Vref_2); also elsewhere on the board
GVDD: C22.1, D2.2 (A), U2.1 (VDD); also elsewhere on the board
unnamed: C23.1, D2.1 (K), U2.8 (HB)
unnamed: C23.2, J3.1, Q13.1 (S), Q14.5 (D), Q15.1 (S), Q16.5 (D), U2.6 (HS)
unnamed: J3.2, R23.2, R24.1
unnamed: Q13.4 (G), Q15.4 (G), R20.2
unnamed: Q14.4 (G), Q16.4 (G), R21.1
unnamed: R20.1, U2.7 (HO)
unnamed: R21.2, U2.5 (LO)
unnamed: C24.2, NT6.1, U3.8 (+IN)
unnamed: C24.1, R23.1, U3.1 (-IN)
unnamed: R22.2, U3.5 (OUT)
