kscalelabs/motor-controller/ControllerV1/ControllerTop.kicad_pcb

## KiCad design ControllerV1/ControllerTop.kicad_pcb (2024-06-18, an earlier design)

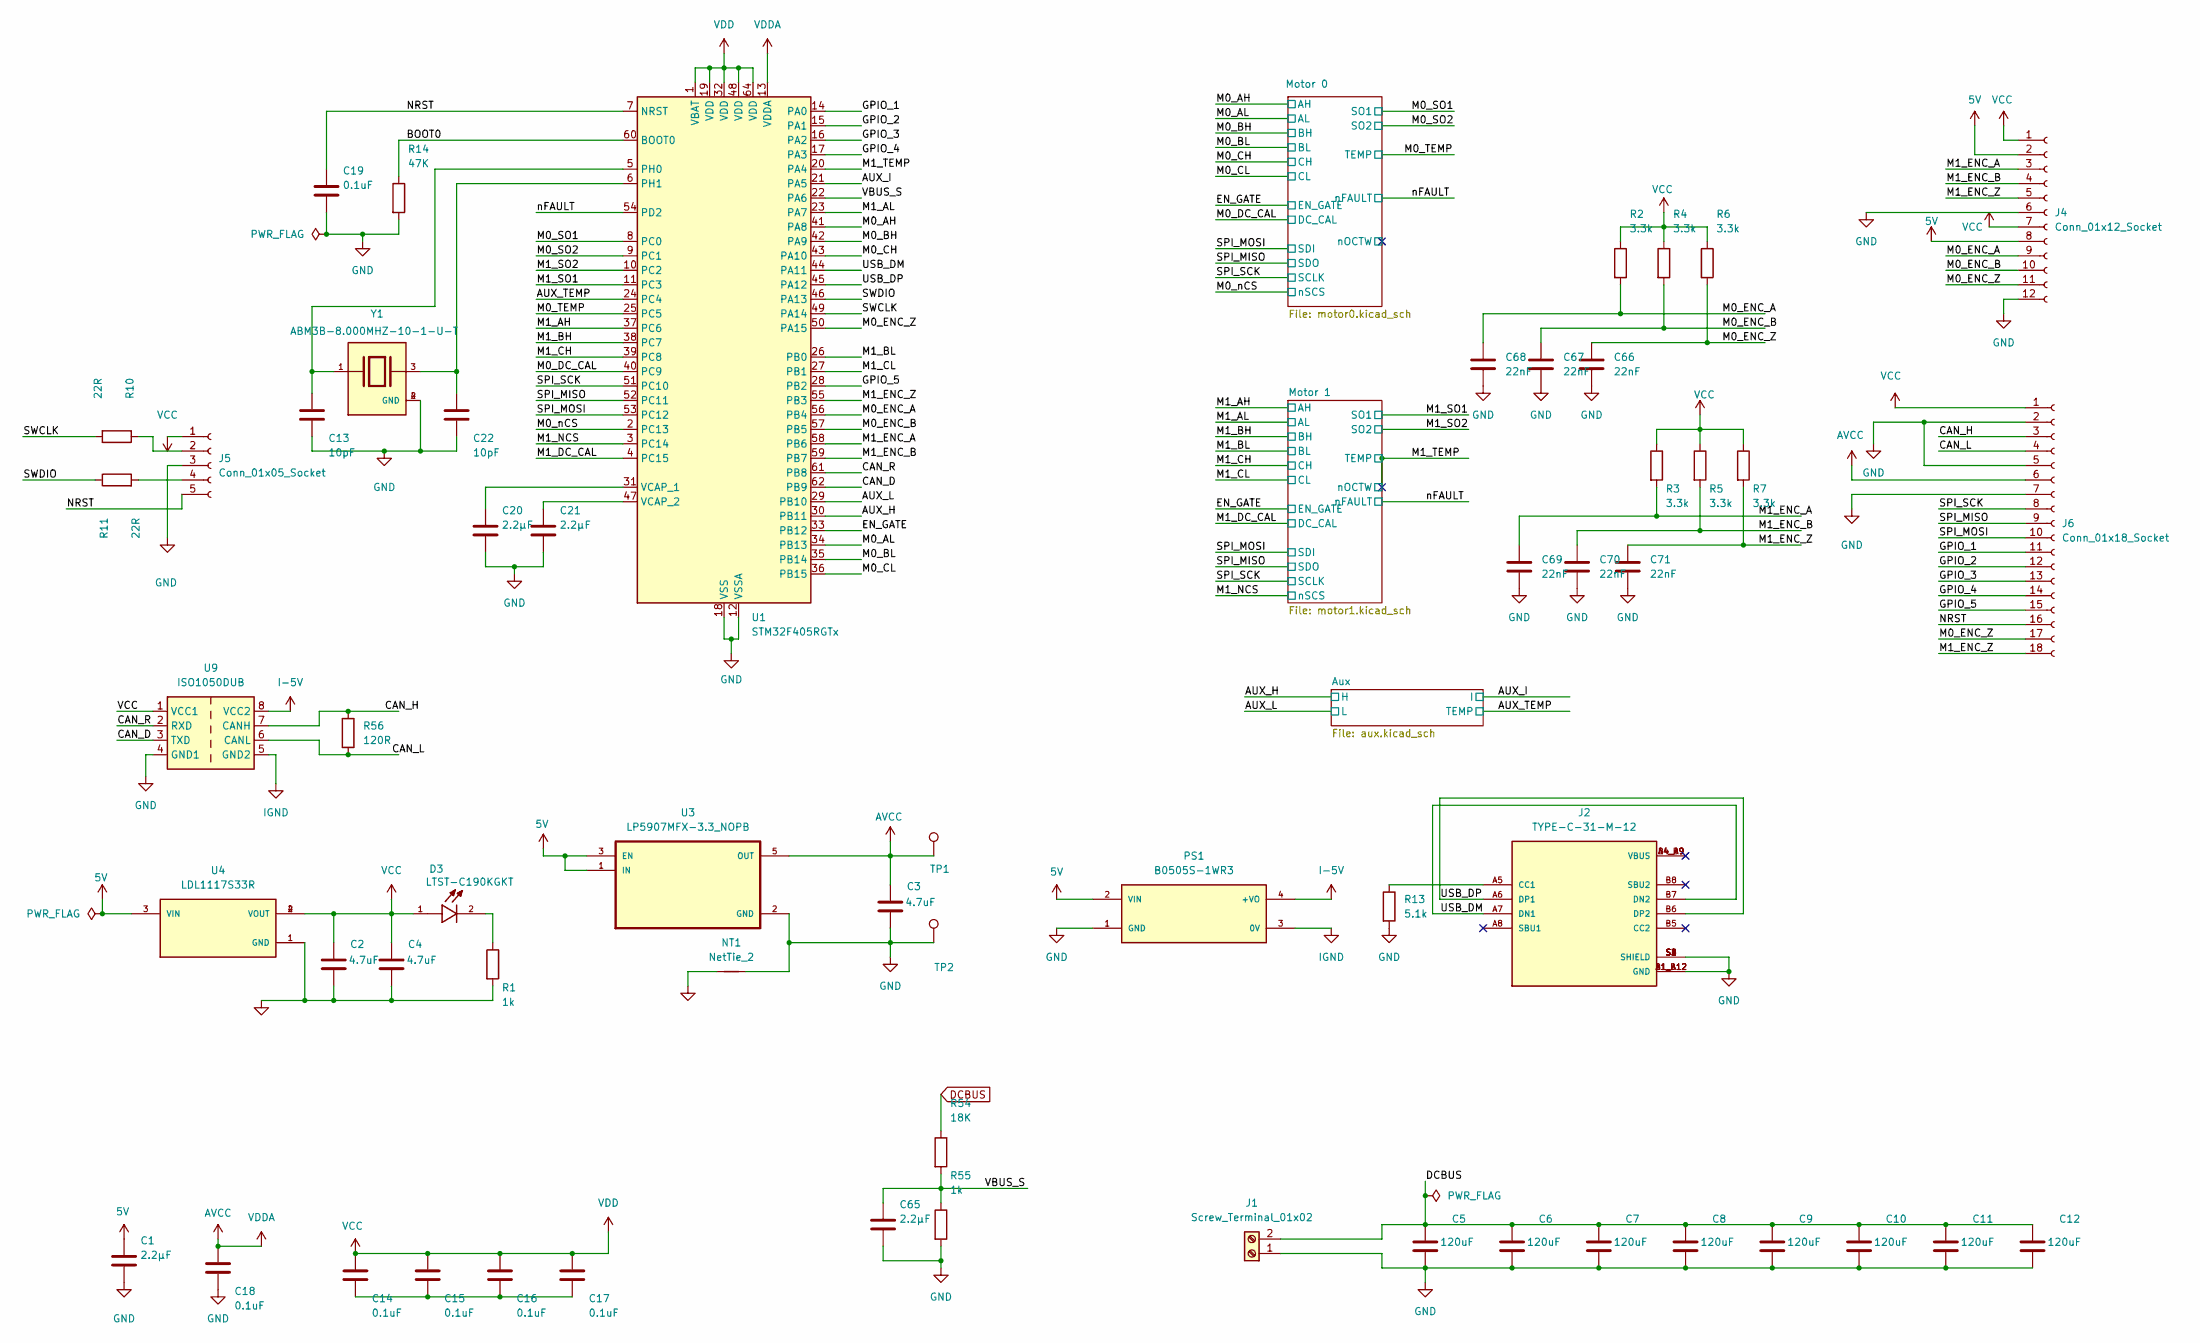
[picture p39: schematic ControllerTop.kicad_sch]

Parts:
C1, C20, C21, C65: 2.2µF; C_0603_1608Metric; TOLERANCE ±10%; VOLTAGE - RATED 16V; MANUFACTURER PART NUMBER GRM188R61C225KE15D
C2, C3, C4: 4.7uF; C_0805_2012Metric; TOLERANCE ±10%; VOLTAGE - RATED 35V; PART STATUS Active
C5, C6, C7, C8, C9, C10, C11, C12: 470uF; C_Elec_10x10.2; TOLERANCE ±20%; PART STATUS Active
C13, C22: 10pF; C_0603_1608Metric; TOLERANCE ±5%; VOLTAGE - RATED 50V; MANUFACTURER PART NUMBER GRM1885C1H100JA01D
C14, C15, C16, C17, C18, C19: 0.1uF; C_0603_1608Metric; TOLERANCE ±10%; VOLTAGE - RATED 50V; MANUFACTURER PART NUMBER GRM188R71H104KA93D
C66, C67, C68, C69, C70, C71: 22nF; C_0402_1005Metric
D3: LTST-C190KGKT; D_0603_1608Metric
J1: Screw_Terminal_01x02; TerminalBlock_MetzConnect_Type011_RT05502HBWC_1x02_P5.00mm_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
J2: TYPE-C-31-M-12; HRO_TYPE-C-31-M-12; PARTREV 2020.12.08
J4: Conn_01x12_Socket; PinSocket_1x12_P2.54mm_Vertical
J5: Conn_01x05_Socket; PinSocket_1x05_P2.54mm_Vertical
J6: Conn_01x18_Socket; PinSocket_1x18_P2.54mm_Vertical
NT1: NetTie_2; NetTie-2_SMD_Pad0.5mm
PS1: B0505S-1WR3; R_Array_SIP4; PARTREV 2018.06.29-A/2
R1, R55: 1k; R_0603_1608Metric; TOLERANCE ±1%; MANUFACTURER PART NUMBER RC0603FR-071KL
R2, R3, R4, R5, R6, R7: 3.3k; R_0603_1608Metric; TOLERANCE ±1%; MANUFACTURER PART NUMBER RC0603FR-073K3L
R10, R11: 22R; R_0603_1608Metric; TOLERANCE ±1%; MANUFACTURER PART NUMBER RC0603FR-0722RL
R13: 5.1k; R_0603_1608Metric
R14: 47K; R_0603_1608Metric; TOLERANCE ±1%; MANUFACTURER PART NUMBER RC0603FR-0747KL
R54: 18K; R_0603_1608Metric; TOLERANCE ±1%; MANUFACTURER PART NUMBER RC0603FR-0710KL
R56: 120R; R_0603_1608Metric
TP1, TP2: TESTPOINT; TestPoint_Pad_1.0x1.0mm
U1: STM32F405RGTx; LQFP-64_10x10mm_P0.5mm
U3: LP5907MFX-3.3_NOPB; SOT-23-5
U4: LDL1117S33R; SOT-223; PARTREV 7
U9: ISO1050DUB; SOP-8_6.62x9.15mm_P2.54mm
Y1: ABM3B-8.000MHZ-10-1-U-T; Crystal_SMD_5032-4Pin_5.0x3.2mm; PARTREV 08.25.15

Connections:
5V: C1.1, J4.2, J4.8, PS1.2 (VIN), U3.1 (IN), U3.3 (EN), U4.3 (VIN); also elsewhere on the board
/AUX_H: U1.30 (PB11); also elsewhere on the board
/AUX_I: U1.21 (PA5); also elsewhere on the board
/AUX_L: U1.29 (PB10); also elsewhere on the board
/AUX_TEMP: U1.24 (PC4); also elsewhere on the board
/BOOT0: R14.1, U1.60 (BOOT0)
/CAN_D: U1.62 (PB9), U9.3 (TXD)
/CAN_H: J6.3, R56.1, U9.7 (CANH)
/CAN_L: J6.4, R56.2, U9.6 (CANL)
/CAN_R: U1.61 (PB8), U9.2 (RXD)
/EN_GATE: U1.33 (PB12); also elsewhere on the board
/GPIO_1: J6.11, U1.14 (PA0)
/GPIO_2: J6.12, U1.15 (PA1)
/GPIO_3: J6.13, U1.16 (PA2)
/GPIO_4: J6.14, U1.17 (PA3)
/GPIO_5: J6.15, U1.28 (PB2)
/M0_AH: U1.41 (PA8); also elsewhere on the board
/M0_AL: U1.34 (PB13); also elsewhere on the board
/M0_BH: U1.42 (PA9); also elsewhere on the board
/M0_BL: U1.35 (PB14); also elsewhere on the board
/M0_CH: U1.43 (PA10); also elsewhere on the board
/M0_CL: U1.36 (PB15); also elsewhere on the board
/M0_DC_CAL: U1.40 (PC9); also elsewhere on the board
/M0_ENC_A: C68.1, J4.9, R2.2, U1.56 (PB4)
/M0_ENC_B: C67.1, J4.10, R4.2, U1.57 (PB5)
/M0_ENC_Z: C66.1, J4.11, J6.17, R6.2, U1.50 (PA15)
/M0_SO1: U1.8 (PC0); also elsewhere on the board
/M0_SO2: U1.9 (PC1); also elsewhere on the board
/M0_TEMP: U1.25 (PC5); also elsewhere on the board
/M0_nCS: U1.2 (PC13); also elsewhere on the board
/M1_AH: U1.37 (PC6); also elsewhere on the board
/M1_AL: U1.23 (PA7); also elsewhere on the board
/M1_BH: U1.38 (PC7); also elsewhere on the board
/M1_BL: U1.26 (PB0); also elsewhere on the board
/M1_CH: U1.39 (PC8); also elsewhere on the board
/M1_CL: U1.27 (PB1); also elsewhere on the board
/M1_DC_CAL: U1.4 (PC15); also elsewhere on the board
/M1_ENC_A: C69.1, J4.3, R3.2, U1.58 (PB6)
/M1_ENC_B: C70.1, J4.4, R5.2, U1.59 (PB7)
/M1_ENC_Z: C71.1, J4.5, J6.18, R7.2, U1.55 (PB3)
/M1_NCS: U1.3 (PC14); also elsewhere on the board
/M1_SO1: U1.11 (PC3); also elsewhere on the board
/M1_SO2: U1.10 (PC2); also elsewhere on the board
/M1_TEMP: U1.20 (PA4); also elsewhere on the board
/NRST: C19.1, J5.5, J6.16, U1.7 (NRST)
/SPI_MISO: J6.9, U1.52 (PC11); also elsewhere on the board
/SPI_MOSI: J6.10, U1.53 (PC12); also elsewhere on the board
/SPI_SCK: J6.8, U1.51 (PC10); also elsewhere on the board
/SWCLK: R10.2, U1.49 (PA14)
/SWDIO: R11.1, U1.46 (PA13)
/USB_DM: J2.A7 (DN1), J2.B7 (DN2), U1.44 (PA11)
/USB_DP: J2.A6 (DP1), J2.B6 (DP2), U1.45 (PA12)
/VBUS_S: C65.1, R54.2, R55.1, U1.22 (PA6)
/nFAULT: U1.54 (PD2); also elsewhere on the board
AVCC: C3.1, C18.1, J6.6, TP1.1, U1.13 (VDDA), U3.5 (OUT); also elsewhere on the board
DCBUS: C5.1, C6.1, C7.1, C8.1, C9.1, C10.1, C11.1, C12.1, J1.2, R54.1; also elsewhere on the board
GND: C1.2, C2.2, C3.2, C4.2, C5.2, C6.2, C7.2, C8.2, C9.2, C10.2, C11.2, C12.2, C13.2, C18.2, C19.2, C20.2, C21.2, C22.2, C65.2, C66.2, C67.2, C68.2, C69.2, C70.2, C71.2, J1.1, J2.A1_B12 (GND), J2.B1_A12 (GND), J2.S1 (SHIELD), J2.S2 (SHIELD), J2.S3 (SHIELD), J2.S4 (SHIELD), J4.6, J4.12, J5.3, J6.2, J6.5, J6.7, NT1.1, NT1.2, PS1.1 (GND), R1.2, R13.2, R14.2, R55.2, TP2.1, U1.12 (VSSA), U1.18 (VSS), U1.63 (VSS), U3.2 (GND), U4.1 (GND), U9.4 (GND1), Y1.2 (GND), Y1.4 (GND); also elsewhere on the board
I-5V: PS1.4 (+VO), U9.8 (VCC2)
IGND: PS1.3 (0V), U9.5 (GND2)
unnamed: C14.2, C15.2, C16.2, C17.2
unnamed: D3.2, R1.1
unnamed: J2.A5 (CC1), R13.1
unnamed: J5.2, R10.1
unnamed: J5.4, R11.2
unnamed: C13.1, U1.5 (PH0), Y1.1
unnamed: C22.1, U1.6 (PH1), Y1.3
unnamed: C20.1, U1.31 (VCAP_1)
unnamed: C21.1, U1.47 (VCAP_2)
VCC: C2.1, C4.1, C14.1, C15.1, C16.1, C17.1, D3.1, J4.1, J4.7, J5.1, J6.1, R2.1, R3.1, R4.1, R5.1, R6.1, R7.1, U1.1 (VBAT), U1.19 (VDD), U1.32 (VDD), U1.48 (VDD), U1.64 (VDD), U4.2 (VOUT), U4.4 (VOUT), U9.1 (VCC1); also elsewhere on the board
