kscalelabs/motor-controller/ControllerV1/ControllerTop.kicad_pcb

## KiCad design ControllerV1/ControllerTop.kicad_pcb (continued)

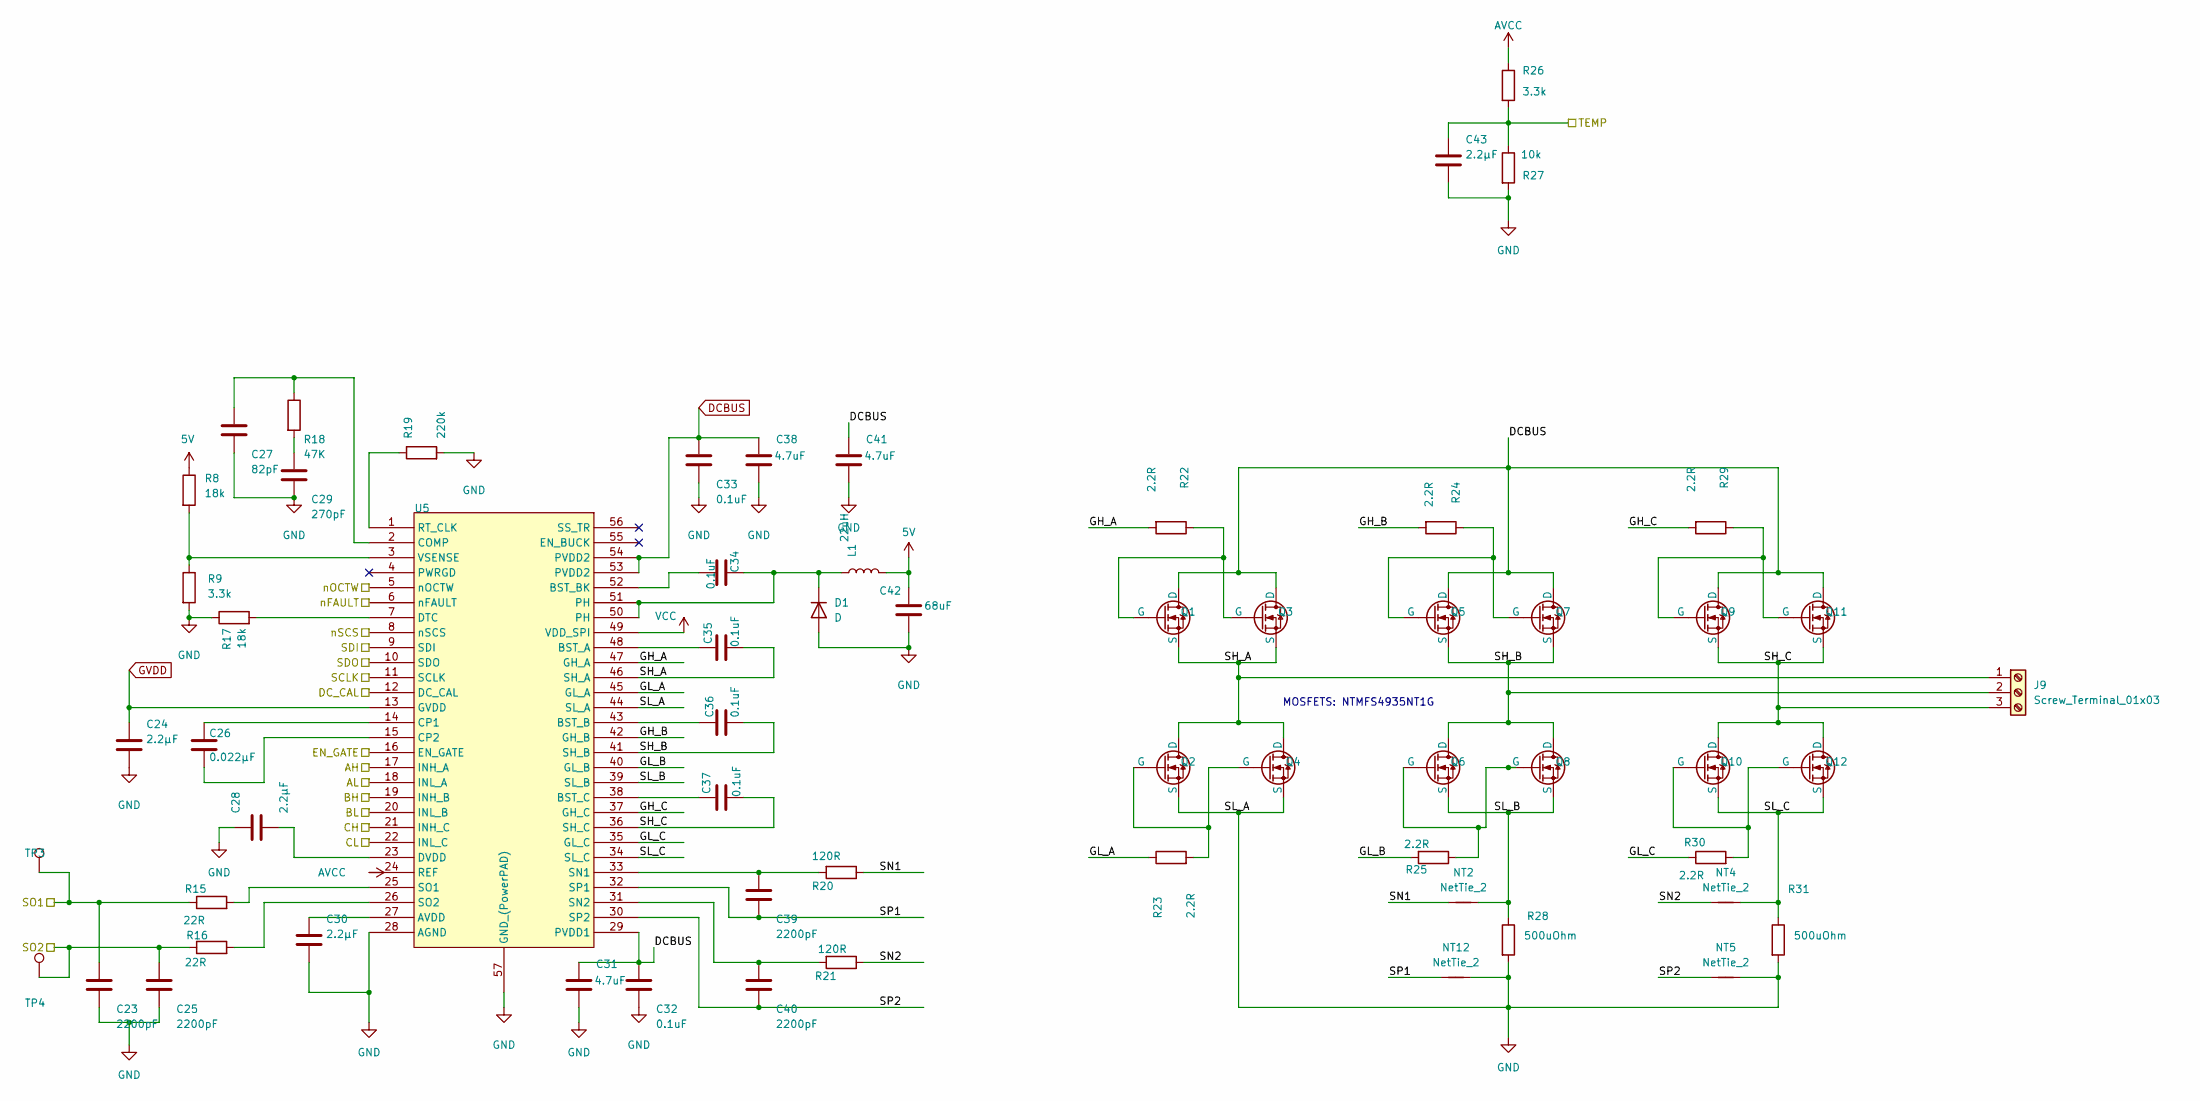
[picture p40: schematic motor0.kicad_sch]

Parts:
C23, C25, C39, C40: 2200pF; C_0603_1608Metric; TOLERANCE ±5%; VOLTAGE - RATED 50V; PART STATUS Active
C24, C28, C30, C43: 2.2µF; C_0603_1608Metric; TOLERANCE ±10%; VOLTAGE - RATED 16V; MANUFACTURER PART NUMBER GRM188R61C225KE15D
C26: 0.022µF; C_0603_1608Metric; TOLERANCE ±10%; VOLTAGE - RATED 50V; MANUFACTURER PART NUMBER GRM188R71H223KA01D
C27: 82pF; C_0603_1608Metric; TOLERANCE ±5%; VOLTAGE - RATED 100V; MANUFACTURER PART NUMBER GRM1885C2A820JA01D
C29: 270pF; C_0603_1608Metric; TOLERANCE ±5%; VOLTAGE - RATED 50V; MANUFACTURER PART NUMBER GRM1885C1H271JA01D
C31, C38, C41: 4.7uF; C_0805_2012Metric; TOLERANCE ±10%; VOLTAGE - RATED 35V; PART STATUS Active
C32, C33, C34, C35, C36, C37: 0.1uF; C_0603_1608Metric; TOLERANCE ±10%; VOLTAGE - RATED 50V; MANUFACTURER PART NUMBER GRM188R71H104KA93D
C42: 68uF; CP_EIA-6032-28_Kemet-C; TOLERANCE ±20%; PART STATUS Active
D1: D; D_SOD-123F
J9: Screw_Terminal_01x03; TerminalBlock_MetzConnect_Type011_RT05503HBWC_1x03_P5.00mm_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
L1: 22uH; L_Taiyo-Yuden_NR-60xx
NT2, NT4, NT5, NT12: NetTie_2; NetTie-2_SMD_Pad0.5mm
Q1, Q2, Q3, Q4, Q5, Q6, Q8, Q9, Q10, Q12: ONSemi_SO-8FL_488AA; DRIVE VOLTAGE (MAX RDS 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 4.5V, 10V; PART STATUS Active
Q7, Q11: FILL_FOOTPRINT; ONSemi_SO-8FL_488AA; DRIVE VOLTAGE (MAX RDS 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 4.5V, 10V; PART STATUS Active
R8, R17: 18k; R_0603_1608Metric; TOLERANCE ±1%; MANUFACTURER PART NUMBER RC0603FR-0718KL
R9, R26: 3.3k; R_0603_1608Metric; TOLERANCE ±1%; MANUFACTURER PART NUMBER RC0603FR-073K3L
R15, R16: 22R; R_0603_1608Metric; TOLERANCE ±1%; MANUFACTURER PART NUMBER RC0603FR-0722RL
R18: 47K; R_0603_1608Metric; TOLERANCE ±1%; MANUFACTURER PART NUMBER RC0603FR-0747KL
R19: 220k; R_0603_1608Metric; TOLERANCE ±1%; MANUFACTURER PART NUMBER RC0603FR-07220KL
R20, R21: 120R; R_0603_1608Metric; TOLERANCE ±1%; MANUFACTURER PART NUMBER RC0603FR-07120RL
R22, R23, R24, R25, R29, R30: 2.2R; R_0603_1608Metric; TOLERANCE ±1%; MANUFACTURER PART NUMBER RC0603FR-072R2L
R27: 10k; R_0402_1005Metric
R28, R31: 500uOhm; R_2512_6332Metric; TOLERANCE ±1%; PART STATUS Active
TP3, TP4: TESTPOINT; TestPoint_Pad_1.0x1.0mm
U5: HTSSOP-56-1EP_6.1x14mm_P0.5mm_EP3.61x6.35mm

Connections:
5V: C42.1, L1.2, R8.1; also elsewhere on the board
/EN_GATE: U5.16 (EN_GATE); also elsewhere on the board
/M0_AH: U5.17 (INH_A); also elsewhere on the board
/M0_AL: U5.18 (INL_A); also elsewhere on the board
/M0_BH: U5.19 (INH_B); also elsewhere on the board
/M0_BL: U5.20 (INL_B); also elsewhere on the board
/M0_CH: U5.21 (INH_C); also elsewhere on the board
/M0_CL: U5.22 (INL_C); also elsewhere on the board
/M0_DC_CAL: U5.12 (DC_CAL); also elsewhere on the board
/M0_SO1: C23.1, R15.1, TP3.1; also elsewhere on the board
/M0_SO2: C25.1, R16.1, TP4.1; also elsewhere on the board
/M0_TEMP: C43.1, R26.2, R27.1; also elsewhere on the board
/M0_nCS: U5.8 (nSCS); also elsewhere on the board
/Motor 0/GH_A: R22.2, U5.47 (GH_A)
/Motor 0/GH_B: R24.2, U5.42 (GH_B)
/Motor 0/GH_C: R29.2, U5.37 (GH_C)
/Motor 0/GL_A: R23.1, U5.45 (GL_A)
/Motor 0/GL_B: R25.2, U5.40 (GL_B)
/Motor 0/GL_C: R30.1, U5.35 (GL_C)
/Motor 0/SH_A: C35.2, J9.1, Q1.1 (S), Q2.5 (D), Q3.1 (S), Q4.5 (D), U5.46 (SH_A)
/Motor 0/SH_B: C36.2, J9.2, Q5.1 (S), Q6.5 (D), Q7.1 (S), Q8.5 (D), U5.41 (SH_B)
/Motor 0/SH_C: C37.2, J9.3, Q9.1 (S), Q10.5 (D), Q11.1 (S), Q12.5 (D), U5.36 (SH_C)
/Motor 0/SL_B: NT2.2, Q6.1 (S), Q8.1 (S), R28.1, U5.39 (SL_B)
/Motor 0/SL_C: NT4.2, Q10.1 (S), Q12.1 (S), R31.1, U5.34 (SL_C)
/Motor 0/SN1: NT2.1, R20.1
/Motor 0/SN2: NT4.1, R21.1
/Motor 0/SP1: C39.2, NT12.1, U5.32 (SP1)
/Motor 0/SP2: C40.2, NT5.1, U5.30 (SP2)
/Motor 0/nOCTW: U5.5 (nOCTW)
/SPI_MISO: U5.10 (SDO); also elsewhere on the board
/SPI_MOSI: U5.9 (SDI); also elsewhere on the board
/SPI_SCK: U5.11 (SCLK); also elsewhere on the board
/nFAULT: U5.6 (nFAULT); also elsewhere on the board
AVCC: R26.1, U5.24 (REF); also elsewhere on the board
DCBUS: C31.1, C32.1, C33.1, C38.1, C41.1, Q1.5 (D), Q3.5 (D), Q5.5 (D), Q7.5 (D), Q9.5 (D), Q11.5 (D), U5.29 (PVDD1), U5.53 (PVDD2), U5.54 (PVDD2); also elsewhere on the board
GND: C23.2, C24.2, C25.2, C27.2, C28.1, C29.2, C30.2, C31.2, C32.2, C33.2, C38.2, C41.2, C42.2, C43.2, D1.2 (A), NT5.2, NT12.2, Q2.1 (S), Q4.1 (S), R9.2, R17.1, R19.2, R27.2, R28.2, R31.2, U5.28 (AGND), U5.44 (SL_A), U5.57 (GND_(PowerPAD)); also elsewhere on the board
GVDD: C24.1, U5.13 (GVDD); also elsewhere on the board
unnamed: C29.1, R18.2
unnamed: C34.1, D1.1 (K), L1.1, U5.50 (PH), U5.51 (PH)
unnamed: Q1.4 (G), Q3.4 (G), R22.1
unnamed: Q2.4 (G), Q4.4 (G), R23.2
unnamed: Q5.4 (G), Q7.4 (G), R24.1
unnamed: Q6.4 (G), Q8.4 (G), R25.1
unnamed: Q10.4 (G), Q12.4 (G), R30.2
unnamed: Q9.4 (G), Q11.4 (G), R29.1
unnamed: C30.1, U5.27 (AVDD)
unnamed: C35.1, U5.48 (BST_A)
unnamed: C36.1, U5.43 (BST_B)
unnamed: C34.2, U5.52 (BST_BK)
unnamed: C37.1, U5.38 (BST_C)
unnamed: C27.1, R18.1, U5.2 (COMP)
unnamed: C26.1, U5.14 (CP1)
unnamed: C26.2, U5.15 (CP2)
unnamed: R17.2, U5.7 (DTC)
unnamed: C28.2, U5.23 (DVDD)
unnamed: R19.1, U5.1 (RT_CLK)
unnamed: C39.1, R20.2, U5.33 (SN1)
unnamed: C40.1, R21.2, U5.31 (SN2)
unnamed: R15.2, U5.25 (SO1)
unnamed: R16.2, U5.26 (SO2)
unnamed: R8.2, R9.1, U5.3 (VSENSE)
VCC: U5.49 (VDD_SPI); also elsewhere on the board

Notes on the sheet:
MOSFETS: NTMFS4935NT1G

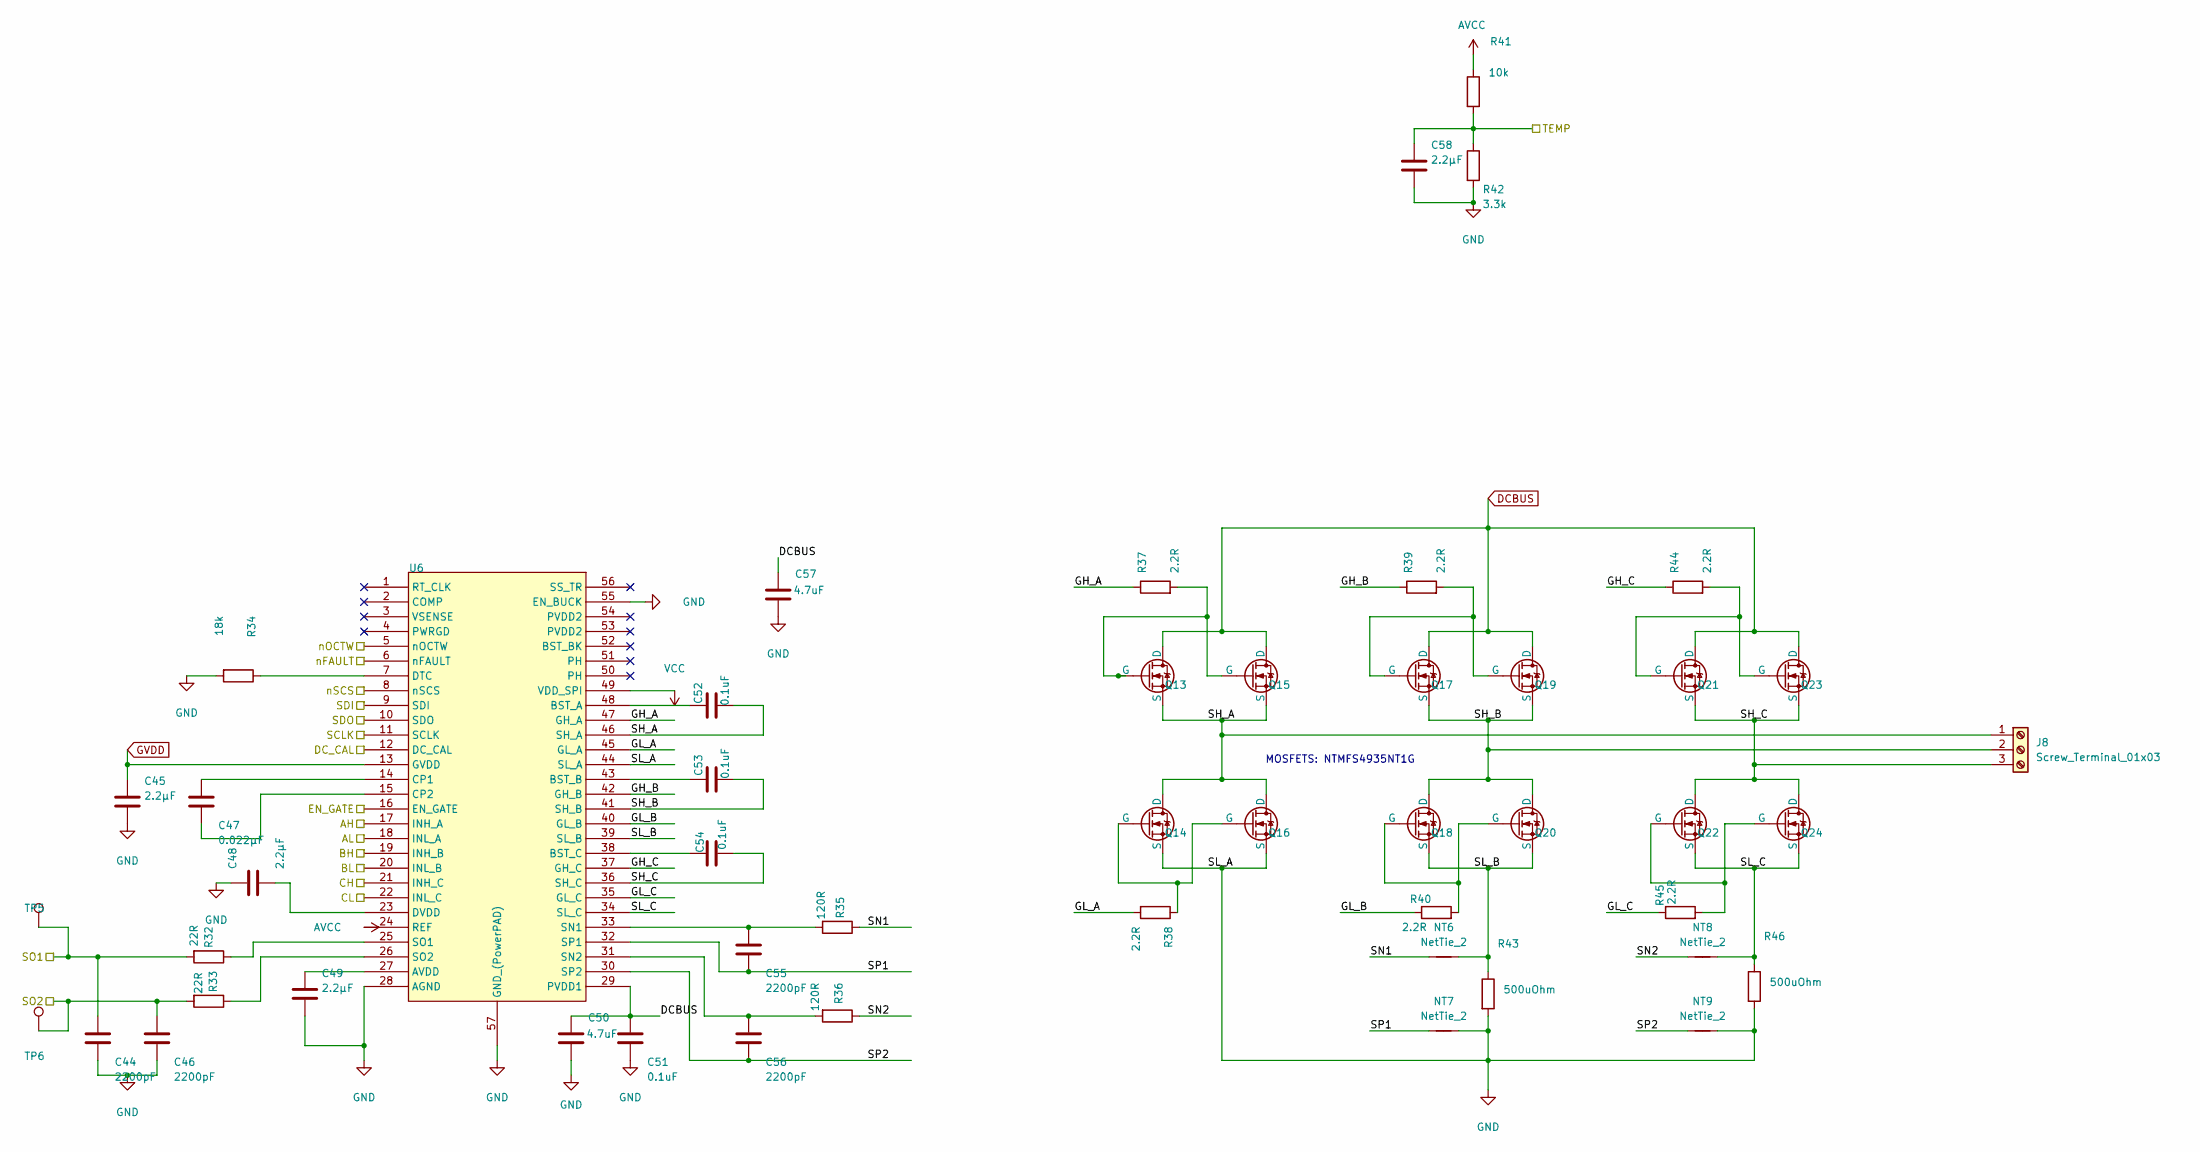
[picture p41: schematic motor1.kicad_sch]

Parts:
C44, C46, C55, C56: 2200pF; C_0603_1608Metric; TOLERANCE ±5%; VOLTAGE - RATED 50V; PART STATUS Active
C45, C48, C49, C58: 2.2µF; C_0603_1608Metric; TOLERANCE ±10%; VOLTAGE - RATED 16V; MANUFACTURER PART NUMBER GRM188R61C225KE15D
C47: 0.022µF; C_0603_1608Metric; TOLERANCE ±10%; VOLTAGE - RATED 50V; MANUFACTURER PART NUMBER GRM188R71H223KA01D
C50, C57: 4.7uF; C_0805_2012Metric; TOLERANCE ±10%; VOLTAGE - RATED 35V; PART STATUS Active
C51, C52, C53, C54: 0.1uF; C_0603_1608Metric; TOLERANCE ±10%; VOLTAGE - RATED 50V; MANUFACTURER PART NUMBER GRM188R71H104KA93D
J8: Screw_Terminal_01x03; TerminalBlock_MetzConnect_Type011_RT05503HBWC_1x03_P5.00mm_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
NT6, NT7, NT8, NT9: NetTie_2; NetTie-2_SMD_Pad0.5mm
Q13, Q14, Q16, Q17, Q18, Q20, Q21, Q22, Q24: ONSemi_SO-8FL_488AA; DRIVE VOLTAGE (MAX RDS 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 4.5V, 10V; PART STATUS Active
Q15, Q19, Q23: FILL_FOOTPRINT; ONSemi_SO-8FL_488AA; DRIVE VOLTAGE (MAX RDS 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 4.5V, 10V; PART STATUS Active
R32, R33: 22R; R_0603_1608Metric; TOLERANCE ±1%; MANUFACTURER PART NUMBER RC0603FR-0722RL
R34: 18k; R_0603_1608Metric; TOLERANCE ±1%; MANUFACTURER PART NUMBER RC0603FR-0718KL
R35, R36: 120R; R_0603_1608Metric; TOLERANCE ±1%; MANUFACTURER PART NUMBER RC0603FR-07120RL
R37, R38, R39, R40, R44, R45: 2.2R; R_0603_1608Metric; TOLERANCE ±1%; MANUFACTURER PART NUMBER RC0603FR-072R2L
R41: 10k; R_0402_1005Metric
R42: 3.3k; R_0603_1608Metric; TOLERANCE ±1%; MANUFACTURER PART NUMBER RC0603FR-073K3L
R43, R46: 500uOhm; R_2512_6332Metric; TOLERANCE ±1%; PART STATUS Active
TP5, TP6: TESTPOINT; TestPoint_Pad_1.0x1.0mm
U6: HTSSOP-56-1EP_6.1x14mm_P0.5mm_EP3.61x6.35mm

Connections:
/EN_GATE: U6.16 (EN_GATE); also elsewhere on the board
/M1_AH: U6.17 (INH_A); also elsewhere on the board
/M1_AL: U6.18 (INL_A); also elsewhere on the board
/M1_BH: U6.19 (INH_B); also elsewhere on the board
/M1_BL: U6.20 (INL_B); also elsewhere on the board
/M1_CH: U6.21 (INH_C); also elsewhere on the board
/M1_CL: U6.22 (INL_C); also elsewhere on the board
/M1_DC_CAL: U6.12 (DC_CAL); also elsewhere on the board
/M1_NCS: U6.8 (nSCS); also elsewhere on the board
/M1_SO1: C44.1, R32.2, TP5.1; also elsewhere on the board
/M1_SO2: C46.1, R33.2, TP6.1; also elsewhere on the board
/M1_TEMP: C58.1, R41.2, R42.1, U6.5 (nOCTW); also elsewhere on the board
/Motor 1/GH_A: R37.1, U6.47 (GH_A)
/Motor 1/GH_B: R39.1, U6.42 (GH_B)
/Motor 1/GH_C: R44.1, U6.37 (GH_C)
/Motor 1/GL_A: R38.2, U6.45 (GL_A)
/Motor 1/GL_B: R40.1, U6.40 (GL_B)
/Motor 1/GL_C: R45.1, U6.35 (GL_C)
/Motor 1/SH_A: C52.1, J8.1, Q13.1 (S), Q14.5 (D), Q15.1 (S), Q16.5 (D), U6.46 (SH_A)
/Motor 1/SH_B: C53.2, J8.2, Q17.1 (S), Q18.5 (D), Q19.1 (S), Q20.5 (D), U6.41 (SH_B)
/Motor 1/SH_C: C54.2, J8.3, Q21.1 (S), Q22.5 (D), Q23.1 (S), Q24.5 (D), U6.36 (SH_C)
/Motor 1/SL_B: NT6.2, Q18.1 (S), Q20.1 (S), R43.1, U6.39 (SL_B)
/Motor 1/SL_C: NT8.2, Q22.1 (S), Q24.1 (S), R46.1, U6.34 (SL_C)
/Motor 1/SN1: NT6.1, R35.1
/Motor 1/SN2: NT8.1, R36.1
/Motor 1/SP1: C55.2, NT7.1, U6.32 (SP1)
/Motor 1/SP2: C56.2, NT9.1, U6.30 (SP2)
/SPI_MISO: U6.10 (SDO); also elsewhere on the board
/SPI_MOSI: U6.9 (SDI); also elsewhere on the board
/SPI_SCK: U6.11 (SCLK); also elsewhere on the board
/nFAULT: U6.6 (nFAULT); also elsewhere on the board
AVCC: R41.1, U6.24 (REF); also elsewhere on the board
DCBUS: C50.1, C51.1, C57.1, Q13.5 (D), Q15.5 (D), Q17.5 (D), Q19.5 (D), Q21.5 (D), Q23.5 (D), U6.29 (PVDD1); also elsewhere on the board
GND: C44.2, C45.2, C46.2, C48.1, C49.2, C50.2, C51.2, C57.2, C58.2, NT7.2, NT9.2, Q14.1 (S), Q16.1 (S), R34.2, R42.2, R43.2, R46.2, U6.28 (AGND), U6.44 (SL_A), U6.55 (EN_BUCK), U6.57 (GND_(PowerPAD)); also elsewhere on the board
GVDD: C45.1, U6.13 (GVDD); also elsewhere on the board
unnamed: Q13.4 (G), Q15.4 (G), R37.2
unnamed: Q14.4 (G), Q16.4 (G), R38.1
unnamed: Q17.4 (G), Q19.4 (G), R39.2
unnamed: Q18.4 (G), Q20.4 (G), R40.2
unnamed: Q21.4 (G), Q23.4 (G), R44.2
unnamed: Q22.4 (G), Q24.4 (G), R45.2
unnamed: C49.1, U6.27 (AVDD)
unnamed: C52.2, U6.48 (BST_A)
unnamed: C53.1, U6.43 (BST_B)
unnamed: C54.1, U6.38 (BST_C)
unnamed: C47.1, U6.14 (CP1)
unnamed: C47.2, U6.15 (CP2)
unnamed: R34.1, U6.7 (DTC)
unnamed: C48.2, U6.23 (DVDD)
unnamed: C55.1, R35.2, U6.33 (SN1)
unnamed: C56.1, R36.2, U6.31 (SN2)
unnamed: R32.1, U6.25 (SO1)
unnamed: R33.1, U6.26 (SO2)
VCC: U6.49 (VDD_SPI); also elsewhere on the board

Notes on the sheet:
MOSFETS: NTMFS4935NT1G

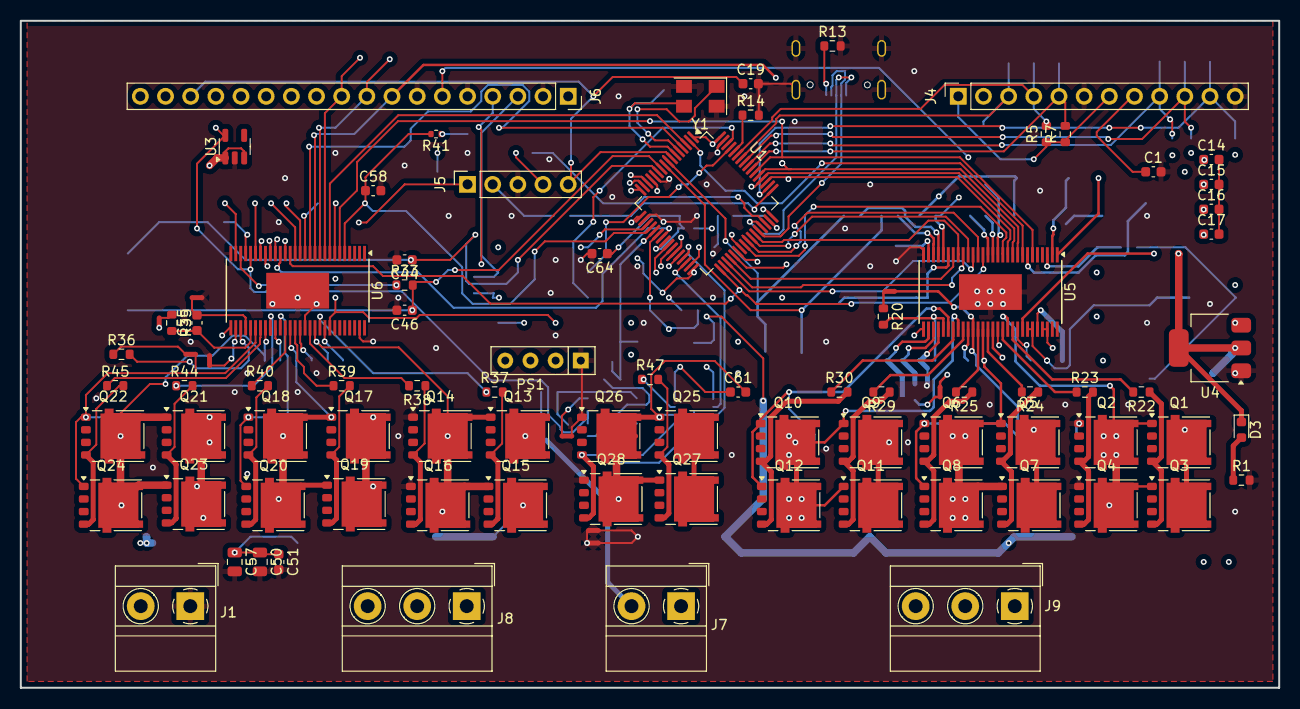
[picture p42: board ControllerTop.kicad_pcb from above]

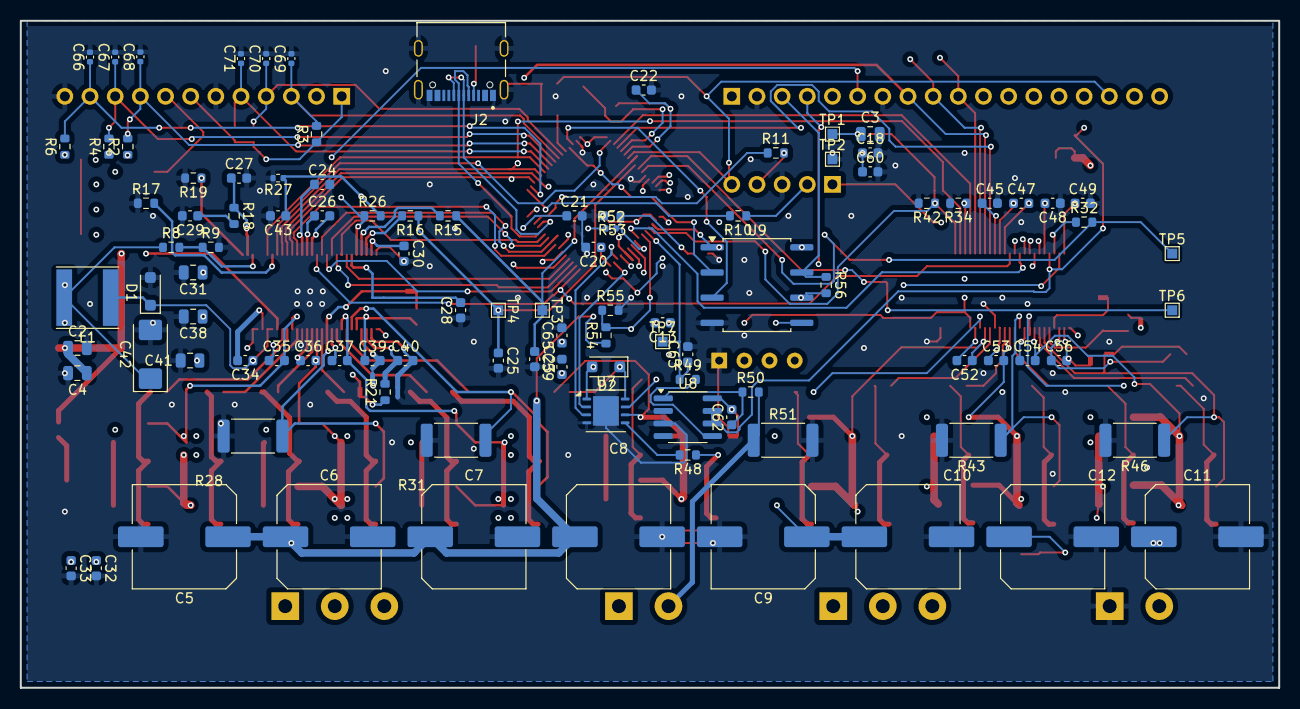
[picture p43: board ControllerTop.kicad_pcb from below]

Board: 4 copper layers, 127.0 x 67.3 mm, 194 parts (104 on the bottom side), 153 nets.

Other parts of the board:
C59, C64: 2.2µF; C_0603_1608Metric
C60, C61: 0.1uF; C_0603_1608Metric
C62, C63: 2200pF; C_0603_1608Metric
D2: D; D_SOD-123F
J7: Screw_Terminal_01x02; TerminalBlock_MetzConnect_Type011_RT05502HBWC_1x02_P5.00mm_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
NT3, NT10: NetTie_2; NetTie-2_SMD_Pad0.5mm
Q25: FILL_FOOTPRINT; ONSemi_SO-8FL_488AA
Q26, Q27, Q28: ONSemi_SO-8FL_488AA
R47, R48: 2.2R; R_0603_1608Metric
R49, R50: 120R; R_0603_1608Metric
R51: 500uOhm; R_2512_6332Metric
R52: 10k; R_0402_1005Metric
R53: 3.3k; R_0603_1608Metric
TP7: TESTPOINT; TestPoint_Pad_1.0x1.0mm
U7: WSON-8-1EP_4x4mm_P0.8mm_EP2.6x3mm
U8: SOIC-8_3.9x4.9mm_P1.27mm

Their connections:
/AUX_H: U7.2 (HI); also elsewhere on the board
/AUX_I: C63.1, R49.1, TP7.1; also elsewhere on the board
/AUX_L: U7.3 (LI); also elsewhere on the board
/AUX_TEMP: C64.1, R52.2, R53.1; also elsewhere on the board
/Aux/DCBUS: Q25.5 (D), Q27.5 (D)
AVCC: C60.1, R52.1, U8.6 (Vs), U8.7 (Vref_1); also elsewhere on the board
GND: C59.2, C60.2, C63.2, C64.2, NT3.2, NT10.1, NT10.2, Q26.1 (S), Q28.1 (S), R51.2, R53.2, U7.4 (VSS), U7.9 (Thermal_Pad), U8.2 (GND), U8.3 (Vref_2); also elsewhere on the board
GVDD: C59.1, D2.2 (A), U7.1 (VDD); also elsewhere on the board
unnamed: C61.1, D2.1 (K), U7.8 (HB)
unnamed: C61.2, J7.1, Q25.1 (S), Q26.5 (D), Q27.1 (S), Q28.5 (D), U7.6 (HS)
unnamed: J7.2, R50.2, R51.1
unnamed: Q25.4 (G), Q27.4 (G), R47.2
unnamed: Q26.4 (G), Q28.4 (G), R48.1
unnamed: R47.1, U7.7 (HO)
unnamed: R48.2, U7.5 (LO)
unnamed: C62.2, NT3.1, U8.8 (+IN)
unnamed: C62.1, R50.1, U8.1 (-IN)
unnamed: R49.2, U8.5 (OUT)
