kscalelabs/motor-controller/(commit log)

2024-06-18 Initial Commit with Rev 1-3
    [ControllerTop.kicad_pcb, ControllerTop.kicad_sch, ControllerV2Kicad.kicad_pcb, ControllerV2Kicad.kicad_sch, ControllerV3.kicad_pcb, ControllerV3.kicad_sch, Encoder.kicad_sch, aux.kicad_sch]
2024-06-26 Added temporary v4 changes
    [ControllerV4.kicad_pcb, ControllerV4.kicad_sch, Encoder.kicad_sch, Ethernet.kicad_sch, bom.csv, bomv3auto.csv, designators.csv, motor0.kicad_sch]
2024-06-26 Renamed aux
    [brake.kicad_sch]
2024-06-26 renamed all aux and fix file pathing error
    [ControllerTop.kicad_sch, ControllerV2Kicad.kicad_sch]
2024-06-28 Initial folder structure changes for etherCAT
    [ControllerTop.kicad_pcb, ControllerTop.kicad_sch, ControllerV2Kicad.kicad_pcb, ControllerV2Kicad.kicad_sch, ControllerV3.kicad_pcb, ControllerV3.kicad_sch, ControllerV4.kicad_pcb, ControllerV4.kicad_sch]
2024-07-01 added initial files for ethercat design
    [Connectors.kicad_sch, Encoders.kicad_sch, EtherCAT.kicad_sch, EtherCATControllerV1.kicad_pcb, EtherCATControllerV1.kicad_sch, MCU.kicad_sch, MOSFETs.kicad_sch, Motor.kicad_sch]
2024-07-02 Initial design without Ethernet connectors
    [Connectors.kicad_sch, Encoders.kicad_sch, EtherCAT.kicad_sch, EtherCATControllerV1.kicad_sch, MCU.kicad_sch, MOSFETs.kicad_sch, Motor.kicad_sch, Power.kicad_sch]
2024-07-03 Added IO Board project
    [Connectors.kicad_sch, Encoders.kicad_sch, EtherCAT.kicad_sch, EtherCATControllerV1.kicad_sch, IOBoardV1.kicad_pcb, IOBoardV1.kicad_sch, MOSFETs.kicad_sch, Power.kicad_sch]
2024-07-03 checkpoint commit
    [IOBoardV1.kicad_sch]
2024-07-03 schematic finished, need to set proper ERCs
    [Connectors.kicad_sch, Encoders.kicad_sch, EtherCAT.kicad_sch, EtherCATControllerV1.kicad_sch, IOBoardV1.kicad_sch, MCU.kicad_sch, Power.kicad_sch]
2024-07-04 fix all ERCs
    [Connectors.kicad_sch, EtherCAT.kicad_sch, MOSFETs.kicad_sch, Motor.kicad_sch, Power.kicad_sch]
2024-07-06 Added more BOM items
    [Encoders.kicad_sch, EtherCAT.kicad_sch, EtherCATControllerV1.kicad_pcb, EtherCATControllerV1.kicad_sch, IOBoardV1.kicad_sch, MCU.kicad_sch, MOSFETs.kicad_sch, Motor.kicad_sch]
2024-07-09 Renamed folder names
    [Connectors.kicad_sch, Encoders.kicad_sch, EtherCAT.kicad_sch, EtherCATControllerHP.kicad_pcb, EtherCATControllerHP.kicad_sch, IOBoard.kicad_pcb, IOBoard.kicad_sch, IOBoardV1.kicad_pcb]
2024-07-09 added low power variant with single mosfet
    [Connectors.kicad_sch, Encoders.kicad_sch, EtherCAT.kicad_sch, EtherCATControllerLP.kicad_pcb, EtherCATControllerLP.kicad_sch, MCU.kicad_sch, MOSFETs.kicad_sch, Motor.kicad_sch]
2024-07-10 IO Board for LP variant finished
    [Connectors.kicad_sch, Encoders.kicad_sch, EtherCAT.kicad_sch, EtherCATControllerHP.kicad_pcb, EtherCATControllerHP.kicad_sch, EtherCATControllerLP.kicad_pcb, EtherCATControllerLP.kicad_sch, IOBoard.kicad_pcb]
2024-07-10 remove locks
    [IOBoard.kicad_pcb]
2024-07-12 Checkpoint changes before switching to XMC4800
    [Connectors.kicad_sch, Encoders.kicad_sch, EtherCATControllerLP.kicad_sch, MCU.kicad_sch, Motor.kicad_sch, Power.kicad_sch]
2024-07-13 Finished new 2+2 IOboard
    [CAN.kicad_sch, Connectors.kicad_sch, EtherCATControllerLP.kicad_sch, IOBoard.kicad_pcb, IOBoard.kicad_sch]
2024-07-17 Added XMC4800
    [Connectors.kicad_sch, EtherCAT.kicad_sch, IOBoard.kicad_sch, MCU.kicad_sch, Power.kicad_sch, Regulators.kicad_sch]
2024-07-25 Added Ethernet PHY
    [Connectors.kicad_sch, EtherCAT.kicad_sch, EtherCATControllerLP.kicad_pcb, MCU.kicad_sch]
2024-07-26 added stm32 variant back
    [CAN.kicad_sch, Connectors.kicad_sch, Encoders.kicad_sch, EtherCAT.kicad_sch, EtherCATControllerHP.kicad_pcb, EtherCATControllerHP.kicad_sch, EtherCATControllerLP.kicad_pcb, EtherCATControllerLP.kicad_sch]
2024-07-27 starting HP version
    [CAN.kicad_sch, Connectors.kicad_sch, Encoders.kicad_sch, EtherCAT.kicad_sch, EtherCATControllerHP.kicad_pcb, EtherCATControllerHP.kicad_sch, EtherCATSTM32.kicad_pcb, EtherCATSTM32.kicad_sch]
2024-07-30 stash before via stitching
    [CAN.kicad_sch, Connectors.kicad_sch, EtherCAT.kicad_sch, EtherCATControllerHP.kicad_pcb, EtherCATControllerHP.kicad_sch, MCU.kicad_sch, MOSFETs.kicad_sch, Motor.kicad_sch]
2024-07-31 finished with HP controller
    [Connectors.kicad_sch, EtherCATControllerHP.kicad_pcb, MCU.kicad_sch, MOSFETs.kicad_sch, bom.csv, designators.csv, positions.csv]
2024-07-31 production files
    [EtherCATControllerHP.kicad_pcb, designators.csv, positions.csv]
2024-08-06 redid layout and mounting
    [Connectors.kicad_sch, EtherCAT.kicad_sch, EtherCATControllerHP.kicad_pcb, MCU.kicad_sch, MOSFETs.kicad_sch, Motor.kicad_sch, Power.kicad_sch]
2024-08-07 fix part number
    [CAN.kicad_sch]
2024-08-09 fixed bom
    [Encoders.kicad_sch, MCU.kicad_sch]
